jharvey/FPGA_CAM-LCD/README.md

## Phase order (do not skip)

1. Cleanup / hierarchy (done / finishing)
2. Power input redesign (3×18650)
3. Camera + display connectors/sheets
4. Mechanical outline / placement
5. BOM + JLCPCB

## When unsure

- Ask before deleting anything on `power`, `usb`, `ram`, `flash`, or `wifi`.
- Prefer “mark for deletion” + commit message over silent large deletes.
- Reference `ROADMAP.md` for locked decisions.
