jharvey/FPGA_CAM-LCD/ROADMAP.md

# Monocular FPGA Vision Device – Roadmap

**Repo**: https://github.com/jharvey/FPGA_CAM-LCD  
**Branch**: `monocular-strip`  
**Base**: ULX3S open hardware (emard)  
**Goal**: Single-board monocular with ECP5 + OV7670 + Newhaven 2.1" TFT + 3×18650 + USB charging + WiFi + SD

---

## Current status

| Phase | Description | Status |
|---|---|---|
| 0 | Architecture decisions locked | Done |
| 1 | Branch created, cleanup | Done |
| 2 | Power input redesign (3×18650 + monitoring) | **Done** – schematic frozen (CE drive later) |
| 2b | USB-C 5 V PD trigger | **Done** – CH224K 5 V-only sink on the USB-C port (schematic) |
| 2c | Single USB-C (power + SD + programming) | **Done** – ESP32-S3 native USB, USBLC6 ESD, FTDI/micro-B fallback DNP (schematic) |
| 3 | Camera + display connectors / sheets | **Done** – schematic frozen |
| – | **Schematic freeze** | **Frozen** – ERC fully classified, see `doc/constraints/schematic_freeze.md` |
| 3b | IMU (6-axis) | **Done** – ICM-42688-P on I²C to FPGA (schematic) |
| 3c | RC servo headers | **Done (DNP)** – 6× 1x3 headers on `servo` sheet; SERVO_V source open |
| 4 | PCB mechanical outline (monocular form) | **In progress** – placement complete; routing step 1 done (rules, planes, fan-out, decoupling – 4.11); next: high-speed nets |
| 5 | BOM / JLCPCB / first prototype | Pending |

---

## Decisions (locked)

- Full single PCB (not shield)
- Keep ECP5-85F, SDRAM, flash, WiFi, SD card
- **One USB-C port** for power/charging, SD card (USB MSC) and programming; the ESP32-S3 (native USB) is the USB device and the ECP5 programmer (Phase 2c). FTDI / micro-B kept only as DNP fallback
- Remove GPDI, large GPIO headers, audio
- 3 independent 18650 cells with ideal-diode OR-ing (LM66100), hot-swap capable
- Cell interface: PCB-mounted Keystone-style contacts per cell – positive button **MY-18650-04-J (LCSC C19184125)**, negative spring **MY-18650-05-J (LCSC C19184124)** (MYOUNG); replaces the JST-PH placeholders
- Per-cell reverse-polarity protection (AO3401A) + TP4056 chargers
- **8-channel ADC**: AD7689 (16-bit, SPI) replaced ADS1115; absolute 2.5 V reference so measurements are non-ratiometric
- ADC channels used for: per-cell voltages, NTC / temperature, +V / VSYS rail sense, and spare channels
- ADC VDD from a small always-on 3.3 V LDO (XC6206 → VADC) fed from VSYS; ADC VIO from +3V3 (matches ESP32 SPI levels)
- ST pins of all LM66100s tied to GND through 0 Ω links (removable later)
- VSYS = OR of (VBAT_OR + USB 5 V)
- Soft-shutdown path (Q2 / SHUT) retained
- Individual cell enable/control (CE pins) planned so the most-depleted cell can be consumed first (firmware-driven, later)
- Bulk capacitance after ideal-diode OR-ing for contact bounce / vibration
- Optional later boost stage to recover the bottom ~5–15 % capacity once cells fall below ~3.5 V
- Camera: OV7670 parallel + SCCB
- Display: NHD-2.1-480480AF-ASXP (40-pin FFC, RGB + SPI)
- Case: 3D-printed first → metal later

### Power / charging evolution
- **Near-term (done, Phase 2b)**: USB-C PD sink / trigger **WCH CH224K (LCSC C970725)** fixed to request **5 V only** on a new USB-C charge port. Keeps existing TP4056 linear chargers.
- **Longer-term**: Evaluate higher-voltage / higher-wattage PD path (9–20 V) together with switching chargers or a multi-cell charger IC for significantly higher total charge power.

### Sensors
- IMU added now (Phase 3b): TDK InvenSense **ICM-42688-P**, LCSC **C1850418** (JLCPCB extended part), I²C to the FPGA. See Phase 3b.

---

## Phase details

### Phase 1 – Branch & cleanup (NOW)
- [x] Create `monocular-strip` branch
- [x] Update `.gitignore`
- [x] Delete unused sheets: gpdi, gpio, analog, serdes (optionally blinkey)
- [x] Remove corresponding hierarchical blocks from root sheet
- [x] Commit: "strip unused ULX3S sheets for monocular"

### Phase 2 – Power input redesign
- [x] Replace single-cell input with 3×18650 paths
- [x] Per-cell: AO3401A reverse protection, TP4056 charger, LM66100 ideal diode
- [x] Cell connection changed from JST-PH (J8/J9/J10, **removed**) to PCB spring/button contacts, one pair per cell:
  | Cell | Positive button → `CELLn_RAW` (AO3401A drain) | Negative spring → GND |
  |---|---|---|
  | 1 | BT11 MY-18650-04-J (LCSC **C19184125**) | BT12 MY-18650-05-J (LCSC **C19184124**) |
  | 2 | BT21 MY-18650-04-J (C19184125) | BT22 MY-18650-05-J (C19184124) |
  | 3 | BT31 MY-18650-04-J (C19184125) | BT32 MY-18650-05-J (C19184124) |

  AO3401A / TP4056 / LM66100 path unchanged. Note on the power sheet: the contacts are for a plastic battery bay that provides mechanical retention and cell-length tolerance.
  - [ ] Phase 4: create/import footprints for BT11–BT32 (LCSC lists them as "SMT" in the title but "TH" in the attributes – confirm from the datasheet / EasyEDA model) and define the bay geometry (contact spacing for 65 mm cells + spring travel).
- [x] VBAT_OR + USB → VSYS via additional LM66100s
- [x] ~~ADS1115 (0x48) on WIFI_GPIO21/22~~ – superseded by AD7689 (below)
- [x] Always-on 3.3 V LDO from VSYS for the ADC (U20 XC6206 → VADC)
- [x] ST pins of all five LM66100s linked to GND via 0 Ω (R46, R47, R48, R51, R55)
- [x] TLV62569 inputs and wake circuit moved to VSYS
- [x] LCD backlight boost input renamed to VSYS
- [x] **Replace ADS1115 with 8-channel ADC** – U21 AD7689BCPZ, SPI to ESP32: SDO=WIFI_GPIO19, DIN=WIFI_GPIO21, SCK=WIFI_GPIO22, CNV=WIFI_GPIO26 (renumbered for the ESP32-S3 in Phase 2c: SDO=WIFI_GPIO6, DIN=WIFI_GPIO21, SCK=WIFI_GPIO8, CNV=WIFI_GPIO9; moved again in 4.23: SDO=WIFI_GPIO36, DIN=WIFI_GPIO48, SCK=WIFI_GPIO35, CNV=WIFI_GPIO47)
  - IN0–IN2: VBAT1–3 via 47 k / 56 k dividers (4.2 V → 2.28 V), 100 nF filter caps
  - IN3: TEMP_BAT, 10 k pull-up (R43) + 10 k NTC (TH1)
  - IN4: REF3025 (U17) output – absolute-reference cross-check
  - IN5: VSYS_SENSE via 100 k / 68 k (5.25 V → 2.13 V)
  - IN6, IN7 spare and COM tied to GND via 0 Ω (R57, R58, R59) – lift to use
- [x] Add resistor divider for +V / VSYS rail sensing into the new ADC (R44/R45 → IN5)
- [x] Absolute reference / non-ratiometric: AD7689 internal 2.5 V reference (REF + 10 µF C68, REFIN + 100 nF C70). Firmware must set CFG.REF = internal 2.5 V.
- [x] **ADC reference loading** – chose option (a): NTC pull-up R43 now fed from REF3025 OUT (`VREF_SENSE`) instead of the AD7689 REF pin. The conversion reference (`VREF_2V5`, internal 2.5 V + C68) carries no DC load; cell / VSYS readings stay absolute (non-ratiometric). NTC: compute the divider ratio as IN3 / IN4 – both channels see the same REF3025 voltage, so the NTC result cancels both reference tolerances. No firmware config change (AD7689 stays in internal-reference mode). Option (b) rejected: it needs a config change, makes REF3025 drive the REF pin's switched load, and gives up the ADC's lower-drift internal reference.
- [x] Bulk capacitance: VBAT_OR = C58 10 µF + **C73 100 µF 1210 (CL32A107MPVNNNE, LCSC C23742)**; VSYS = 3× 22 µF (C1/C5/C9) + C63 10 µF. Revisit at layout (X5R DC-bias derating).
- [x] **LM66100 ~CE break-out** – U12/U14/U18 ~CE now on local nets `BAT1_CE` / `BAT2_CE` / `BAT3_CE`, tied to `VBAT_OR` through 0 Ω links R71 / R72 / R73 (0603, C21189, fitted). Behaviour unchanged (plain ideal-diode OR); the 0 Ω pads are the rework point for later control.
  - Control constraint (LM66100 datasheet): the device turns OFF when ~CE > VIN + 80 mV and ON when ~CE < VIN − 250 mV (~CE max 5.5 V). Forcing a cell off therefore needs ~CE driven above that cell's voltage (up to ~4.3 V), so a 3.3 V ESP32/FPGA GPIO needs a level shifter (e.g. small PFET or open-drain + pull-up to a rail above the highest cell). Forcing ON (pulling ~CE low) can back-feed the other cells, so avoid it.
  - [ ] Later: pick GPIO source (ESP32 / FPGA / I²C expander) and the level-shift circuit, together with firmware cell prioritisation.
- [ ] Expose TP4056 CE / ~CHRG status (currently CE tied to +5 V, ~CHRG drives LEDs only)
- [x] Schematic clean-up: 4 dangling wire stubs fixed (PWREN ×3, VBAT1)
- [x] Final KiCad ERC run – done in the schematic-freeze pass (`doc/constraints/schematic_freeze.md`): 179 items, all classified acceptable or deferred to layout. Orphan `ADC_*` labels on `ram` kept (harmless, unconnected FPGA pins). The unused ADS1115 cache entry drops on the next save in KiCad.
- [ ] ~~Add USB-C PD sink/trigger chip~~ → moved to **Phase 2b** (below)
- [ ] (Optional later) Boost stage to extract remaining capacity below ~3.5 V

### Phase 2b – USB-C 5 V PD trigger
- [x] New sheet `usbc_pd.kicad_sch`. The board had no USB-C connector (US1 FTDI and US2 OTG are micro-B), so a **dedicated power-only USB-C charge port** was added; both micro-B data ports are unchanged.
  | Ref | Part | LCSC | Role |
  |---|---|---|---|
  | U23 | **WCH CH224K** (ESSOP-10) | **C970725** | USB PD sink controller, 5 V only |
  | J17 | GCT USB4125-GF-A, USB-C 6P power-only | C3151650 (JLC extended) | charge port, footprint `USB_C_Receptacle_GCT_USB4125-xx-x_6P_TopMnt_Horizontal` |
  | D55 | SS34 Schottky 3 A / 40 V (SMA) | C8678 | VBUS_C → `+5V` OR-ing, parallel to D8/D9 |
  | R84 | 1 k 0603 | C21190 | VBUS_C → CH224K VDD (shunt regulator) |
  | C79 | 1 µF 0603 | C15849 | CH224K VDD decoupling |
  | R85 | 10 k 0402 | C25744 | CH224K VBUS sense |
  | C80 | 10 µF 0805 | C15850 | VBUS_C bulk |
- [x] **5 V only:** CH224K level mode – **CFG1 (pin 9) tied directly to VDD** (= request 5 V), CFG2/CFG3 to GND. No CFG1 resistor: a resistor or open CFG1 would select 9/12/15/20 V. Marked on the sheet.
- [x] PD-only mode (datasheet §5.5): DP shorted to DM on the CH224K, not wired to the connector. CC1/CC2 go straight to the CH224K (Rd is internal – the external 5.1 k in the WCH reference is only for the CH221K). PG unused. `#FLG03` marks PD_VDD as a supply for ERC.
- [x] TP4056 path unchanged: `VBUS_C` only joins `+5V` through D55, like the existing micro-B inputs.
- [ ] Phase 4: J17 at the case edge; keep the VBUS_C → D55 → +5V path wide enough for 3 A. (J17 became the USB 2.0 data + power port in Phase 2c; the micro-B paths D8/D9 are DNP.)

### Phase 2c – Single USB-C: power + SD card + programming
**Decision:** replace the classic ESP32-WROOM-32 (no native USB) with an **ESP32-S3-WROOM-1-N8R2** and make it the only USB device on the one USB-C port. Rejected: USB hub + FT231X + separate USB card-reader IC (more parts, and the SD card would need a bus switch between the reader, ESP32 and FPGA).

| Ref | Part | LCSC | Role |
|---|---|---|---|
| U9 | **ESP32-S3-WROOM-1-N8R2** (8 MB flash, 2 MB quad PSRAM) | **C2913204** | USB device (CDC + MSC), WiFi/BLE, SD host, ECP5 JTAG programmer |
| J17 | **HCTL HC-TYPE-C-16P-01A** (USB 2.0 USB-C) | **C2894897** | single port: VBUS/CC (power) + D+/D− (data); replaces the 6P power-only connector |
| U24 | **USBLC6-2SC6** | **C7519** | ESD on D+/D−/VBUS |
| U23 | CH224K (unchanged) | C970725 | 5 V-only PD sink on CC1/CC2 |
| B3 / B4 | PTS645 tact switch | C285463 | BOOT (GPIO0) / RESET (EN) for USB download-mode recovery |
| C81 | 1 µF 0603 | C15849 | EN RC delay required by ESP32-S3 |
| R86 | 10 k 0402 | C25744 | SD card-detect pull-up |
| SD1 | Molex 104031-0811 microSD (existing socket) | C585350 | card-detect pin 10 now wired (`SD_CD`) |

- **USB data path:** J17 D+/D− (A6/B6, A7/B7 joined) → U24 → `USB_DP`/`USB_DN` → ESP32-S3 GPIO20/19. **CC1/CC2 stay on the CH224K**, which runs in PD-only mode (its DP/DM shorted together, not connected to the bus), so PD and USB data coexist. VBUS still feeds `+5V` only through D55, so the TP4056 chargers are unchanged; no higher-voltage path.
- **Programming the ESP32-S3:** built-in USB-Serial-JTAG (CDC console + flashing, no DTR/RTS). If application firmware switches the PHY to TinyUSB (CDC + MSC), recover with **BOOT (B3) + RESET (B4)** → ROM download mode.
- **SD card ownership: ESP32-S3** (SDMMC 4-bit, same GPIO numbers as before: CLK 14, CMD 15, D0 2, D1 4, D2 12, D3 13; card detect `SD_CD` on GPIO10, low = card present). Exposed to the PC as **USB Mass Storage** by the S3 firmware. The FPGA bank-6 SD pins (and N5 for `SD_CD`) remain connected: the FPGA bitstream must keep them Hi-Z while the S3 owns the card.
- **Programming the ECP5 over the same USB-C:** the ESP32-S3 drives the existing JTAG nets (current pins, see 4.41: `JTAG_TCK` GPIO18, `JTAG_TDO` GPIO8, `JTAG_TMS` GPIO9, `JTAG_TDI` GPIO10) to load SRAM or program the config flash through the FPGA (esp32ecp5 / openFPGALoader-style bit-bang, triggered over USB CDC or WiFi). No second USB interface.
- **ESP32-S3 GPIO map:** EN = `WIFIEN`; GPIO0 `WIFI_GPIO0` (BOOT, R56 pull-up, FPGA F1); UART0 TXD/RXD to the FPGA (`WIFI_TXD`/`WIFI_RXD`); ADC SPI SDO 6 / DIN 21 / SCK 8 / CNV 9; FPGA links GPIO1 (E9), GPIO40 (N3), GPIO41 (E6). Nets renamed to the S3 GPIO numbers: `WIFI_GPIO19→6`, `22→8`, `26→9`, `25→1`, `27→40`, `35→41`. Strapping pins 3/45/46 and GPIO35–37 left unconnected. *(Superseded by the 4.23 remap; current table in `fpga/ESP32_PINS.md`.)*
- **Side benefit:** the ESP32 no longer shares the display SPI pins (`GN12/GP12/GN13/GP13`), so that Phase 3 limitation is gone.
- **Fallback (DNP):** FT231X bridge U6 with micro-B US1 (the old USB-serial + JTAG path), FPGA-USB micro-B US2 and their parts (D8, D9, R9, R40, R49, R50, R52, R53, R54, R63, R64, D20, D21, D23–D26), and the 2×3 JTAG header **J4**. Populating U6 + US1 restores the original ULX3S programming path (the ESP32-S3 must then release the JTAG lines).
- [ ] Limitations / to do: no VBUS-detect GPIO on the S3 (self-powered device; add one if strict USB compliance is needed); S3 USB is full-speed (12 Mbit/s), so MSC throughput is roughly 1 MB/s; firmware work: TinyUSB CDC + MSC composite, SDMMC, JTAG bit-bang for the ECP5. Phase 4: J17 + B3/B4 reachable from the case, S3 antenna at a board edge.
- Full higher-voltage / higher-wattage PD charging (9–20 V + switching or multi-cell charger) remains a **Later** item.

### Phase 3 – Camera & Display
- [x] Add OV7670 connector / sheet
- [x] Add 40-pin FFC for Newhaven TFT
- [x] Map pins (reuse known mappings from existing projects)
- [x] Split former `LCD-Camera` sheet into dedicated `camera` and `display` sheets (residual renamed `fpga-io`)
- [x] Constraints note for later FPGA work → `doc/constraints/camera_display_pinmap.md` (ball / bank table for J7 + J1, all LVCMOS33)
- [x] J7 pinout checked against NHD datasheet (RGB666 + SPI, IM[2:0]=001); local VDD decoupling C74/C75 added
- [x] Backlight boost U8 (AP3032) on VSYS, 100 mA set by R19 2R0, CTRL pulled down (R18)
- [x] OV7670 J1 pinout checked (standard 18-pin module); SCCB pull-ups present
- [x] VCCIO for display banks 0/7 fixed at 3.3 V (RV2 DNP, RV3 fitted); legacy header J2 DNP

- [x] **CAM_PCLK on a clock pin** – swapped `GP16`/`GP17` on the `camera` sheet: CAM_PCLK now on L16 (GR_PCLK3_0), CAM_PWDN (with R17) on N16
- [x] **J6 legacy 2×20 header** – DNP (kept in schematic/layout like J2; keep/drop decided at layout). D51/D52 5 V links to the header are DNP as well.
- [x] **J5 VCCIO jumper (power sheet)** – DNP; VCCIO for banks 0/7 is hard-set to 3.3 V by RV3

- [x] **User I/O for the monocular** – 2 buttons + 2 status LEDs on `fpga-io` (besides power button B0):
  B1/B2 PTS645 (C285463) active-low on `BTN1n` (E8) / `BTN2n` (D8), 10 k pull-ups R67/R68;
  D53/D54 0603 red (C2286) active-high on `LED0` (B2) / `LED1` (C2) via 1 k R69/R70.
  Orphan ULX3S labels removed (`SW3/4`, `LED2..7`, 12× `AUDIO_*`); those U1 pins plus D9 now carry no-connect flags.
- [x] **ERC clean-up (+5V)** – D51/D52 DNP (follow J6); `#FLG02` PWR_FLAG added on `+5V` at U16 VIN (power sheet), since +5V is only fed through the D8/D9 diodes from USB VBUS. `fpga-io` now shows only the intentional `CAM_XCLK` alias warnings.

**Carried into Phase 4**
- [ ] B0/B1/B2 footprint `Button_Switch_SMD:SW_SPST_PTS645` no longer exists in the KiCad 10 library (now e.g. `SW_SPST_PTS645Sx43SMTR92`) – pick the variant matching LCSC C285463 (and the case: top vs side-actuated) during placement.
- [ ] LED colour / brightness: D53/D54 reuse the red charge-LED part; 1 k at 3.3 V ≈ 1–1.5 mA (kept dim, the LEDs sit near the eyepiece). Revisit with the case design.

**Verify (no schematic change expected)**
- [ ] U8 uses the `AP3019AKTR` symbol with value AP3032KTR-G1 – confirm identical SOT-23-6 pinout; confirm L4 4.7 µH against the AP3032 datasheet recommendation.
- [ ] J7 footprint is Hirose FH12-40S-0.5SH; NHD recommends Molex 54104 (datasheet lists both -4031 and -4096). Pick contact side (top/bottom) once the FPC fold direction is fixed in Phase 4.
- [ ] LCD VDD = +3V3 is at the panel's 3.3 V maximum (typ 3.0 V) – accepted, note only.
- [x] ~~ESP32 IO32/IO33 share LCD_SCK/LCD_DC~~ – resolved in Phase 2c (ESP32-S3 no longer connected to the display SPI lines).

**Sheet map (camera / display area)**

| Sheet file | Contents | Connects via |
|---|---|---|
| `display.kicad_sch` | J7 NHD-2.1-480480AF-ASXP 40-pin FFC, C74/C75 VDD decoupling, backlight boost U8 AP3032 (L4, D1, C37, C38, R18, R19) from VSYS | Global `GN0..13`/`GP0..13` (RGB, sync, SPI, reset), `GP13` (BL PWM), `+3V3`, `VSYS`, `GND` |
| `camera.kicad_sch` | J1 OV7670 2×9 header, SCCB pull-ups R7/R14, R15 XCLK series, R16/R17, C18/C36 decoupling | Global `GN14..17,21..24`/`GP14..17,21..24` (XCLK via `GN16`, net named `CAM_XCLK`), `+3V3`, `GND` |
| `fpga-io.kicad_sch` | U1 ECP5 bank units (BANK0/7 and BANK1 I/O), user I/O (B1/B2 buttons, D53/D54 LEDs), legacy ULX3S headers J2 and J6 and their D51/D52 5 V links (all DNP) | Global labels to the sheets above |

Local labels (`LCD_*`, `CAM_*`) are descriptive aliases on each sheet; the `GN*`/`GP*` global labels carry the connections.

### Phase 3b – IMU (moved from stretch goals)
- [x] Part: TDK InvenSense **ICM-42688-P** (6-axis gyro + accel, LGA-14 2.5×3 mm), LCSC **C1850418**, JLCPCB assembly: extended part (stock to re-check at order time)
- [x] New sheet `imu.kicad_sch` (U22); symbol in project library `symbols/fcl_local.kicad_sym` (KiCad 10 has none); footprint `Package_LGA:LGA-14_3x2.5mm_P0.5mm_LayoutBorder3x4y` (pad pattern matches DS-000347 pin-out)
- [x] Power: VDD + VDDIO from +3V3; decoupling per datasheet Table 10 – C76 100 nF (C1525) + C77 2.2 µF (C87995) on VDD, C78 10 nF (C15195) on VDDIO
- [x] Interface: **I²C, dedicated bus to the FPGA** (separate from the RTC bus, so it can run at up to 1 MHz), AP_CS = VDDIO selects I²C, address **0x68** (AP_AD0 = GND), 4.7 k pull-ups R76/R77 (C25900)
  | Net | IMU pin | FPGA ball | Bank |
  |---|---|---|---|
  | `IMU_SCL` | 13 AP_SCL | E7 (PT9A) | 0 |
  | `IMU_SDA` | 14 AP_SDA | D7 (PT9B) | 0 |
  | `IMU_INT1` | 4 INT1 | C1 (PL38A) | 7 |
  | `IMU_INT2` | 9 INT2/FSYNC/CLKIN | D1 (PL38B) | 7 |
  (FPGA pins reuse balls freed in Phase 3. INT2 pin can instead be used as FSYNC, e.g. camera frame sync from the FPGA; the ESP32 can reach the IMU through the FPGA.)
- [ ] Phase 4: place U22 rigidly near the board's centre of mass, away from the boost inductor / switching regulators; record its axis orientation relative to the camera optical axis.

### Phase 3d – Magnetometer / compass (2026-11-12)
- [x] Part: ST **LIS2MDL** (3-axis, ±50 gauss, LGA-12 2×2 mm, 1.71–3.6 V). LCSC **C919695**, JLCPCB extended part; stock looked thin, so re-check at order time. KiCad library symbol `Sensor_Magnetic:LIS2MDL` and footprint `Package_LGA:LGA-12_2x2mm_P0.5mm`. U25 on `imu.kicad_sch`.
- [x] Bus: shares the IMU I²C (`IMU_SCL`/`IMU_SDA`, pull-ups R76/R77). Address **0x1E**, which does not clash with the IMU at 0x68. CS (pin 3) tied to +3V3 selects I²C.
- [x] `MAG_DRDY` (pin 7 INT/DRDY) goes to FPGA ball **L17** (PR50B), the free ball beside IMU_SDA (K17) on the same bank. It can be remapped when routing.
- [x] Per datasheet DS12144 §5: **C86 220 nF** (C326805) low-ESR right at pins 5/6, which carry high current pulses. **C87 100 nF** (C1525) + **C88 10 µF** (C15850, ceramic instead of the datasheet's aluminium) at pin 9 Vdd. **C89 100 nF** at pin 10 Vdd_IO. NC pins 2/11/12 are left open (datasheet: internally not connected).
- [x] PCB: footprints added and linked to the schematic, nets set, solder-mask margin 0 like U22. First placement is the nearest free F.Cu spot to U22, about (16.4, 5.0), next to the power-button parts. Not routed.
- [ ] Placement: keep away from L1–L3/L4, charger/power-path and servo current paths and from the 18650 cans as far as the board allows. Nothing high-current under it.
- [ ] Firmware: hard/soft-iron calibration in the finished case (the steel cells are a large fixed distortion). Take headings while the servos and charger are quiet, or compensate. Record the U25 axes relative to U22 and the camera axis.

### Phase 3e – Barometer, distance, microphone, speaker, test points (2026-11-12)
New sheet `peripherals.kicad_sch` (page 13). On the PCB, all parts are parked as grouped rows just left of the board's top-left corner (BARO, TOF, MIC, AMP, TP), ready for hand placement. Not routed.
- [x] **Barometer U26 ST LPS22DF** (HLGA-10 2×2 mm, LCSC C3253714). On the IMU I²C bus, SA0 to GND → address **0x5C** (clear of IMU 0x68, compass 0x1E). CS to +3V3 (I²C mode). INT goes to `BARO_INT` on FPGA **M17**. C90/C91 100 nF at Vdd/Vdd_IO. PCB clearance local 0.12 mm (corner pads 0.133 mm apart).
- [x] **Time-of-flight distance U27 ST VL53L1X** (LCSC **C190004**, 4 m range). IMU I²C at default **0x29**. `TOF_XSHUT` from FPGA **N16** (10k pull-up R88 keeps it on), `TOF_INT` (GPIO1) to FPGA **N17**, 10k pull-up R89. C92 100 nF + C93 4.7 µF. Needs a clear window/cover glass in the case over the sensor.
- [x] **Microphone MK1 TDK ICS-43434** (I²S MEMS, LCSC C5656610). L/R to GND (left slot). SCK/WS/SD on `I2S_BCLK`/`I2S_WS`/`I2S_MIC`, which go to ESP32 GPIO35/36/38. C94 100 nF. Bottom-port part: needs a hole through the board under its port, plus a case opening.
- [x] **Speaker amp U28 Maxim MAX98357A** (I²S class D 3.2 W, LCSC C910544), powered from **VSYS** with C95 100 nF + C96 10 µF. Shares BCLK/WS with the mic; DIN on `I2S_SPK` (GPIO37). SD_MODE on `AMP_SD` (GPIO47) with R87 100k to GND, so it stays off until the ESP32 drives the pin high. GAIN_SLOT open = 9 dB. Speaker on **J8** JST-SH 2-pin (C160388). Keep OUTP/OUTN short and wide, away from the mic and analogue parts.
- [x] **Test points TP1–TP13** (1 mm pads, not in BOM): GND×2, +3V3, +1V1, +2V5, VSYS, +5V, IMU_SCL, IMU_SDA, FPDI_SCL, FPDI_SDA, WIFI_TXD, WIFI_RXD.
- [ ] Place and route all of the above; drill the mic port hole; check the I²C bus load (4 devices + pull-ups R76/R77).
- [ ] .lpf/firmware: add M17/N16/N17 (and L17) to the FPGA constraints when used; ESP32 I2S driver on 35/36/37/38, AMP_SD on 47.

### Phase 3c – RC servo headers (DNP for first prototype)
- [x] New sheet `servo.kicad_sch`: 6× 1x3 2.54 mm headers **J_SRV1–J_SRV6** (`PinHeader_1x03_P2.54mm_Vertical`), **all DNP**
- [x] Pinout (standard RC servo): **1 = Signal** (1–2 ms pulse), **2 = +V (`SERVO_V`)**, **3 = GND**
- [x] Signals from FPGA bank 6 (3.3 V, not used by camera/display) through 1 k series resistors R78–R83 (0603, C21190, **DNP with the headers** – protects the FPGA pin if a servo lead is miswired):
  | Header | Net | FPGA ball |
  |---|---|---|
  | J_SRV1 | `SRV_PWM1` | P1 |
  | J_SRV2 | `SRV_PWM2` | P2 |
  | J_SRV3 | `SRV_PWM3` | P3 |
  | J_SRV4 | `SRV_PWM4` | P4 |
  | J_SRV5 | `SRV_PWM5` | N2 |
  | J_SRV6 | `SRV_PWM6` | J4 |
  (these balls previously carried the orphan ULX3S `OLED_*` labels, now repurposed)
- [ ] **Open decision – SERVO_V source.** `SERVO_V` currently only joins the six header pin 2s. Options: jumper / 0 Ω link to VSYS (simple, but servo stall current – often > 1 A each – then loads the cells and the LM66100 path), or a dedicated 5–6 V regulator. Decide before the servo headers are populated; size copper and connector for the chosen current.
- [ ] Phase 4: keep footprint space for J_SRV1–6 + R78–R83 near a board edge (they are DNP but on the PCB); header LCSC part still to pick.

### Phase 4 – Mechanical & PCB

#### 4.1 Locked mechanical decisions (2026-11-07)
Reference renders: `Pic_LCD_ISO.png` (eye side) and `Pic_Cam_ISO.png` (scene side).
**Coordinates:** front view = looking at the scene/camera side; origin = top-left board corner, +X right, +Y down, mm.
**Front = PCB top layer (F)**, faces the scene. **Back = bottom layer (B)**, faces the eye.

**1. Optical axis – LOCKED: perpendicular to the PCB** (option (a)).
- Front (F): OV7670 module mounted **flat, parallel to the board**, lens forward, plugged into J1 (vertical 2×9 socket; module header pins point into the board).
- Back (B): 3×18650 battery bay; the round TFT sits on top of the bay facing the eye.
- The axis passes through the **board centre (42.5, 37.5)**: camera lens centre and TFT active-area centre are **coaxial** (target ±0.5 mm), so no software parallax offset is needed.

**2. Outline – LOCKED: 85.0 × 75.0 mm**, rectangle with R3 corners, 1.6 mm, **4 layers** (ULX3S-derived stack-up and BGA 0.8 mm rules).
- M3 holes H1 (4, 4), H3 (4, 71), H4 (81, 71). **H2 (81, 4) removed from the rev-A board** (*Exclude from board*): that corner is inside the ESP32-S3 antenna keep-out, which forbids any footprint; the case supports the corner with a ledge, which also keeps a metal screw away from the antenna. The cells are held by the bay, not the PCB, so 3 screws are enough.
- **Fresh PCB:** the ULX3S placement/routing in `FCL.kicad_pcb` is not reused (different outline, most parts gone).

| Fit check | Needed | Available |
|---|---|---|
| Cell + contacts along X | 18650 65.0 mm (protected cells up to ~69.5) + spring ~5 + button ~1.5 → bay ≈ 72–76 mm | 85 mm (≈ 5 mm margin each side) |
| 3 cells stacked along Y | 3 × 18.6 + 2 × 1.9 gap = 59.6 mm (row pitch **20.5**, refined in 4.4) | 75 mm (≈ 7.7 mm strip top and bottom) |
| Depth (front → back) | lens ≈ 25 (socket 8.5 + module 1.6 + lens ~15) + PCB 1.6 + bay standoff 1.5 + cell 18.6 + TFT ~3 | ≈ 50 mm + case walls |

**3. Component positions – LOCKED (zones; exact XY during placement)**

| Item | Side | Position (front view) | Notes |
|---|---|---|---|
| OV7670 module + J1 | F | lens on the axis (42.5, 37.5); keep-out ≈ 35 × 35 mm centred on it, ≈ 25 mm tall | J1 position = axis minus the module's lens-to-header offset (measure the module). Parts ≤ 6 mm tall may sit under the module. |
| Round TFT | on the bay (B side) | active-area centre on the axis | outline + FPC exit/length from the NHD drawing (datasheet p.3) – still to measure |
| Display FFC J7 | B | bottom edge, centred (x ≈ 42.5, y ≈ 70–73) | FPC leaves the display bottom and folds down past the bottom cell; the fold fixes the FFC contact side. If the FPC is too short: J7 moves to the F bottom edge with the FPC wrapping the board edge. Backlight boost (U8, L4, D1, C38, R19) next to J7. |
| 18650 cells 1/2/3 | B | rows y = **17.0 / 37.5 / 58.0** (pitch 20.5, symmetric about the axis), axes along X | cell 1 top, cell 3 bottom |
| − springs BT12 / BT22 / BT32 | B | left end, x ≈ 6 | common GND – wide GND pour |
| + buttons BT11 / BT21 / BT31 | B | right end, x ≈ 79 | each → `CELLn_RAW` → Q3/Q4/Q5 on F directly behind |
| Power input stage (Q3–Q5, U11/U13/U15 TP4056, LM66100 U12/U14/U16/U18/U19, sense dividers, ADC U21, REF U17) | F | right strip, x ≈ 62–85 | short cell paths; TP4056 heat kept away from the IMU and camera |
| NTC TH1 | B | (36, 37.5) under the middle cell's bottom line | thermal pad to cell 2 (4.4) |
| FPGA U1 + SDRAM U2 + flash U10 + TLV62569 regulators | F | left strip, U1 centre (17, 28) rotated 90° CW, SDRAM below U1 | rotation puts banks 2/3 (SDRAM + camera) at the bottom and bank 1/0 toward the centre; x ≥ 8 keeps the BGA clear of the spring-contact tabs that come through the board at x ≈ 5.5 |
| **IMU U22** | F | **on the optical axis, under the camera module (≈ 42.5, 37.5)** | board centre = most rigid point; away from TP4056/boost heat; record its axes relative to the camera |
| ESP32-S3 U9 | F | top-right, antenna at the top edge (y < 7) | antenna keep-out on all layers; no cell behind it (cells start at y ≈ 8.7); case needs an RF window |

**4. Edge-accessible parts – LOCKED**

| Edge | Parts |
|---|---|
| Bottom | J17 USB-C (F, x ≈ 62, mouth flush with the edge), SD1 microSD (F, x ≈ 25, Molex 104031 card slot ≈ 1 mm inside the edge, card protrudes ≈ 3 mm), J7 FFC (B, centre, cable entry from the edge), servo headers J_SRV1–6 (F, bottom-right block ≈ 16 × 8 mm, DNP but footprints kept – next to the power stage for future `SERVO_V`) |
| Top | B0 power, B1 / B2 user buttons, D53 / D54 status LEDs (F, top-left to centre); ESP32-S3 antenna (top-right) |
| Internal (no edge needed) | B3 BOOT / B4 RESET (near U9, may sit behind case pin-holes), J3 WIFI_OFF, BAT1 CR1225 (F) |
| Not on the rev-A PCB | J2, J6 legacy 2×20 headers (DNP, ≈ 51 mm long – do not fit) → set *Exclude from board*. DNP fallbacks U6/US1/US2/J4: keep footprints only if space remains after placement. |

#### 4.2 First board outline + mechanical placement (done 2026-11-07, not routed)
`FCL.kicad_pcb` was rebuilt from scratch (ULX3S placement/routing, tracks, zones and nets removed; 4-layer stack-up and design rules kept). Board origin = page (100, 100) = top-left corner; drill/grid origin set there. Coordinates below are board mm, front (top) view.

| Ref | Side | Position | Notes |
|---|---|---|---|
| Outline | – | 85.0 × 75.0, R3 corners | Edge.Cuts |
| H1 / H3 / H4 | – | (4, 4) / (4, 71) / (81, 71) | M3 ISO14580 pad; H2 excluded (antenna corner) |
| U22 IMU | F | (42.5, 37.5) – on the optical axis | under the camera module |
| J1 camera socket | F | pad centroid (42.5, 52.5), 2×9 along X | 15 mm lens-to-header offset is provisional – measure the OV7670 module |
| U1 ECP5 | F | (17, 28), rot −90 | courtyard x 7.9–26.1 |
| U9 ESP32-S3 | F | (68, 12.75), antenna at the top edge | library keep-out zone kept (no copper/footprints x 44–92, y < 6) |
| J7 display FFC | B | (42.5, 69.1), opening toward the bottom edge | |
| J17 USB-C | F | (62, 70.7) | |
| SD1 microSD | F | (25, 68.3), rot 180 | new footprint `fcl_local:microSD_Molex_104031-0811_FCL` |
| B0 / B1 / B2 | F | (14, 5.5) / (25, 5.5) / (36, 5.5) | top edge |
| J4 JTAG (DNP fallback) | F | (49, 12) | below the antenna band |
| TH1 NTC | B | (36, 37.5) | under cell 2 (moved in 4.4) |
| BT12 / BT22 / BT32 (− springs) | B | x 5.5, y 17 / 37.5 / 58 | spring tips reach x ≈ 18 (≈ 5.8 mm compression with a 65 mm cell) |
| BT11 / BT21 / BT31 (+ buttons) | B | x 79.5, y 17 / 37.5 / 58 | foot-to-foot 74 mm |

Reference drawings: optical-axis crosshair (Dwgs.User), OV7670 35 × 35 keep-out (F.Fab), three 65 × 18.6 cell outlines and a nominal Ø53.3 TFT circle (B.Fab).

Footprint work done for this step:
- 18650 contacts: real EasyEDA footprints + STEP models for **MY-18650-04-J (C19184125)** and **MY-18650-05-J (C19184124)** in `footprints/fcl_local.pretty` / `fcl_local.3dshapes` – both are **through-hole** (slotted tab + two SMD anchor pads).
- microSD: `fcl_local:microSD_Molex_104031-0811_FCL` (KiCad's Molex 104031-0811 pattern, pad 9 renamed GS4, shield tabs GM1–GM4 to match the SD1 symbol). The old dual SCHD3A0100/104031 footprint put extra pads past the card opening. Symbol pins 11, 12 (NC) and GS1–GS3 (extra GND) have no pads – *Update PCB* lists them as warnings.
- All 14 footprint-link issues fixed (PTS645 → `SW_SPST_PTS645Sx43SMTR92`, `MountingHole:` library, 2.54 mm sockets, RV2/RV3 pad name); J2/J6 and H2 set *Exclude from board*.

DRC after placement (mechanical categories): no courtyard overlaps, no keep-out violations, no edge-clearance violations. Remaining items are for the routing phase: pad-to-pad clearance / solder-mask bridges inside the fine-pitch U22 (0.5 mm LGA) and J17 (USB-C) with the inherited 0.2 mm clearance rule, J17 pad-to-peg hole clearance (footprint-inherent), and silkscreen cosmetics.

#### 4.4 Battery bay, NTC, IMU and mechanical-stress constraints (2026-11-07)
**Cell contacts (confirmed):**
- Three identical pairs, **all cells the same way round**: − springs (MY-18650-05-J) at the left end x 5.5, + buttons (MY-18650-04-J) at the right end x 79.5; both stand on the back (B) and face the cell (checked in the 3D render). Reverse insertion is protected electrically by the AO3401A FETs; the bay should still carry "+ →" moulded marks.
- Row pitch widened 19.5 → **20.5 mm** (rows 17 / 37.5 / 58): 1.9 mm gap between cans leaves room for 1.6 mm printed ribs.
- Length: contact bases 74.0 mm apart; spring tip x ≈ 18.0, button face x ≈ 77.2 → 59.2 mm free gap. A 65.0 mm cell compresses the spring ≈ 5.8 mm of ≈ 12.4 mm free length. **Usable cell length ≈ 65.0–67.5 mm** (flat or button-top, unprotected). **Protected 69–70 mm cells do not fit.** Dimensions are from the EasyEDA footprints – confirm spring free/solid length on the MY-18650-05-J drawing.

**Battery bay (case part) – reserved on the PCB back as rule areas (no B-side footprints; tracks allowed):**

| Rule area | Region (x, y) | Purpose |
|---|---|---|
| `BAY_END_WALL_L` | 0.3–3.3, 8–67 | wall behind the springs takes the spring load |
| `BAY_END_WALL_R` | 82.3–84.7, 8–67 | wall behind the buttons |
| `BAY_RIB_1` / `BAY_RIB_2` | 19–76, y 27.25 ± 0.9 / 47.75 ± 0.9 | 1.6 mm ribs between cells rest on the PCB (also stiffen the board centre) |
| `CASE_BOSS_TR` | 78.5–84.7, 3.5–9 | case boss / ledge replacing the removed H2 at the antenna corner |

- Cradle height: cells sit **2.5 mm above the PCB** → B-side parts under the cells ≤ **1.5 mm** tall (0402–0805 passives, SOT-23 OK; no inductors / electrolytics / tall connectors under the bay).
- The bay's bottom side-wall must **bridge x ≈ 28–57** (no contact with the PCB) where J7 and the TFT FPC pass; J7 sits ≈ 7 mm below the bottom cell's edge.
- Notes for the bay are on Dwgs.User beside the board outline; bay outline and rib lines on B.Fab.

**NTC (TH1):** *(superseded by 4.8 – three NTCs beside the − springs)* moved to (36, 37.5) on B, under the bottom line of the middle cell (cell 2 – the warmest, surrounded by the other two). Thermal coupling through a **2 mm compressible silicone thermal pad** (≈ 3 W/m·K, ≈ 5 × 5 mm) between TH1 and the can; nothing else in a 6 × 6 mm area around it. One NTC = bay temperature only, not per-cell.

**IMU (U22) – confirmed at (42.5, 37.5):**
- On the optical axis at the board centre: not at an edge, between the three screws and directly over the cell-2 cradle and both ribs, so the stiffest region once the bay is fitted.
- Distances as placed: FPGA courtyard ≈ 14.6 mm, ESP32-S3 module ≈ 15 mm (antenna ≈ 30 mm), USB-C / charge input ≈ 27 mm, display boost (U8/L4, next to J7) ≈ 30 mm.
- **Quiet radius 15 mm (F.Fab circle):** no switchers (TLV62569 + L1–L3, AP3032 + L4, TP4056s) or VSYS/charging high-current paths inside it; no vias/traces under the LGA; solid GND plane beneath; C76–C78 right at the part. The camera module sits ≈ 8.5 mm above it on J1 – fine for an IMU, but keep its mass secured (below).

**Vibration / mechanical-stress concerns (to design out in the case and placement):**
1. **Spring load:** 6 contacts at ≈ 5.8 mm compression push the board ends outward (order of 3–6 N each). The contact plates must bear on the bay end walls (`BAY_END_WALL_*`); the slotted THT tabs and SMD anchors must not carry the spring force.
2. **Top-right corner (no H2):** the top-row button contact BT11 loads a corner without a screw → the case boss/ledge `CASE_BOSS_TR` is mandatory.
3. **Camera module ≈ 25 mm tall on a friction-fit 2×9 socket:** a lever arm under vibration (socket fretting, intermittent pixels). Fix the module with its two M2 holes on standoffs (reserve them once the module is measured) or a case clamp.
4. **BGA (U1) next to the left-end springs:** board flex at the left edge stresses the BGA balls. U1 keeps ≥ 2.4 mm from the contact tabs; the left bay wall must be stiff and flush.
5. **USB-C J17:** plug insertion/levering at the bottom edge – THT shell legs help; the case should surround the receptacle so the case, not the PCB, takes side loads.
6. **TFT:** held by the bay/case, never by its FPC; FPC strain relief and minimum bend radius at the board edge; J7 latch closed.
7. **Heavy parts** (inductors, C73 100 µF 1210, J4 if fitted) not at the unsupported top-right corner or mid-span away from ribs.
8. **Hot-swap door:** opening/closing must not load the PCB; door hinge and latch on the case.
9. Firmware: run the IMU with a suitable low-pass / ODR so residual board resonance (plate modes between supports) is filtered.

#### 4.5 Netlist import + rough functional placement (2026-11-07, not routed)
- *Update PCB from Schematic* done in KiCad (after renumbering duplicate `#PWR01–04` on the camera sheet). All 21 pre-placed parts kept their positions.
- **Excluded from the rev-A board** (*Exclude from board*, DNP or obsolete; no room on 85 × 75): FT231X fallback U6 + micro-B US1/US2 and their parts (D8, D9, D20, D21, D23–D26, R9, R40, R49, R50, R52–R54, R63, R64); D51/D52 (5 V links for the already-excluded J6); J5 (obsolete VCCIO jumper); J3 WIFI_OFF header (its pins would enter the battery bay; B4 RESET and the FPGA's `WIFI_EN` cover it). **J4 stays as the JTAG fallback.**
- **RP1–RP3** (NC solder jumpers on the 1V1/2V5/3V3 rails, cut to measure current) now use `fcl_local:R_0805_Jumper_NC_NetTie` – the same copper-bridge jumper with pads 1–2 declared as a **net tie**, so DRC accepts the intentional short.
- 246 footprints, all inside the outline. Rough placement by functional group into the 4.1 zones (front unless noted):

| Group | Where |
|---|---|
| Flash U10, 25 MHz Y1, AE1, flash/config resistors | top-left above U1 |
| Regulators U3–U5, L1–L3, their caps and feedback | top-centre between U1 and J4 (outside the IMU quiet radius); feedback parts partly on B |
| SDRAM U2 | below U1 (15, 50); decoupling on B under U2 |
| FPGA decoupling, RV2/RV3 | B, under/next to U1 |
| RTC U7 + Y2, power-button / wake logic, D11 | around the IMU under the camera module (low-noise logic only) |
| CR1225 holder BAT1 | bottom-centre (43.5, 67.6) |
| IMU C76–C78, R76/R77 | ring around U22 |
| Camera R7, R14–R17, C18, C36 | just below J1 |
| Chargers U11/U13/U15, LM66100 U12/U14/U18/U19, Q3–Q5, sense dividers, C73, charge LEDs | right strip x ≈ 58–78 |
| ADC U21, REF U17, LDO U20 and passives | B, right end under cell 1 (all ≤ 1.5 mm) |
| USB-C group U24, R84, R85, C79, C80, U16, +5V caps | above / beside J17; CH224K U23 on B bottom strip; D55 right of J17 |
| Servo J_SRV1–6 (DNP) | 2 × 3 block x ≈ 59–77, y ≈ 48–61 (pins clear of `BAY_RIB_2` and the BT31 plate); R78–R83 on B |
| Display boost U8, L4, D1, C37, C38, R18, R19, C74, C75 | B bottom strip right of J7 (not under the cells) |
| BOOT/RESET B3/B4, button/LED/I²C pull-ups | B top strip (above the cells) |
| Status LEDs D53/D54 | F top edge next to B2 |

- Checks: no courtyard overlaps, no shorts, no keep-out / rule-area / edge violations; every back-side part under the cells is a low-profile package. DRC remaining: 199 solder-mask bridges + 13 clearance hits **all inside single fine-pitch parts** (U2, U21, J7, J17, U22, SOICs) → design-rule task; 499 unrouted connections; silkscreen overlaps (cosmetic). Schematic parity: only the 5 expected SD1 pins without pads (11, 12, GS1–GS3).
- **Placement concerns to address while refining:** the three TP4056s sit close together (up to ≈ 3 × 1.3 W at 1 A charge each) → spread them, add thermal vias/copper, or lower the charge current; FPGA decoupling should move directly under the BGA ball field once the fan-out is planned; silkscreen cleanup.

#### 4.6 Placement reset – controlled re-placement order (2026-11-07)
- The 4.5 rough placement was cleared: every footprint except the fixed/edge set below was moved **off the board** into a staging field below the outline (grouped by sheet, front side, 0°, servo headers last). Footprints keep their nets and schematic links, so nothing needs re-importing; they are brought back in a controlled order.
- **On the board (unchanged X/Y/rotation from 4.5; locked unless noted):**

| Part | Role | Note |
|---|---|---|
| SD1 | microSD at the bottom-left edge | locked, no rotation |
| J17 | USB-C at the bottom-right edge | locked, no rotation; nudged 0.15 mm up to clear the corner radius (edge clearance) |
| B0 / B1 / B2 | buttons, back top strip | **not locked** – may rotate, stay within ±0.5 mm |
| J7 | display FFC, back bottom edge | locked |
| J1 | camera header on the optical axis | locked |
| BT11–BT32 | 18650 spring/button pairs, rows 17 / 37.5 / 58 (pitch 20.5) | locked |
| H1 / H3 / H4 | M3 case screws | locked |

- Housing clearance: `CASE_BOSS_TR` trimmed to y 3.5–8.3 so BT11's top tab no longer intrudes; board outline and all bay rule areas otherwise unchanged.
- Re-placement order from here: U1 (FPGA) + U9 (ESP32-S3, antenna in the top-right keep-out) + U22 (IMU, axis) + TH1 + J4 → SDRAM / flash / clock → regulators → chargers / power path → ADC → USB-C and display support → passives/decoupling → servo headers (last).

#### 4.7 Digital core placement (2026-11-07, not routed)
- Digital section on the front, in the "near" digital zone: left strip (FPGA, SDRAM, flash, clock) plus the ESP32-S3 top-right. Analog/sensor items (IMU on the axis, ADC, chargers on the right) stay outside it; the inner GND plane is continuous under the digital block.
- Rotations and positions chosen by **ratsnest length** (MST of every signal net to the parts already on the board) with ≥ 1 mm routing channels between chips, ≥ 10 mm from the IMU spot, and clear of the BT tab slots, H1, SD1, J1 and the antenna keep-out. Comparing SDRAM *below* vs *above* the FPGA: above is ≈ 12 % shorter in total (U1 then sits nearer J1 / J7 for the camera and display buses), so the 4.1 "SDRAM below U1" note is superseded.

| Ref | Part | Position (board mm, F) | Rot | Note |
|---|---|---|---|---|
| U2 | SDRAM TSOP-54 | (17.0, 12.5) | 0° | top-left, above U1 |
| U1 | ECP5 BGA-381 | (22.0, 34.0) | 180° | box x 12.7–31.3, y 24.7–43.3; 11 mm from the IMU spot |
| U10 | config flash SOIC-8 | (29.0, 20.0) | 180° | between U2 and U1, next to the SPI-config bank |
| Y1 | 25 MHz oscillator | (25.0, 48.0) | 0° | below U1, next to the clock input |
| J4 | JTAG 2×3 (DNP fallback) | (37.0, 23.0) | 90° | between U1 and U9, outside the antenna band |
| U9 | ESP32-S3-WROOM-1 | (66.0, 12.75) | 0° | antenna flush with the top edge (moved 2 mm left of 4.2) |

- No USB bridge chip any more (FT231X excluded in 4.5; the ESP32-S3 native USB is the bridge).
- **Long nets left (straight-line MST):** SD bus SD_CLK/CMD/D0–D3/CD ≈ 73–90 mm (SD1 is fixed bottom-left, the ESP32 top-right, the FPGA taps the same bus) → route as a grouped bus down the left/centre on one inner-adjacent layer, keep the FPGA tap short or consider moving SD1 later; ESP32↔FPGA UART/SPI/GPIO (`WIFI_*`) ≈ 30–59 mm and JTAG ≈ 31–35 mm (low speed, OK); camera/display `GPn/GNn` ≈ 27–41 mm; SDRAM data ≈ 25–33 mm (length-match the SDRAM group during routing); BTN1n/BTN2n ≈ 41 mm to the top buttons (slow).
- DRC: no courtyard, keep-out, edge or short violations; parity unchanged (5 SD1 pins).

#### 4.8 Analog + power-management placement (2026-11-07, not routed)
- Far side = **right half (front) + back**, opposite the digital strip (U1/U2/U10/Y1 left, U9 top-right). Every part placed by minimum ratsnest to the already-placed pins, with: switchers, inductors and TP4056s ≥ 15 mm from the IMU spot; back-side parts under the cells ≤ 1.5 mm (0402–0805, SOT-23/363, TSOT, LFCSP, 1008 / SWPA3015 inductors); nothing on the bay ribs / end walls / boss; through-pad parts (TP4056 EP vias, BT tabs, H3/H4) treated as obstacles on both sides.

| Block | Side | Where (board mm) | Parts |
|---|---|---|---|
| Reverse FETs | B | next to each + button, x 75.5, y 15.5 / 36 / 56.5 | Q3/Q4/Q5 + C40/C42/C46 |
| Chargers | F | right strip below the ESP32, ≥ 3 mm apart for heat: U11 (64, 33.5), U13 (72.5, 37.5), U15 (73, 47) | + PROG R20/R22/R41, LEDs D2–D4 + R21/R23/R42, input caps C39/C41/C43 |
| Ideal diodes / power path | F | U12 (69, 28.5), U14 (74.5, 31.5), U18 (75, 52), U16 (70.5, 55.5), U19 (73.5, 55.5), C73 (67.5, 40) | + ST 0R links, CE links R71–R73, VSYS caps |
| USB-C input | F / B | U24 ESD (74.5, 64.5) F and D55 (67, 59.5) F next to J17; CH224K U23 (73.5, 70.5) B under J17 | + C79, C80, R84, R85 |
| Regulators | B | under cell 1, one column each: U3 (50.5, 13), U4 (56, 13), U5 (66, 10.5) with L1–L3 | + input/output caps, feedback RA/RB/Cff, RP1–RP3 net-tie jumpers |
| ADC + reference | B | under cell 3: U21 (61, 52), REF U17 (66.5, 52.5), LDO U20 (67, 56.5) – ≥ 6 mm from the J1 camera pins | + VADC/VREF decoupling, cell/VSYS dividers R24–R26, R36, R37, R39, R44, R45 + filter caps, NTC pull-ups R43/R60/R61 + C62/C82/C83 |
| Backlight boost | B (+F) | right of J7: U8 (53.9, 63.3), L4 (58.2, 63.2), D1 (57.7, 70.8) in the gap J7–H4; C38 (1206, 1.6 mm) on F directly above | + R18, R19, C37, C74, C75 |
| IMU | F | U22 on the optical axis (42.5, 37.5), rot 0 (X/Y = board X/Y) | C76–C78, R76, R77 ring |
| Power-on / wake / shutdown logic | F | bottom band below J1, x 38–61 | Q1, Q2, D10–D17, D27, R1–R8, R10, R13, R66, C13, C14, C60, D11, D12 |

**Battery NTCs (TH1–TH3, one per cell, read by U21 via `TEMP_BAT_CELL1–3`)** *(moved to the cell centres in 4.10)*: on the back at x 10, y 23.4 / 43.9 / 64.4 – directly beside each − spring (MY-18650-05-J; its courtyard covers x 3.8–18 so nothing can sit under the coil), 6.5 mm below its own cell axis. The NTC's second pin is GND, the same copper as the spring tab: pour GND from the spring tab to the NTC pad (short and wide) so the cell's − cap heats the NTC through the spring and tab. All three sit left of the U1 ball field (x < 12.7) so FPGA heat does not bias them; TH1 is under the SDRAM edge (low power). This replaces the 4.4 single-NTC thermal-pad spot at (36, 37.5).

- **Still staged off-board:** FPGA/SDRAM decoupling and rail caps (C16, C17, C19, C20, C25–C35, C47–C53, RV2, RV3 – go on B under U1/U2 with the BGA fan-out), RTC group (U7, Y2, C54–C57, R65, BAT1), flash/config, camera, ESP32 support (B3, B4 …), LEDs D53/D54, AE1, servo J_SRV1–6 + R78–R83 (last).
- DRC: no courtyard, keep-out, edge, short or inter-part clearance violations; remaining items are inside fine-pitch footprints + silkscreen. Parity unchanged (5 SD1 pins).

#### 4.9 Decoupling + local bulk caps (2026-11-07, not routed)
- Every cap placed against the power pin it serves (search over both sides and 4 rotations, cost = cap power pad to the nearest *unserved* pin of that net + 0.3 × GND pad to the IC's nearest GND pin, so caps spread over a BGA's supply balls). No IC or locked part moved.
- **U1 ECP5:** all caps on the back inside the ball field – +1V1 C27, C28 (+ C17 2.2 µF), +2V5 C29, C30 (+ C19), VCCIO `2V5_3V3` C26, C48, C49, C53 (+ C47), +3V3 C25, C31, C32, C50, C51 (+ C20); RV2/RV3 (VCCIO select) beside them. Small caps 0–2 mm from their ball, bulk ≤ 6 mm. `BAY_RIB_1` crosses under U1 (y 26.4–28.2) and stays empty.
- **U2 SDRAM:** C33 on B, C34/C35/C16 on F in the 3 mm strip between U2 and the BT12 tab, C52 on F right of U2 (the BT12 spring courtyard and B0 block most of the back under U2).
- **New in the schematic:** **C84** 100 nF 0402 (C1525) for the config flash U10 (`flash` sheet) and **C85** 100 nF 0402 for the 25 MHz oscillator Y1 (`usb` sheet) – neither had a local cap. Both on B directly under their supply pin; footprints added to the PCB with schematic links (parity clean).
- Re-targeted from the 4.8 satellite pass to the actual pins: TP4056 input caps C39/C41/C43 (+5V, VCC pin) and BAT caps C40/C42/C46; display logic caps C74/C75 to J7's +3V3 pins; CH224K VDD cap C79.
- Others: ESP32 C21 under the module's 3V3 pin; camera C18 (F) / C36 (B) at J1's 3V3 pin; SD supply R38 + C15 at SD1.
- **Coverage (worst pin → nearest same-net cap):** U1 ≤ 6.5 mm (+2V5 corner ball), all other U1 rails ≤ 4 mm; U2 ≤ 6.5 mm; U9 0.7; U10 0 (C84); Y1 4.5 (second +3V3 pin; C85 is at the VDD pin); IMU 3.5; ADC/REF/LDO ≤ 3; regulators 2.1; boost 2.5; TP4056 VCC 0.2 (CE pin tied to +5V ~6 mm); CH224K VDD 0.03; J7 1.8; J1 2.3; SD1 2.4. LM66100 VBAT_OR outputs (U12/U14) are 10 mm from C73 – a shared OR-bus with 100 µF + 10 µF bulk, no per-device cap needed. J4 (DNP header) has none.
- DRC: no courtyard, keep-out, edge, short or inter-part clearance violations; ERC unchanged (153); parity unchanged (5 SD1 pins).

#### 4.10 Remaining parts + servo headers – all 250 footprints on the board (2026-11-07, not routed)
- **Battery NTCs moved to the middle of each cell** (supersedes 4.8): TH1 (47.6, 20.0), TH2 (47.6, 37.5), TH3 (47.6, 58.0) on B – midway between spring tip (x 18) and button (x 77.2), on the cell axis (TH1 is 3 mm off-axis: the regulator column sits on cell 1's axis). Couple each to its can with the 2 mm compressible thermal pad from 4.4 (≈ 5 × 5 mm); keep 3 mm around each NTC free of other parts. Shorter `TEMP_BAT_CELLn` runs to U21.
- **Status LEDs** D53/D54 on F at the top edge (25 / 27, 2.5) with R69/R70 – as locked in 4.1.
- **RTC:** CR1225 holder BAT1 on F top-centre (43.5, 13.2), between U10/J4 and the ESP32, outside the camera module; MCP7940 U7 (34.5, 36.5) and 32 kHz Y2 (39.7, 30.2) on F under the camera module (≤ 6 mm parts allowed there), C54–C57, R65 beside; I²C pull-ups R74/R75 at U7. ⚠ BAT1's metal holder ends ≈ 2–3 mm left of the ESP32 antenna keep-out – check RF; alternative is BAT1 on the bottom-left once the servo block is dropped.
- **Pull-ups / small parts:** flash/config R11, R12, R27–R33, D28, D29 next to U10 / under U1 (B); camera R7, R14–R17 at J1; ESP32 strapping R34, R35, C81, R56 at U9; SD_CD R86 at SD1; button pull-ups R67/R68; 433 MHz pad AE1 at U1.
- **ESP32 BOOT/RESET** B3 (16, 49) and B4 (7, 27.5) on F left side (tall 4.3 mm parts; outside the camera module; press through case pin-holes). Native USB programming does not need them.
- **Servo headers J_SRV1–6 (DNP):** one ganged 3 × 6 grid at 2.54 mm pitch on F, (20.5–33.2, 58) between Y1, SD1, J1 and H3, series resistors R78–R83 beside. This was the only spot with both sides free for through-hole pins outside the camera module. The headers' courtyards overlap by design (butted 2.54 mm bodies) → **5 expected `courtyards_overlap` DRC items**. Under cell 3 on B: if ever fitted, trim the pin tails to ≤ 1.5 mm (cells sit 2.5 mm above the PCB).
- No test points in the schematic besides AE1; mounting holes unchanged (H1, H3, H4; H2 excluded). Camera-module M2 standoffs still to reserve once the module is measured.
- DRC: no keep-out, edge, short or inter-part clearance violations; courtyard overlaps only inside the servo gang; remaining mask/clearance items are inside fine-pitch footprints; silkscreen overlaps to clean up. Parity: only the 5 SD1 pins. ERC unchanged.

#### 4.11 Routing step 1 – JLCPCB rules, planes, fan-out, decoupling (2026-11-07)
**Fab rules (JLCPCB 4-layer, high reliability):** default track/space **0.15 / 0.15 mm**; fine-pitch exceptions in `FCL.kicad_dru` – **0.10 / 0.10 mm** inside rule area `U1_BGA` (ball field + 0.6 mm) and on the pads of the 0.5 mm-pitch parts (U2, U21, U22, U23, U24, J7, J17, LM66100s); mask expansion **0.05 mm**, minimum mask web **0.10 mm** (U22 LGA: footprint mask margin 0 – 0.15 mm pad gap); hole-to-hole **0.5 mm**, copper-to-edge 0.5 mm; vias 0.6/0.3 (default) and 0.4/0.2 (BGA / FAST); text ≥ 0.8 mm / 0.15 mm.
**Stackup JLC04161H-7628 (1.6 mm):** L1 35 µm · 7628 prepreg 0.2104 mm (εr 4.4) · L2 15.2 µm · core 1.065 mm · L3 15.2 µm · 7628 prepreg 0.2104 mm · L4 35 µm; HASL lead-free. Order with 1 oz inner copper if the price allows (planes carry the rails).

**Net classes (IPC-2152, 1 oz outer, ~10 °C rise):**

| Class | Nets | Track | Clearance | Via |
|---|---|---|---|---|
| PWR_HIGH (≈ 3 A) | `VBUS_C`, `+5V`, `VSYS`, `VBAT_OR` | 1.0 mm (or pour) | 0.2 | 0.6/0.3, ≥ 3 per layer change |
| PWR_CELL (≈ 1–1.5 A) | `CELL*_RAW`, `VBAT1–3` | 0.8 mm | 0.2 | 0.6/0.3, ≥ 2 |
| PWR_SW | `L1–L3`, `LCD_BL_SW` | 0.6 mm, short | 0.2 | – |
| USB | `USB_DP/DN`, `USB_C_DP/DN`, `USB_FPGA_D±` | 0.2 mm pair, 0.15 mm gap (≈ 90 Ω) | 0.2 | 0.6/0.3 |
| ANALOG | `*_SENSE`, `TEMP_BAT_CELL*`, `VREF_2V5`, `VADC` | 0.2 mm | 0.2 | 0.6/0.3 |
| PWR_RAIL | `+3V3`, `+1V1`, `+2V5`, `2V5_3V3`, `P1V1/P2V5/P3V3`, `SD3V3`, RTC `VBAT`, `LCD_BL_A/K`, `PD_VDD` | 0.4 mm | 0.15 | 0.6/0.3 |
| FAST | `SDRAM_*`, `SD_CLK/CMD/D0–3`, `CLK_25MHz`, `CAM_XCLK`, `GP*`, `GN*` | 0.15 mm | 0.15 | 0.4/0.2 |
| Default | everything else | 0.15 mm | 0.15 | 0.6/0.3 |

**Planes:** L2 `GND_L2` solid over the whole board (one island). L3 `3V3_L3` main plane (priority 0) + `1V1_U1_core` island over the 20 core balls (priority 2) + `VSYS_powerpath` band x 66–77.6, y 27.5–66 over the charger / power-path block (priority 1, clear of RP3's +3V3 output, the ESP32 and the ADC's +3V3 cap). **+2V5 has no island:** its four balls (F6, F15, P6, P15) are the corners of the core ring with +3V3 and VCCIO balls between them – an island would cut those off the +3V3 plane, so +2V5 (VCCAUX, low current) and VCCIO `2V5_3V3` are routed as tracks in the power pass. Antenna keep-out stays free of copper.

**U1 fan-out (dogbone, 0.4/0.2 vias, interstitial, outward quadrant first):** 90 power/GND balls with their own via, 55 more power/GND balls joined to a same-net neighbour (B-side decoupling occupies some via sites), 91 inner signal balls with vias, 43 signal balls on the two outer rings left to escape on L1, 68 NC. **Still without a via (for the routing passes):** 16 power balls – VCCIO `2V5_3V3` H6, H7, J6, F9, F10 (fed by tracks), +2V5 F6, +3V3 F11, F12, GND J2, G4, R4, B7, D4, K6, J7, K7 – and 26 inner signal balls (listed in the run log; they need a via site freed or an L1 escape).

**Decoupling / IC fan-out:** every IC power and GND pin that sits on a plane net got a via beside it (U2, U9, U10, U21, U22, regulators, chargers, LM66100s, U23, U24, Y1, J1, J7, SD1, J17), exposed pads got 2 × 2 GND via arrays (TP4056s already carry thermal vias); each cap got its own GND via and a straight / L-shaped / cross-side connection to its pin. **62 of 69 decoupling/bulk caps fully connected.** Open (power pass): C17 (+1V1 bulk), C19/C29/C30 (+2V5), C26 (VCCIO GND side), C51 (+3V3, under U1), C70 (ADC REFIN). Filter / timing caps (sense filters, crystal load caps, RC on SHUT/PWRBTn) are left for the analog pass.
- **Power stubs widened to their class** (38 tracks): VBAT1–3 0.3–0.4 → 0.6–0.8 mm, +5V / VBAT_OR / VSYS 0.3–0.4 → 0.6–1.0 mm, VBUS_C → 0.54 mm (pad-limited), +3V3 / SD3V3 → 0.4 mm; capped at the landing pad's width, stepped down only where clearance required. Stubs inside `U1_BGA` stay 0.2 mm. New tracks drawn in KiCad pick up the class width automatically (router: *Use net class values*).
- ⚠ **Edit the rules with KiCad closed:** the open project overwrote `FCL.kicad_pro` once (net classes, patterns, pre-defined sizes lost) and was restored from git. Net classes appear in *Board Setup → Net Classes*, the pattern table in *Netclass Assignments*, and the 0.1–1.5 mm track / 0.4–0.8 mm via presets in *Pre-defined Sizes*.
- Result: 351 vias (223 × 0.4/0.2, 128 × 0.6/0.3), 448 short tracks, all in group `FANOUT_5_1`. DRC: **no clearance, mask-bridge, short, hole or edge violations**; 91 `via_dangling` = U1 signal fan-out vias awaiting routes; silkscreen + 5 servo-gang courtyard items as before. Parity: 5 SD1 pins. ERC unchanged (153).

#### 4.12 Routing step 2 – high-speed nets (partial, 2026-11-08)
- Routed with a scripted grid maze router (A*, 0.1 mm grid, net-class widths/clearances, BGA 0.1 mm escape, rip-up and re-route) – no autorouter. Copper in group `ROUTE_2_HIGHSPEED`; DRC-pruned (no clearance / hole / short violations).
- **Fixes made on the way:** `FCL.kicad_dru` was silently ignored by KiCad 10 (rule values need explicit `mm` units) – rewritten, the BGA and fine-pitch exceptions now apply in DRC; ESP32 RESET **B4 moved to (7, 44.5)** to open the corridor left of U1; SDRAM decoupling **C34, C35, C16 moved to the back under U2** (they walled in U2's left pin row) and reconnected.
- The inner layer In2 (+3V3 plane) is used for some bus segments where F/B ran out; the +3V3 plane is still one island.
- **Routed:** USB (J17 → U24 → ESP32), 25 MHz clock, part of the SDRAM bus, part of the camera/LCD `GPn/GNn` bus.
- **Still open (59 nets):** most of the SDRAM bus (A0–A3, A6, A10, A11, BA0/1, CKE, nCS/nRAS/nCAS/nWE, DQM0/1, D1, D3–D6, D9–D11, D13, D15), the SD bus (SD_CLK/CMD/D0–D2) and ~28 camera/LCD `GPn/GNn` nets.
- **Root cause:** placement. With U1 at 180° all 39 SDRAM balls face **left** (toward the board edge and the spring tabs), while U2 sits above U1 – the bus has to squeeze through a ~3.5 mm corridor (≈ 11 tracks per layer). The original 4.1 plan (U1 rotated so the SDRAM bank faces down, U2 below U1) avoids this. Recommended before finishing these buses: either restore that orientation (and redo the U1 fan-out), or finish the buses with KiCad's interactive push-and-shove router.

#### 4.13 Routing step 3 – power paths (2026-11-08)
- Groups `ROUTE_3_POWER` / `ROUTE_3_POWER_B`. Power nets routed at their class width (PWR_HIGH 1.0, PWR_CELL 0.8, PWR_SW 0.6, PWR_RAIL 0.4 mm), necking only where a pad forces it, 0.6/0.3 vias; every pad on a plane net (GND, +3V3, +1V1 island, VSYS band) that was not yet on its plane got a short stub + via. Planes still one island each. DRC clean (no clearance / short / hole items).
- Unconnected items 447 → 282.
- **Still open (36):** +2V5 ×5 and VCCIO `2V5_3V3` ×5 (BGA balls F6/F15/P6/P15, H6/H7/J6/F9/F10 with no via site – need the fan-out reworked under U1), GND ×9 / +3V3 ×8 / +1V1 ×1 (mostly balls and caps under U1 with no free via site), `VBUS_C` ×4 and +5V ×2 (J17 / D55 / U16 area), VBAT_OR ×1, P1V1 ×1.

#### 4.14 Routing step 4 – analog and sensing (2026-11-08)
- Group `ROUTE_4_ANALOG`: RTC crystal (OSCI/OSCO), regulator feedback, ADC reference / supply, part of the cell / VSYS sense dividers and NTC lines, IMU + RTC I²C where space allowed. ANALOG class 0.2 mm / 0.2 mm clearance. DRC clean, planes one island each. Unconnected 282 → ~270.
- **Still open:** long cross-board runs – `TEMP_BAT_CELL1–3` (NTCs at x 47.6 to U21 on the right), `VBAT1–3_SENSE`, `VSYS_SENSE`, `VREF_SENSE`, `VADC` ×3, `FB1/FB2`, U21 REFIN, IMU I²C / INT and RTC I²C (`FPDI_*`) to U1. These cross the camera/IMU zone and the congested left half; they need the high-speed buses settled first.

#### 4.15 Routing step 5 – low-speed nets, test vias (2026-11-08)
- Group `ROUTE_5_LOWSPEED`: second pass over every remaining net (buttons, LEDs, flash/config, JTAG, ESP32 strapping, power-on logic, servo PWM, CC lines, plus retries of earlier failures) with rip-up. DRC clean (no clearance / short / hole violations), planes one island each.
- **Unconnected items: 492 (before routing) → 197.** 134 nets still have at least one open connection: most of the SDRAM bus, the SD bus, ~26 camera/LCD `GPn/GNn`, ESP32↔FPGA (`WIFI_*`, JTAG), flash/config straps, the long NTC / sense lines to U21, IMU / RTC I²C, servo PWM, and the +2V5 / VCCIO / some GND and +3V3 balls under U1.
- **Test vias on unused FPGA balls:** only 4 fit (group `TESTVIAS_UNUSED_FPGA_IO`, 0.4/0.2, untented). The other 54 NC balls have no free via site – the BGA area is full.
- **Assessment:** the board does not close with this placement on 4 layers. The decisive problem is U1's orientation (SDRAM bank facing the board edge, U2 above) plus the camera/LCD bus leaving the bottom-left; together they saturate the left half. Recommended next step: restore the 4.1 placement intent (U1 rotated so SDRAM faces down, U2 below U1, camera bank toward J1), redo the U1 fan-out, then re-run steps 2–5 – or finish interactively in KiCad (push-and-shove) starting from this state.

#### 4.16 Step 6 – silkscreen (2026-11-08)
- Reference designators 0.8 mm (1.0 mm on large parts), 0.15 mm stroke, centred, on the part's own side (mirrored on B), placed at the nearest spot that clears pads, exposed vias, other refdes and the board edge; values hidden.
- **207 refdes on silkscreen** (95 front, 112 back). **45 kept on the Fab layer only** (no free silk area – mostly 0402/0603 caps under U1 and in the dense power block): C8, C10, C11, C25–C29, C31, C32, C37, C47–C53, C59, C61, C66, C68, C70, C72, C82–C84, D3, D11, D12, D53, R1, R43, R45, R51, R55, R60, R66, R67, R71, R83, RA1, RA2, RV3, U14 – use the assembly drawing (Fab) for those.
- Silk DRC: silk_overlap 199 → 81 (footprint outlines touching neighbours), silk_over_copper 143 → 12, silk_edge 7 → 2.

#### 4.17 ULX3S FPGA/SDRAM core staged off-board (2026-11-08)
- The ULX3S reference layout (board before Phase 4, commit `7a6d82ec`) has the same U1/U2 parts and an **identical SDRAM pin-to-net mapping (78/78)**. Its core is copied **above-left of the outline** (U1 at page (30, 22)), in the **original orientation**: U1 0°, U2 90°, 26.6 mm to the right of U1.
- **Moved to the staging area** (same refdes and nets as the reference, so no renames were needed): U1, U2, C16, C17, C19, C20, C25–C34, D28, D29, R31–R33.
- **Copied (group `ULX3S_CORE_COPY`):** all SDRAM routing, the BGA fan-out / escapes and decoupling connections, the +1V1, +2V5 and 2V5_3V3 islands. Copper only copied where the net exists in our design and lands on a pad of the same net; copper on nets we no longer use (FTDI, ULX3S buttons, unused GP/GN, FPGA USB) dropped.
- **Stackup now matches the reference:** In1 = +3V3 plane + VSYS / +1V1 / +2V5 / 2V5_3V3 islands, In2 = GND (all inner tracks and zones swapped). Zones unfilled.
- Our old U1/U2 dogbones, decoupling stubs and the old `1V1_U1_core` island removed. `U1_BGA` rule area moved with U1; new rule area `ULX3S_CORE` + custom rule (clearance 0.127 mm, hole-to-hole 0.3 mm, hole clearance 0.15 mm) for the reference geometry.
- **Regulator blocks staged too:** 1V1 (U3, L1, C2–C5, C22, RA1, RB1, RP1) and 3V3 (U5, L3, C6–C9, C24, RA3, RB3, RP3) at their reference positions beside the core; reference copper copied with `+5V` → `VSYS` (the only net difference). RP1/RP3 keep our net-tie footprint (3 solder-mask-bridge items where the reference tracks enter it differently). `ULX3S_CORE` rule area extended over them.
- DRC: one 0.125 mm hit (C27 GND pad vs a +3V3 via), 8 courtyard overlaps between the reference's tightly packed caps under the BGA, 147 dangling escape stubs (the ULX3S escapes continue outside the copied window). Next: decide where the core goes on the board and integrate.

#### 4.18 Step 1 – ULX3S core placed on the board (2026-11-08)
- Staged core rotated **90° clockwise** as one unit (parts, copied copper, islands, rule areas): **U1 at board (28, 11.2), U2 below at (28, 37.8)** – SDRAM bank faces down to U2, camera/LCD bank faces right (J1 / IMU), ESP32/SD banks face up.
- Regulator blocks placed separately on B by search (clear of ribs/springs, switchers ≥ 15 mm from the IMU, near the core): **1V1 block (U3) at (41, 15)**, **3V3 block (U5) at (45, 61)**, each with its copied copper.
- B0/B1/B2 stay put: the three core parts that would have hit them (R32, R33, C30) and the three on the bay ribs (C16, D28, D29) were parked instead, their copied stubs dropped.
- **Parked off-board (right of the outline) for step 2:** AE1, BAT1, C1, C14, C16, C30, C48, C51, C52, C54, C84, D12, D14, D15, D28, D29, D53, D54, R7, R11–R13, R18, R27–R29, R32, R33, R66–R70, R75, R80, U7, U8, U10, Y1.
- Our copper inside the new areas removed; conflicting copied escape stubs removed (policy: ours yields to copied SDRAM/core copper, copied stubs yield to our parts). DRC: no clearance / short / hole / edge / keep-out items; remaining courtyard overlaps are the reference's tight cap packing + the servo gang; dangling items are escape stubs and plane vias (zones unfilled).

#### 4.19 Step 1 redone – core rotated 180° from the reference, per the owner's mock-up (2026-11-08)
- Supersedes the 4.18 placement. Block = reference geometry turned 180°: **U1 at board (45.5, 17) rot 180°, U2 at (18.9, 17) rot −90° (horizontal), 26.6 mm left of U1** – the copied SDRAM routing stays valid.
- Signal flow: SDRAM → left into U2; camera/LCD bank → down to J1 (directly below) and J7; ESP32 / SD banks → right, ESP32 alongside. Of 80 FPGA signals with on-board targets only 23 need to route backwards (was 37), 3214 mm straight-line total (was 3552).
- Raised from the mock-up's y 28.8 to **y 17** so the BGA (ball field y ≈ 8.5–25.5) clears bay rib 1 (y 26.4–28.2) and the IMU stays on the optical axis ~12 mm below U1. U2's left end clears the cell-1 spring tab; B0–B2 untouched.
- U1 overlaps the ESP32 footprint's courtyard only (the library courtyard includes the RF clearance band to x = 42; module body starts at x = 56.6, antenna keep-out y < 6.6 is respected).
- Regulator blocks re-placed on B: **1V1 (U3) at (59, 43)** between the bay ribs, **3V3 (U5) at (45, 61)**; switchers ≥ 15 mm from the IMU. The +1V1 feed to the core island now needs a ~30 mm path (step 2).
- `ULX3S_CORE` rule area split into three tight areas (core, 1V1 block, 3V3 block) so the 0.127 mm reference rule does not override the fine-pitch exception on nearby parts.
- Parked off-board for step 2: AE1, BAT1, C1, C14, C16, C30, C45, C48, C51, C52, C54, C81, C84, D12, D14, D15, D28, D29, D53, D54, J4, R7, R11–R13, R18, R24, R25, R27–R30, R32, R33, R35, R66–R70, R75, R80, TH1, U4, U7, U8, U10, Y1.
- DRC: no clearance / short / hole / edge / keep-out items; courtyard overlaps are the reference's tight cap packing + servo gang; dangling items are escape stubs and plane vias. Zones unfilled.

#### 4.20 Step 1, final – core lowered between the bay ribs (2026-11-08)
- Supersedes 4.19. Same orientation, moved down ~one FPGA width: **U1 at (45.5, 37.5) rot 180°, U2 at (18.9, 37.5) rot −90°**. Frees the ESP32's left pin column and the top of the board; the BGA ball field (y ≈ 29–46) sits between bay ribs 1 and 2, no back-side core parts on a rib; the camera bank is ~4 mm above J1.
- **IMU moved off the optical axis** (owner OK; pins can be swapped later): U22 + C76–C78, R74, R76, R77 parked, to be placed above U1 near (45, 18) in step 2. Regulator search used that spot for the 15 mm switcher quiet zone.
- Regulators on B: **1V1 block (U3) at (26, 20)** next to the core, **3V3 block (U5) at (45, 61)**.
- **SDRAM routing re-copied in full from the reference** with the exact 180° transform (U2 position check 0.000 mm): 334 tracks + 24 vias, **all SDRAM nets connected**. (A first attempt lost SDRAM pieces to a bad copper classification; redone from a3929f60.)
- Orphaned copied copper (pieces touching no pad after the moves) removed. `ULX3S_CORE` rule areas re-split (core / 1V1 / 3V3).
- Parked off-board for step 2 (adds to 4.19): B3, B4, C55–C57, R15, R65, RV3, TH2, Y2 and the IMU group.
- DRC: no clearance / short / hole / edge / keep-out items; courtyard overlaps = reference cap packing + servo gang; dangling = escape stubs and plane vias. Zones unfilled.

#### 4.21 Camera / LCD I/O remap for clean routing (2026-11-08)
- The J1 (camera) and J7 (LCD) pin-to-ball assignment came from a hand-wired proto board and crossed over itself (J7 is on B, so its pin order was mirrored against the balls). Remapped so each bus leaves U1 in connector pin order:
  - **LCD (27 signals):** outer three rows of U1's bottom-right corner (A/B/C, x 45–53), in J7 pin order – one via each to B, then a parallel ribbon to J7.
  - **Camera (16 signals):** U1's bottom-left outer rows (x 38–45) in J1 column order – straight fan-down on F; camera PCLK on the dedicated clock input **PCLKT1_0 (B12)** (short B-layer hop).
- Same 3.3 V banks (0 / 1 / 7); only pin locations change. Servo PWM balls left as they are – servos are placed last.
- Schematic: global labels moved on the U1 pins (fpga-io + ram sheets); netlist checked (all 43 nets on their intended balls), ERC unchanged (153). PCB: U1 pad nets updated directly (61 pads), stale stubs/vias on remapped balls removed; schematic parity clean (only the 5 known SD1 pins) – **no re-import needed**.
- FPGA side: `fpga/CameraToTFTSobel_FCL.ice`, `fpga/main_FCL.lpf`, table in `fpga/IO_REMAP.md`. Add clock constraints (e.g. `FREQUENCY PORT "cmos_pclk" 24 MHZ;`) and check nextpnr timing after rebuilding.

#### 4.22 J1 stays through-hole; camera on the outer ball rows (2026-11-08)
- **J1 kept through-hole** (decided): the OV7670 is a tall socketed module that gets unplugged during development; a plated barrel through all layers is much stronger than SMT pads, even with anchoring vias, and no standoff holes are needed (the 3D-printed case supports the module). The LCD ribbon still passes J1 on B: 0.84 mm between J1 pads fits two 0.15 mm traces per gap (16 through the pin field), the rest around J1's right end.
- **Camera remapped onto U1's outer two ball rows (A/B) only**, in J1 column order, so all camera traces route on F without vias: SIOC B20, SIOD B19, VSYNC A19, HREF B18, XCLK A18, D7…D0 A17, B17, B16, A16, B15, A15, A14, A13, RESET B13, PWDN A12; **PCLK stays on PCLKT1_0 (B12)** with one via. FPDI_SDA (RTC I²C) moved B19 → C15 to free an outer ball.
- Schematic (fpga-io), PCB pad nets and `fpga/` files updated; netlist verified, ERC 153, parity clean.
- Owner placement in progress (commit d9ead1f6): SD1 + C15 + R86 at the top near the ESP32, servos in a row at the bottom-left, J4 at (49, 24), H3 and B2 moved. Open DRC items from that WIP: SD1 inside a rule area / overlapping the ESP32 courtyard, B2 overlapping BT12 / C35, two hole-to-hole items.

#### 4.23 ESP32 ↔ FPGA ↔ SD remap; step 1 redone for the owner's placement (2026-11-08)
- **ESP32-S3 pads re-assigned to face their partners:**
  - Left column, facing SD1/J4: SD_D2, D3, CMD, CLK, D0, D1, CD on pads 4–10 (GPIO4–7, 15–17), and JTAG TCK/TDO on pads 11/12 (GPIO18/8; swapped in 4.41, was TMS/TDO).
  - Bottom row, facing U1: JTAG TMS/TDI on pads 17/18 (GPIO9/10; TMS was TCK before 4.41), the FPGA UART TXD/RXD on pads 19/20 (GPIO11/12), and the spare links on pads 21–23 (GPIO13/14/21).
  - ADC SPI: CNV/DIN on pads 24/25 (GPIO47/48), SCK/SDO on pads 28/29 (GPIO35/36).
  - Unchanged: GPIO0 on pad 27 and USB on pads 13/14.
  - Strapping pins 3/45/46, GPIO37–42 and UART0 are left unconnected.
- **Nets renamed to the new GPIO numbers:** `WIFI_GPIO40→13`, `41→14`, `1→21`, `9→47`, `21→48`, `8→35`, `6→36`.
- **FPGA balls in matching order on U1's right edge:**
  - Front-layer links on the outer balls L1, L2, K1, K2, J1, plus F1 for GPIO0.
  - SD (back layer, dogbones) on N4, N3, K4, K3, J3, H3, G3.
  - ADC SPI on F4, F3, E4, E3.
  - JTAG stays on its dedicated balls.
  - The FPGA design uses none of these balls, so `main_FCL.lpf` is unchanged.
  - Full table and routing intent in `fpga/ESP32_PINS.md`.
- **Step-1 clean-up of the owner's placement:**
  - SD1 moved 4 mm left to (35.0, 9.6). Its courtyard now ends at x 42, clear of the ESP32 antenna keep-out, and the card still enters from the top edge.
  - R86 moved with it.
  - C15 moved to the back under the SD1 body, out from under the card overhang.
  - B2 moved right to (23.2, 11.0), off the cell-1 spring.
  - C35 moved below B2.
  - Removed a stale SERVO_V via under J_SRV3 pin 2.
- **J4 (JTAG fallback, DNP) is now a Tag-Connect TC2030 pad footprint** (`Connector:Tag-Connect_TC2030-IDC-FP_2x03_P1.27mm_Vertical`, the legged self-retaining version) on F, centred at (50.5, 21.5). No part to fit. The ESP32-S3 is the normal JTAG programmer; J4 is only a backup. Pin numbers are unchanged (1 GND, 2 3V3, 3 TDI, 4 TCK, 5 TMS, 6 TDO). A TC2030-IDC cable brings them out 1:1 to a 2×3 2.54 mm IDC plug, so wire the probe (FT232H or Pico debugprobe with openFPGALoader) to that plug. Keep the back side clear of tall parts at the three leg holes.
- **Checks:**
  - Netlist verified.
  - ERC 153 (unchanged).
  - Parity: only the 5 known SD1 pins.
  - DRC has no clearance, keep-out or hole errors. The remaining courtyard overlaps are the copied ULX3S decoupling (as on the reference) and the butted servo headers.

#### 4.24 Highway routing before step 2: USB, camera, SD (2026-11-08)
- **USB D+/D− (USB_DP/USB_DN):** a side-by-side pair on F.Cu with **no vias**, 0.2 mm tracks with a 0.2 mm gap, about 51 mm long. The path runs from ESP32 pads 13/14 down beside U1's right edge at x ≈ 57.7, around the charger cluster at x ≈ 63.8–65.5, then along y ≈ 63.4 into U24 pins 6/4. The GND via of C58 moved to (76.75, 60.45) to clear the approach, and the U24 VBUS pin still has room for its via between the two lines. A 4 mm strip right of U1 (x 53–57.6, y 27.5–47) is left free for the 25 MHz oscillator and config flash.
- **Camera (J1):** 14 signals fan out on F.Cu in J1 column order with no crossings. Each line drops from its ball, takes its own horizontal level (pitch 0.35 mm, outermost line on top) and drops into J1. Row-2 pins are reached through the gaps between row-1 pads. PCLK (B12) uses one dogbone via and runs on B.Cu straight to J1.7. XCLK (A18) has a stub and via ready for R15. Pull-ups R14/R16/R17 are connected; R7 and R15 are still parked.
- **SD1 → ESP32:** a via above each SD1 pad, B.Cu under the connector, a via column at x ≈ 41.5, then a front-layer ribbon into ESP32 pads 4–9. Card detect runs on F past R86 to pad 10. To make the ribbon order work:
  - The ESP32 SD pads were re-ordered: pads 4–10 = D1, D0, CLK, CMD, D3, D2, CD.
  - The FPGA balls were re-ordered to match.
  - JTAG TDO/TMS swapped to pads 11/12.
  - C15 (SD 3V3 bulk) moved to B under SD1 at (35.19, 6.5).
  - R86 moved to F at (29.26, 17.6).
- **J4 (Tag-Connect)** moved left to (44.5, 21.5), out of the U9↔U1 corridor.
- **Constraints found, not routed yet:**
  - **The USB pair splits the U9↔U1 corridor.** Everything from the ESP32 bottom row to U1 (FPGA links, ADC SPI, GPIO0, JTAG TCK/TDI) must cross it on B.Cu.
  - **The SD branch to U1 has no clean lane.** 7 nets need the same B corridor, which also holds U1's top-right config-flash escape and the future flash chip. Options: route it through that corridor after the flash is placed, or drop the FPGA↔SD connection. The FPGA design does not use it, and the ESP32 owns the card.
  - **JTAG at J4:** the TC2030's middle pads (TCK/TDI) exit only between the leg holes, and TCK/TDI must cross USB to reach ESP32 pads 17/18.
- **Checks:** DRC has no clearance or short errors, ERC 153, parity only the 5 known SD1 pins. USB, camera and SD1→ESP32 connectivity verified net by net.

#### 4.25 J1 slid left, U5 block parked, camera ribbon redone (2026-11-08)
- **Kept from the owner's edits:** B0, B1, B2 and H1 moves. Open DRC item: B0 pad 1 is within 0.5 mm of the board-edge arc.
- **J1 slid 5.08 mm left** (two pin pitches). Pads now run from x 27.26 to 47.58, which frees a back-layer lane right of J1 (x ≈ 49.5–54) for the LCD ribbon to J7. Not rotated: J1 carries the flat camera module, so rotating it would rotate the image. **The lens moves 5.08 mm left of the optical axis** until the camera mount is reconciled (lens-to-header offset still to be measured).
- **U5 3V3 regulator block parked off-board, to come back:**
  - Parts: U5, L3, C6–C9, C24, RA3, RB3, RP3.
  - Its copied copper (48 items) and its ULX3S_CORE clearance rule area moved with it.
  - It was moved by exactly **+120 mm in x**, so moving it back is a −120 mm shift. Re-place it after the camera/LCD routing.
- **Parked for step 2:**
  - Servo series resistors R78–R83 (servos go last).
  - J1 decoupling C18/C36 and camera pull-ups R14/R17. Their nets are open until placed; R7 was already parked.
  - Stale dangling vias around the old J1 spot were removed.
- **Camera ribbon regenerated for the new J1 position:**
  - All lines are on F.Cu in J1 column order with no crossings, using the same level scheme as 4.24.
  - **XCLK** now has its own F lane, then a via above J1.7, then B.Cu through the J1.5/J1.7 gap. **R15 is on B just below J1** at (34.25, 55.6), joined to J1.8 on B.
  - **PCLK** (B12) uses one dogbone via, then B.Cu, entering J1.7 from the upper right through the J1.7/J1.9 gap.
- **Also parked (owner):** R19 (LCD backlight resistor, was B (50.2, 64.2)) and TH3 (cell-3 NTC, was B (47.6, 58.0)). Re-place both after LCD routing; TH3 goes back near the cell-3 centre.
- **Still not routed:** the SD branch to U1 and JTAG (see 4.24); owner decision pending on keeping the FPGA↔SD connection.
- **Checks:** DRC has no clearance, short or keep-out errors (only the B0 edge item). ERC 153, parity only the 5 known SD1 pins. Camera, USB and SD1→ESP32 connectivity verified.

#### 4.26 J1 to −7.62 mm, SD1 bus re-routed without vias (2026-11-08)
- **J1** moved a further 2.54 mm left (7.62 mm in total from 4.24; pads x 24.72–45.04). That puts J1's right edge at x ≈ 45.9, leaving a ≈ 8 mm B.Cu lane (x 46–54) for the LCD ribbon. C85 was parked: J1's pins now cover its old spot. The lens is 7.62 mm left of the optical axis.
- **Camera ribbon** rebuilt by a level planner (`camplan`). At this J1 position it needs 11 levels at 0.3 mm pitch, which fit between U1 and J1. Same rules as before: F.Cu, J1 column order, no crossings; XCLK has its own lane plus R15 on B below J1; PCLK takes one via.
- **SD1 → ESP32 re-routed on F.Cu with no signal vias:**
  - The lines leave the top of SD1 at 0.35 mm pitch, with card detect as the outermost line over the top.
  - They turn down tight against SD1's right edge, about 1.5 mm into the antenna band, then fan straight into ESP32 pads 4–10.
  - The ESP32 SD pads were re-ordered to suit: 4–10 = CD, D2, D3, CMD, CLK, D0, D1.
  - Only the SD 3V3 and GND pins use vias: 3V3 goes on B to C15, GND to the plane.
  - **This board's copy of the U9 antenna keep-out now starts at x 43.6 instead of 42** (owner OK). DRC reports one `lib_footprint_mismatch` warning on U9 for this.

#### 4.27 J4 / JTAG hand-routed (2026-11-08)
- **Hand-planned, no autorouting.** The TC2030 pads only escape through the gaps between its leg holes: right gap 2 lines (TDO, TMS), top 1 (TCK), bottom 1 (TDI), and the two left gaps (+3V3, GND to vias).
- **TDO / TMS:** F.Cu straight into ESP32 pads 11/12, plus one via each down to B lanes x 51.1 / 50.3 into U1. TDO gets a new dogbone via at (51.1, 31.1) on its existing V4 stub; TMS uses its existing dogbone.
- **TCK:** via above J4 to B. It branches down lane x 49.9 into its U1 dogbone, and runs along B under the USB pair to a via at ESP32 pad 17.
- **TDI:** F.Cu below J4 with a via into U1 (lane x 49.1), then a via to B under the USB pair to ESP32 pad 18.
- **Cleanup:** removed a leftover JTAG_TMS stub on In2 (the GND plane layer) from an earlier pass.
- **Checks:** all four JTAG nets connected (J4, U1, U9); DRC adds nothing new.

#### 4.28 LCD prep: parts parked, floating segments removed (2026-11-08, in progress)
- **Parked for step 2** (front-layer parts between J1 and J7, in the LCD ribbon's path): D16, D17, D27, Q2, R3, R5, R6, R8, C38, C60, D11. This is the soft-power / LED circuit; re-place it after the LCD ribbon.
- **Removed floating track segments around J1/J7** left by earlier parking (GND, VSYS, LCD_BL_A and SERVO_V stubs). One of them was the dangling GND stub of C19, which has no GND via yet.
- **Planned next** (owner approved):
  - Camera RESET/PWDN move to balls A12/B13 (swapped) with one via each, then B.Cu into J1.17/J1.18.
  - Park C19 (2V5 decap under U1's bottom-right corner).
  - Hand-route the LCD ribbon: rows A/B on F, shifted right past J1, fanned above J7 with staggered vias; row C dogbones to B, straight to J7 (`lcdgen.py`).
- **Questions noted:**
  - The FPGA SD balls could move to U1's top-right outer balls (servo PWM today; the servos are now bottom-left).
  - J4 can switch to the TC2030-NL footprint (three small holes, no leg holes) if space gets tight.

#### 4.29 LCD ribbon to J7 hand-routed (2026-11-08)
- **Camera RESET/PWDN swapped balls** (FPGA remap): RESET `cmos_rst_n` (GN17, J1.17) is now on A12 and PWDN `cmos_pwdn` (GP16, J1.18) on B13. Each takes one via beside U1's corner, then B.Cu into J1, PWDN through the J1.15/J1.17 gap. The `.ice`, `.lpf` and `IO_REMAP.md` are updated.
- **C19 (2V5 decap) parked for step 2**, together with its dangling GND stub and +2V5 feed. It needs a new spot with a proper GND via.
- **LCD, rows A and B (18 lines):**
  - F.Cu, in J7 order, shifted 1.05 mm right with staggered jogs to clear J1.
  - Run down the lane right of J1 (x 46.2–53.4).
  - Fan left above J7 on 18 staircase levels (y 55.5–61.5), then drop through vias in two staggered rows at J7's 0.5 mm pitch, with short B stubs into the FPC pads.
- **LCD, row C (9 lines):** one dogbone via each under U1, a B.Cu fan into a lane right of J1 (x 46.25–49.45), then staircase levels (y 55.8–58.6) and straight down between the F vias into J7.
- **Stale leftovers removed:** VSYS / LCD_BL_A vias and stubs from parts parked earlier.
- **Checks:**
  - All 27 LCD lines and RESET/PWDN are connected; DRC adds nothing new. ERC 153; parity shows only the 5 known SD1 pins.
  - Still open by design: the camera pull-ups R7/R14/R16/R17 (parked), SD → U1, and J7's power and backlight pins (step 3).

#### 4.30 Step 2 – parked parts placed (2026-11-08)
- **Floating track segments** removed board-wide (129), with re-verification of every routed bus.
- **Placer:** a placement script (`placer.py`) placed every parked part near what it connects to. It checks courtyards on the part's own side, footprint keep-outs, pads against all existing copper (0.2 mm), through-hole pads inside courtyards, and reserved corridors: SD→U1 / ESP32→U1 between U9 and U1, plus the B strip under U1's right edge for the SD dogbones.
- **Batch 1:**
  - Config flash U10 and the 25 MHz oscillator Y1 on B under the USB pair, beside their escape vias.
  - Flash and DONE/INITN pull-ups; U1 decoupling (C19 back, C30, C48, C51, C52, RV3).
  - Camera pull-ups and J1 decoupling.
  - ESP32 EN RC (R35/C81) under U9.
- **Batch 2:**
  - U4 beside L2; U8 backlight boost with R18/R19/C38 near L4/D1.
  - **U5 3V3 buck re-placed part by part on B below J1** (old copied copper dropped, to be re-routed in step 3).
  - IMU U22 and the RTC U7 + 32 kHz crystal top-left on F.
  - CR1225 holder BAT1 left of J1.
  - NTCs TH1–TH3 roughly under the cell centres; ADC dividers near U21.
- **Batch 3:** soft-power / wake circuit near the power button, user LEDs, button pull-ups, bulk caps, 433 MHz pad AE1, and servo resistors by the servo headers.
- **Open:**
  - **B3 / B4** (ESP32 BOOT/RESET, 6×6 mm tact switches) have no room on F near the ESP32, and on B they would sit under the cells. Options: smaller SMD switches (e.g. 3×4 mm), or drop them in favour of USB/serial recovery.
  - **J7 fan-out with a 45° band** needs J7 about 4 mm right (mechanical decision, TFT FPC).

#### 4.31 Smaller ESP32 buttons, J7 moved toward J1, LCD re-routed (2026-11-08)
- **B3 / B4** (ESP32 BOOT / RESET) changed to C&K KMR2 SMD tact switches (`Button_Switch_SMD:SW_Push_1P1T_NO_CK_KMR2`, MPN KMR221GLFS) in the schematic and on the board. **LCSC number left blank — pick one before ordering.** B3 sits on F at the right edge beside the ESP32; B4 on F between SD1 and J4.
- **Moves:**
  - **J7 moved 5.0 mm left**, so its centre is now 2.7 mm from J1's (was 7.6 mm). A full 7.62 mm shift would land on the servo headers, and H3 limits how far those can go.
  - **Servo headers J_SRV1–6** moved 2.05 mm left.
  - **Reference drawings:** the TFT outline + label moved with J7; the camera keep-out drawings moved with J1 (−7.62 mm).
- **LCD ribbon regenerated for the new J7.** The B-layer levels were lowered to y 56.35–59.15 to clear R15. All 27 lines and RESET/PWDN are connected; no new DRC items.
- **U5 3V3 buck group and TH3 re-placed** clear of the new ribbon: U5 group on B left of the ribbon below J1, TH3 on B at (51.5, 60.5).
- **All parts now on the board.** ERC 153, parity only the 5 known SD1 pins.
- **Next (step 3, routing):** remap groups so each faces its partner (e.g. the ADC SPI toward U21), then route the short local groups first (ADC SPI, flash, oscillator, regulators) before the long buses.

#### 4.32 Step 3 started – ADC SPI, FPGA side (2026-11-08)
- **FPGA remap:**
  - ADC SPI moved to U1's outer right-edge balls facing U21: E1 = SDO, D1 = SCK, C1 = DIN, B1 = CNV (order chosen for a crossing-free run).
  - IMU_INT1/2 moved to F3/E3 (IMU is top-left).
- **Hand-routed:** dogbone via per ball, then B.Cu lanes beside Y1, a level run under Y1, and straight down into U21's SPI pins. R8 is parked: it sat in the lane and has to be re-placed.
- **VSYS link moved to In1** (power layer before GND, per owner): the B.Cu VSYS jumper between vias (54.5, 51.6) and (62.6, 48.4) now runs on In1. The via moved 1.1 mm off U21's SDO column.
- **Open:**
  - ESP32 side of the SPI (pads 24/25/28/29), planned together with the ESP32 → FPGA links.
  - IMU interrupts.
  - R8 placement.
- **BAT1 kept at −35°** (owner decision, for easier cell access). Known DRC item: BAT1's courtyard overlaps J1's courtyard (outline only, no copper). Only 0° fits without it since J1 moved left.

#### 4.33 ADC and SD card wired to the FPGA only (owner decision, 2026-11-08)
- **Architecture:** the FPGA is the main controller; the ESP32 does monitoring and USB and gets SD/ADC data from the FPGA over the serial link (no low-latency need on the ESP32 side). The SD card and the ADC therefore connect to the FPGA only.
- **ADC done:**
  - ESP32 SPI pins (pads 24/25/28/29) disconnected.
  - Nets renamed `WIFI_GPIO47/48/35/36` → `ADC_CNV/ADC_DIN/ADC_SCK/ADC_SDO`; the redundant local ADC_* labels on the power sheet removed.
  - The FPGA-side route (4.32) is unchanged and connected.
  - ERC 152: −4 multiple_net_names, +3 pin_not_driven on U1 B1/C1/D1, the usual input-typed FPGA pin artefact.
- **SD:** moving from the ESP32 to the FPGA (next).

#### 4.34 GND lattice under U1 removed (owner request, 2026-11-08)
- **Removed:** 337 GND track segments on F/B under U1 (the copied ULX3S lattice joining dogbones to each other). Each GND ball and each decap GND pad now has one short stub to its own via, and the vias reach the In2 GND plane. This frees the diamonds and gaps between balls for signal escapes.
- **Vias:** 18 new GND vias added where a pad had none nearby; G10→G9 and P14→N14 linked ball-to-ball.
- **Still need a GND via:** U1 G11, P11, P12, P13 and C19 pad 2. Every diamond around them is taken by power vias, so they need a hand-placed via or a ball-to-ball link (to fix with the power hookup).
- **Owner rework (committed with 4.35):** the GND balls in U1's top-left corner were rejoined by the owner with short top-layer runs to GND vias at y 29.3 (x 40.3–42.7), opening lanes between the balls.

#### 4.35 SD shared with the FPGA – routed (2026-11-08)
- **What:** six SD lines now reach U1 as well as the ESP32 (SD1 → ESP32 route unchanged). The FPGA branch leaves U1's top-left corner, runs north up the cleared back-layer corridor (x 38–40), passes north of TH1 and joins the top-layer SD fan at x 50.0–52.5 through one via per line.
- **FPGA balls (remapped so the lanes never cross):** D2 U17, D3 U18, CMD R17, CLK T16, D0 U16, D1 R16.
- **Card detect:** ESP32 only. M17 is now a no-connect; the FPGA can get card-present from the ESP32 over the serial link.
- **Escape:** 0.1 mm tracks inside the BGA (DRU `BGA_U1_fanout`, opt 0.1). U17 and U16 escape on the top layer at x 40.7 / 41.5 between the GND balls. U18, R17, T16 and R16 drop through diamond vias and run on the back layer. All six pass the GND-via row at y 29.3, then widen to 0.15 mm.
- **Small moves:** TH1 (NTC, B) moved 0.6 mm down to (44, 8.6) so the six lanes fit between it and the ESP32 antenna keep-out. H3 did not need to move.
- **Check:** DRC adds no new errors or clearance problems; all SD nets are fully connected; schematic parity count unchanged.

#### 4.36 Plane stitching (step 3, 2026-11-08)
- **What:** every surface-mount pad on GND, +3V3, +1V1, +2V5 and VSYS that had no path to its plane got a short stub and a 0.4/0.2 via (GND to In2; the rest to their In1 plane or island). Twelve U1 centre balls with no free diamond are linked to a neighbouring same-net ball that has a via (U1 G10, G11, K10–K12 and W16 now done).
- **Method:** a script places each via at the nearest legal spot (no via-in-pad, net-class clearances, hole-to-hole, keep-outs, inside the right plane island), then DRC is run and any via it flags is moved and retried until nothing new is reported.
- **Result:** no new DRC errors (one copper-sliver warning, F.Cu, to review).
- **Still to track by hand (outside their plane island):** VSYS pads away from the power-path island, 2V5_3V3 / +2V5 pads around the regulators, R17 / C16 / C47 GND, U1 P9 / P10 (+3V3) and RP1.2 (+1V1).

#### 4.37 Clean-up before hand routing (step 3, 2026-11-08)
- **Dead copper removed:** every track end and via KiCad DRC flags as dangling (58 at the start, repeated until none), plus dead-end stubs DRC misses because their segments overlap (e.g. the +2V5 stub under U1 at N16). Each stub removal was checked with KiCad's connectivity count, so no real connection was lost. Unconnected items went from 152 to 141 (dead islands no longer count) and DRC reports no new violations.
- **Groups removed:** all 27 router/generator groups are gone, so items select one by one for manual editing.
- **3D models:** paths fixed for U7, U10 (SOIC-8 208 mil), U11 / U13 / U15, U21 and J17. J17 uses the GCT USB4105 model, whose footprint has the same pad and hole layout as the HCTL HC-TYPE-C-16P-01A, which has no stock KiCad model. Still without a model: SD1 (Molex 104031-0811, no stock model). Pads-only parts with no model on purpose: J4, H1/H3/H4, AE1, RP1–RP3 (copper jumpers).

#### 4.38 FPGA balls moved closer to their targets (step 3, 2026-11-08)
- Nine open nets moved to the nearest free ball with a free via spot, in schematic and PCB together (see `fpga/IO_REMAP.md`): IMU_SCL/SDA/INT1 to the left edge (P16, K17, K16), SRV_PWM2–6 to the bottom-left corner (D13–D17), WIFI_EN to N3.
- Checks: all 379 U1 pins match the schematic netlist; ERC unchanged; DRC shows no new violations.

#### 4.39 Low-priority FPGA legs unrouted (step 3, 2026-11-10)
- Removed the copper between U1 and its partner chip on 20 low-priority nets, so they can be rerouted one chip at a time with free choice of FPGA ball: ADC_CNV/DIN/SCK/SDO, IMU_SDA, BTN_PWRn, LED1, SRV_PWM1, WIFI_GPIO0/21/13/14, WIFI_RXD/TXD, WIFI_EN, SHUTDOWN, USER_PROGRAMN, FPDI_SCL/SDA (BTN2n had no FPGA leg). 369 tracks and vias removed, plus 5 dead stubs left on WIFI_GPIO0 and FPDI_SDA.
- Kept as is: SDRAM, LCD, camera, clock, flash/config, JTAG, power. The SD-card legs were also kept: a maze-router reroute did worse than the existing hand route (2 of 6 nets, 44 vias).
- DRC: no new violations; unconnected 140 → 163 (one or more per unrouted net).

#### 4.40 SD card rerouted (step 3, 2026-11-11)
- All SD copper torn up and re-laid. SD1 → ESP32 (U9 pads 4–10) is unchanged in plan: F.Cu only, no vias, nested lanes over the top of SD1. The ESP32 pin order already matches SD1's pad order, so no ESP32 pins were changed.
- The FPGA leg now joins the bus at the card instead of at the ESP32 fan-out: a via on each SD1 signal pad's stub drops to B.Cu, and a hand-planned 6-line bus runs straight south (corridor x 38.1–39.85) to the existing BGA escapes. FPGA legs went from about 40 mm to 27–35 mm, the B.Cu run east under TH1 is gone, and each net still has 2 vias.
- Net totals: 65–76 mm (SD_CD 56 mm, ESP32 side only). DRC: no SD violations; all SD nets connected; unconnected back to 163.

#### 4.41 J4 / JTAG re-laid with an ESP32 pin swap (step 3, 2026-11-11)
- **ESP32-S3 JTAG pins swapped** (schematic `wifi.kicad_sch` labels and PCB pad nets together): TCK → pad 11 (GPIO18), TDO → pad 12 (GPIO8), TMS → pad 17 (GPIO9), TDI stays on pad 18 (GPIO10). **Firmware pin map must match: TCK 18, TDO 8, TMS 9, TDI 10.**
- **Why:** TCK can only leave the TC2030 northwards, and with ESP32 pad 17 it had to loop north and back south around the TDO/TMS lines (48 mm). On pad 11 it now runs on F.Cu across the top of J4 straight into the ESP32, with one via down to U1.
- **Routes:** TCK F.Cu y 17.25 → x 49.75 → y 20.19 into pad 11, tee via down B lane x 49.75. TDO F.Cu y 21.35 into pad 12, tee via down B x 51.1. TMS F.Cu y 21.65, via at x 50.3 down to U1, via at x 52.0 to B under the USB pair to pad 17. TDI unchanged in plan. BGA dogbones kept.
- **Lengths:** TCK 48 → 35 mm (3 → 2 vias), TDO 23 mm, TMS 23 → 32 mm (2 → 4 vias), TDI 34 mm. DRC: no JTAG violations; all four nets connected (J4, U1, U9); schematic and PCB agree on U9/J4.

#### 4.42 Circuits parked off-board for re-placement (step 3, 2026-11-11)
To clear the board for a placement rethink, these groups were moved off the outline with their copper. Each group moved by one fixed offset, so its local routing stays intact. Copper that ran to unmoved parts (U1 balls, BT holders, ESP32) moved too, and those connections now show as ratsnest.
- **Power traces up 100 mm** (traces and vias only; parts and In1 planes stay): +3V3, +5V, VSYS, VBAT_OR, SD3V3, P1V1, P2V5, VBUS_C, PD_VDD. GND stays. The FPGA BGA power fanout inside the U1 courtyard and short (≤ 2 mm) pad stubs on U2/U9 stay.
- **Servo, left 100 and down 100 mm:** J_SRV1–6 and R78–R83. They had no copper; it was torn up earlier.
- **Battery charge / power path, right 100 mm:** U11–U16, U18, U19, Q3–Q5, C39–C43, C46, C58, C73, D2–D4, R20–R23, R41, R42, R46–R48, R51, R55 and R71–R73. The BT11–BT32 holders stay, along with their holder-to-holder links.
- **ADC, down 100 mm:** U21, U17 (REF3025), U20 (VADC LDO), the ADC caps, TH1–TH3, R43/R60/R61, the VSYS divider R44/R45 and the battery-sense dividers R24–R26, R36, R37, R39 with C44, C45 and C59.
- **Flash, left 100 mm:** U10, C84, R11, R12 and R27–R30. The FPGA config pull-ups R31–R33 stay.
- **Cleanup:** after the move I removed one +3V3 stub at U2, one +3V3 via in U1 and a floating GND stub and via at the old U17 spot. The JTAG_TDI tee via at (49.1, 26.8) was already dangling before the move; it is left for review. The In1 `VSYS_powerpath` zone is now isolated because its parts moved.
- **Second batch (same day):**
  - **Bucks U3/U4/U5, right 100 mm:** each moved with its inductor, feedback divider, caps (input caps C5/C9 included) and RP1–RP3, plus their local copper. The P1V1/P2V5 traces parked up earlier came back down onto the bucks, so they are connected again.
  - **RTC U7, left 100 mm:** moved with Y2, C54–C57 and R65. The WAKEUPn traces moved with it, out to D16/D27/R6. BAT1 stays.
#### 4.3 Phase 4 checklist
- [x] Optical axis, outline, zone placement and edge assignment locked (4.1)
- [x] Footprint-link issues fixed; BT11–BT32 footprints added; J2/J6/H2 excluded from board
- [x] 85 × 75 outline, holes, axis marker, camera / cell / TFT reference outlines; antenna keep-out from the ESP32-S3 footprint
- [x] Major mechanical items placed (4.2)
- [x] Update PCB from Schematic (4.5); fallback/obsolete parts excluded from board; RP1–RP3 as net-tie jumpers
- [x] Rough functional placement of all parts into the 4.1 zones (4.5)
- [ ] Measure: NHD TFT outline / FPC (datasheet p.3), OV7670 lens-to-header offset → adjust J1 / J7
- [x] Battery bay geometry on the PCB: contact pitch 20.5 mm, cell-length window, bay rule areas, NTC thermal pad, IMU quiet zone, stress list (4.4)
- [ ] Confirm spring free/solid length and contact plate dimensions on the MY-18650-04/05-J drawings; bay CAD (ribs, end walls, J7 bridge, boss)
- [x] Fine-pitch design rules, net classes, JLC stackup, planes, BGA fan-out, decoupling (4.11)
- [ ] Placement refinement: TP4056 thermal spread, decoupling under the BGA, short CAM_PCLK / LCD_PCLK, silkscreen
- [ ] 3D-print case concept

### Phase 5 – Prototype
- [ ] BOM with LCSC / JLCPCB numbers
- [ ] Gerbers + CPL
- [ ] First order

### Later / stretch goals
- [ ] Higher-voltage / higher-wattage USB-C PD path + switching or multi-cell charger (max charging power)
- [ ] Firmware-driven cell prioritisation (CE control) using the new 8-ch ADC data
- [ ] Optional bottom-capacity boost stage

---

## Power architecture notes (current)

- Cell negatives common (GND). Positives individual (CELLx_RAW → VBATx after reverse FET).
- VSYS powers the main regulators and the LCD boost. CR1225 VBAT is unrelated.
- 3.3 V rail needs ≥ ~3.4 V on VSYS → practical cutoff ≈ 3.5–3.6 V on the highest cell.
- AD7689 8-ch ADC on SPI (SDO/DIN/SCK/CNV = WIFI_GPIO36/48/35/47 on the ESP32-S3, also routed to FPGA pins on the usb sheet). Internal 2.5 V reference (unloaded); REF3025 measured on IN4 and also feeds the NTC pull-up R43 (NTC ratio = IN3 / IN4).
- CHGx LEDs are local only; charger enable/status not yet routed to a processor (open item).
- Ideal-diode OR-ing currently prefers the highest cell. True sequential “dead-first” requires CE control: ~CE pins are broken out via R71–R73 (0 Ω), and the level-shifted drive is still to be designed.
- CH224K (U23) requests a 5 V-only PD contract on the USB-C charge port; the existing TP4056s are unchanged.

---

## What we keep from original ULX3S

- ECP5-85F + config flash + SDRAM
- ~~USB (FTDI) programming / serial~~ → single USB-C via ESP32-S3; FTDI path kept as DNP fallback (Phase 2c)
- WiFi (ESP32) sheet
- SD card sheet
- Core power regulators (1.1 / 2.5 / 3.3 V)

## What we remove

- GPDI / digital video connector
- Large GPIO headers
- Audio jack / analog path
- Original single-cell / simple battery input (replaced by 3×18650)

---

## Notes

- Original files stay on `master`. All destructive work happens on `monocular-strip`.
- Mark checklist items complete as we finish them.
- Update this file at the end of each phase.
- Next power-related work: ADC reference-loading decision, CE pin control, KiCad ERC pass → close Phase 2. Then Phase 2b (USB-C PD 5 V trigger).
