jharvey/FPGA_CAM-LCD/Pic_Cam_ISO.png

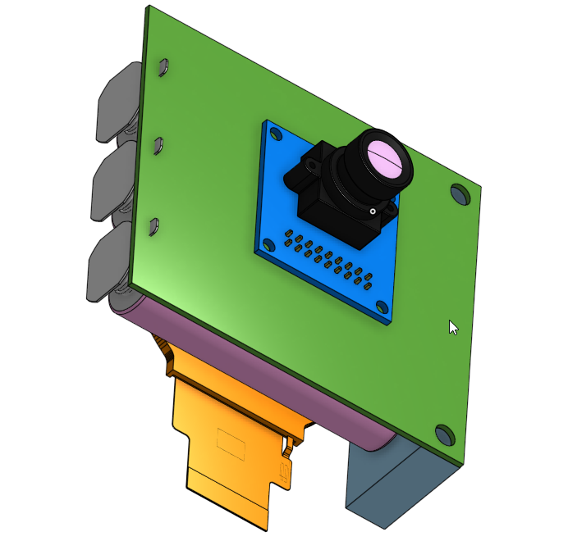
Pic_Cam_ISO.png
