jharvey/FPGA_CAM-LCD/Pic_LCD_ISO.png

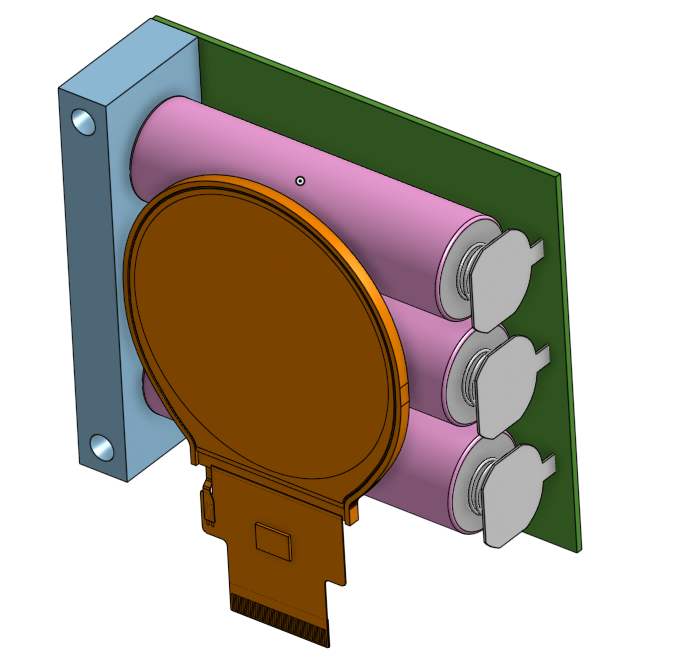
Pic_LCD_ISO.png
