jharvey/FPGA_CAM-LCD/FCL.kicad_pcb

## KiCad design FCL.kicad_pcb (2026-11-14)

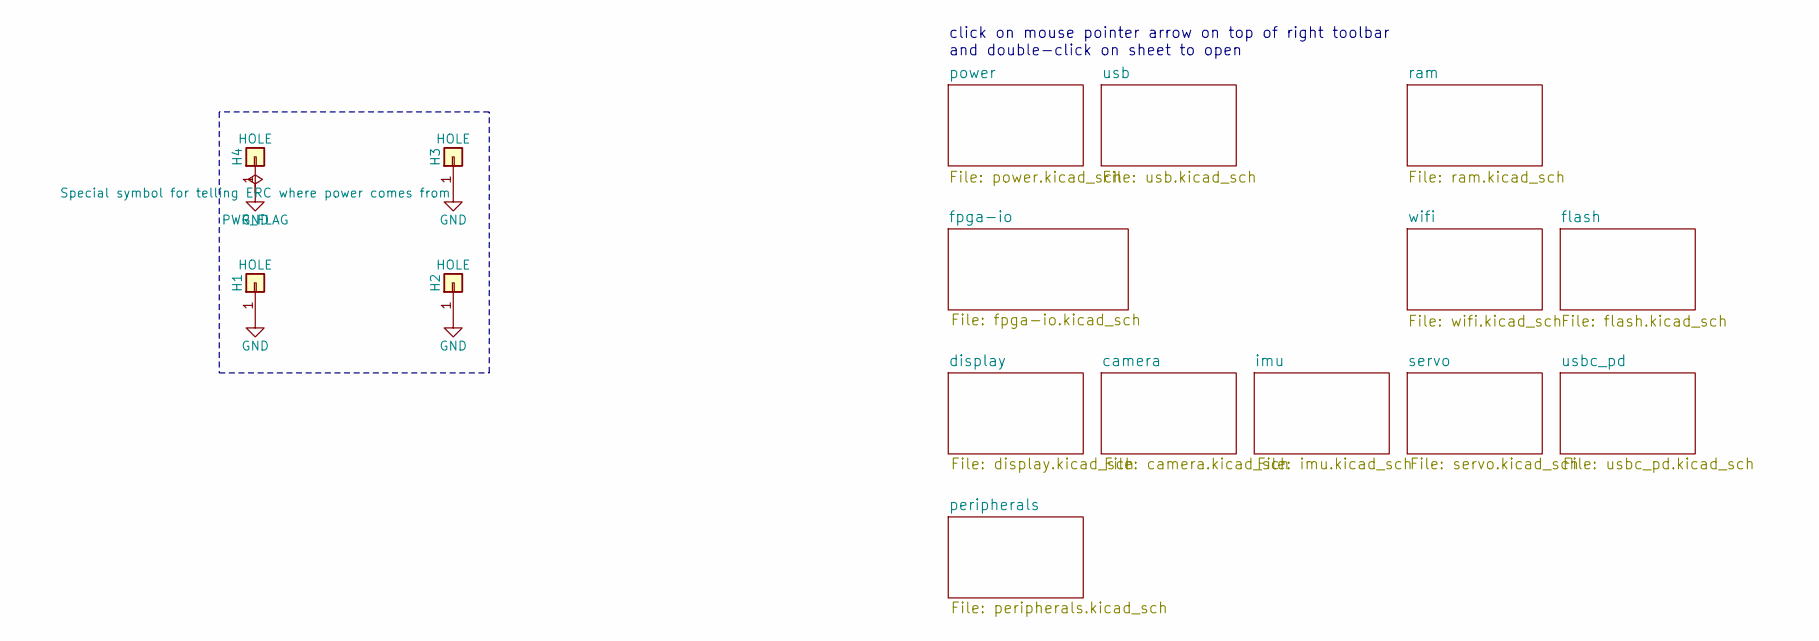
[picture p3: schematic FCL.kicad_sch, FPGA CAM LCD]

Parts:
H1, H2, H3, H4: HOLE; MountingHole_3.2mm_M3_ISO14580_Pad

Connections:
GND: H1.1 (Pin_1_1), H2.1, H3.1 (Pin_1_1), H4.1 (Pin_1_1); also elsewhere on the board

Notes on the sheet:
click on mouse pointer arrow on top of right toolbar and double-click on sheet to open

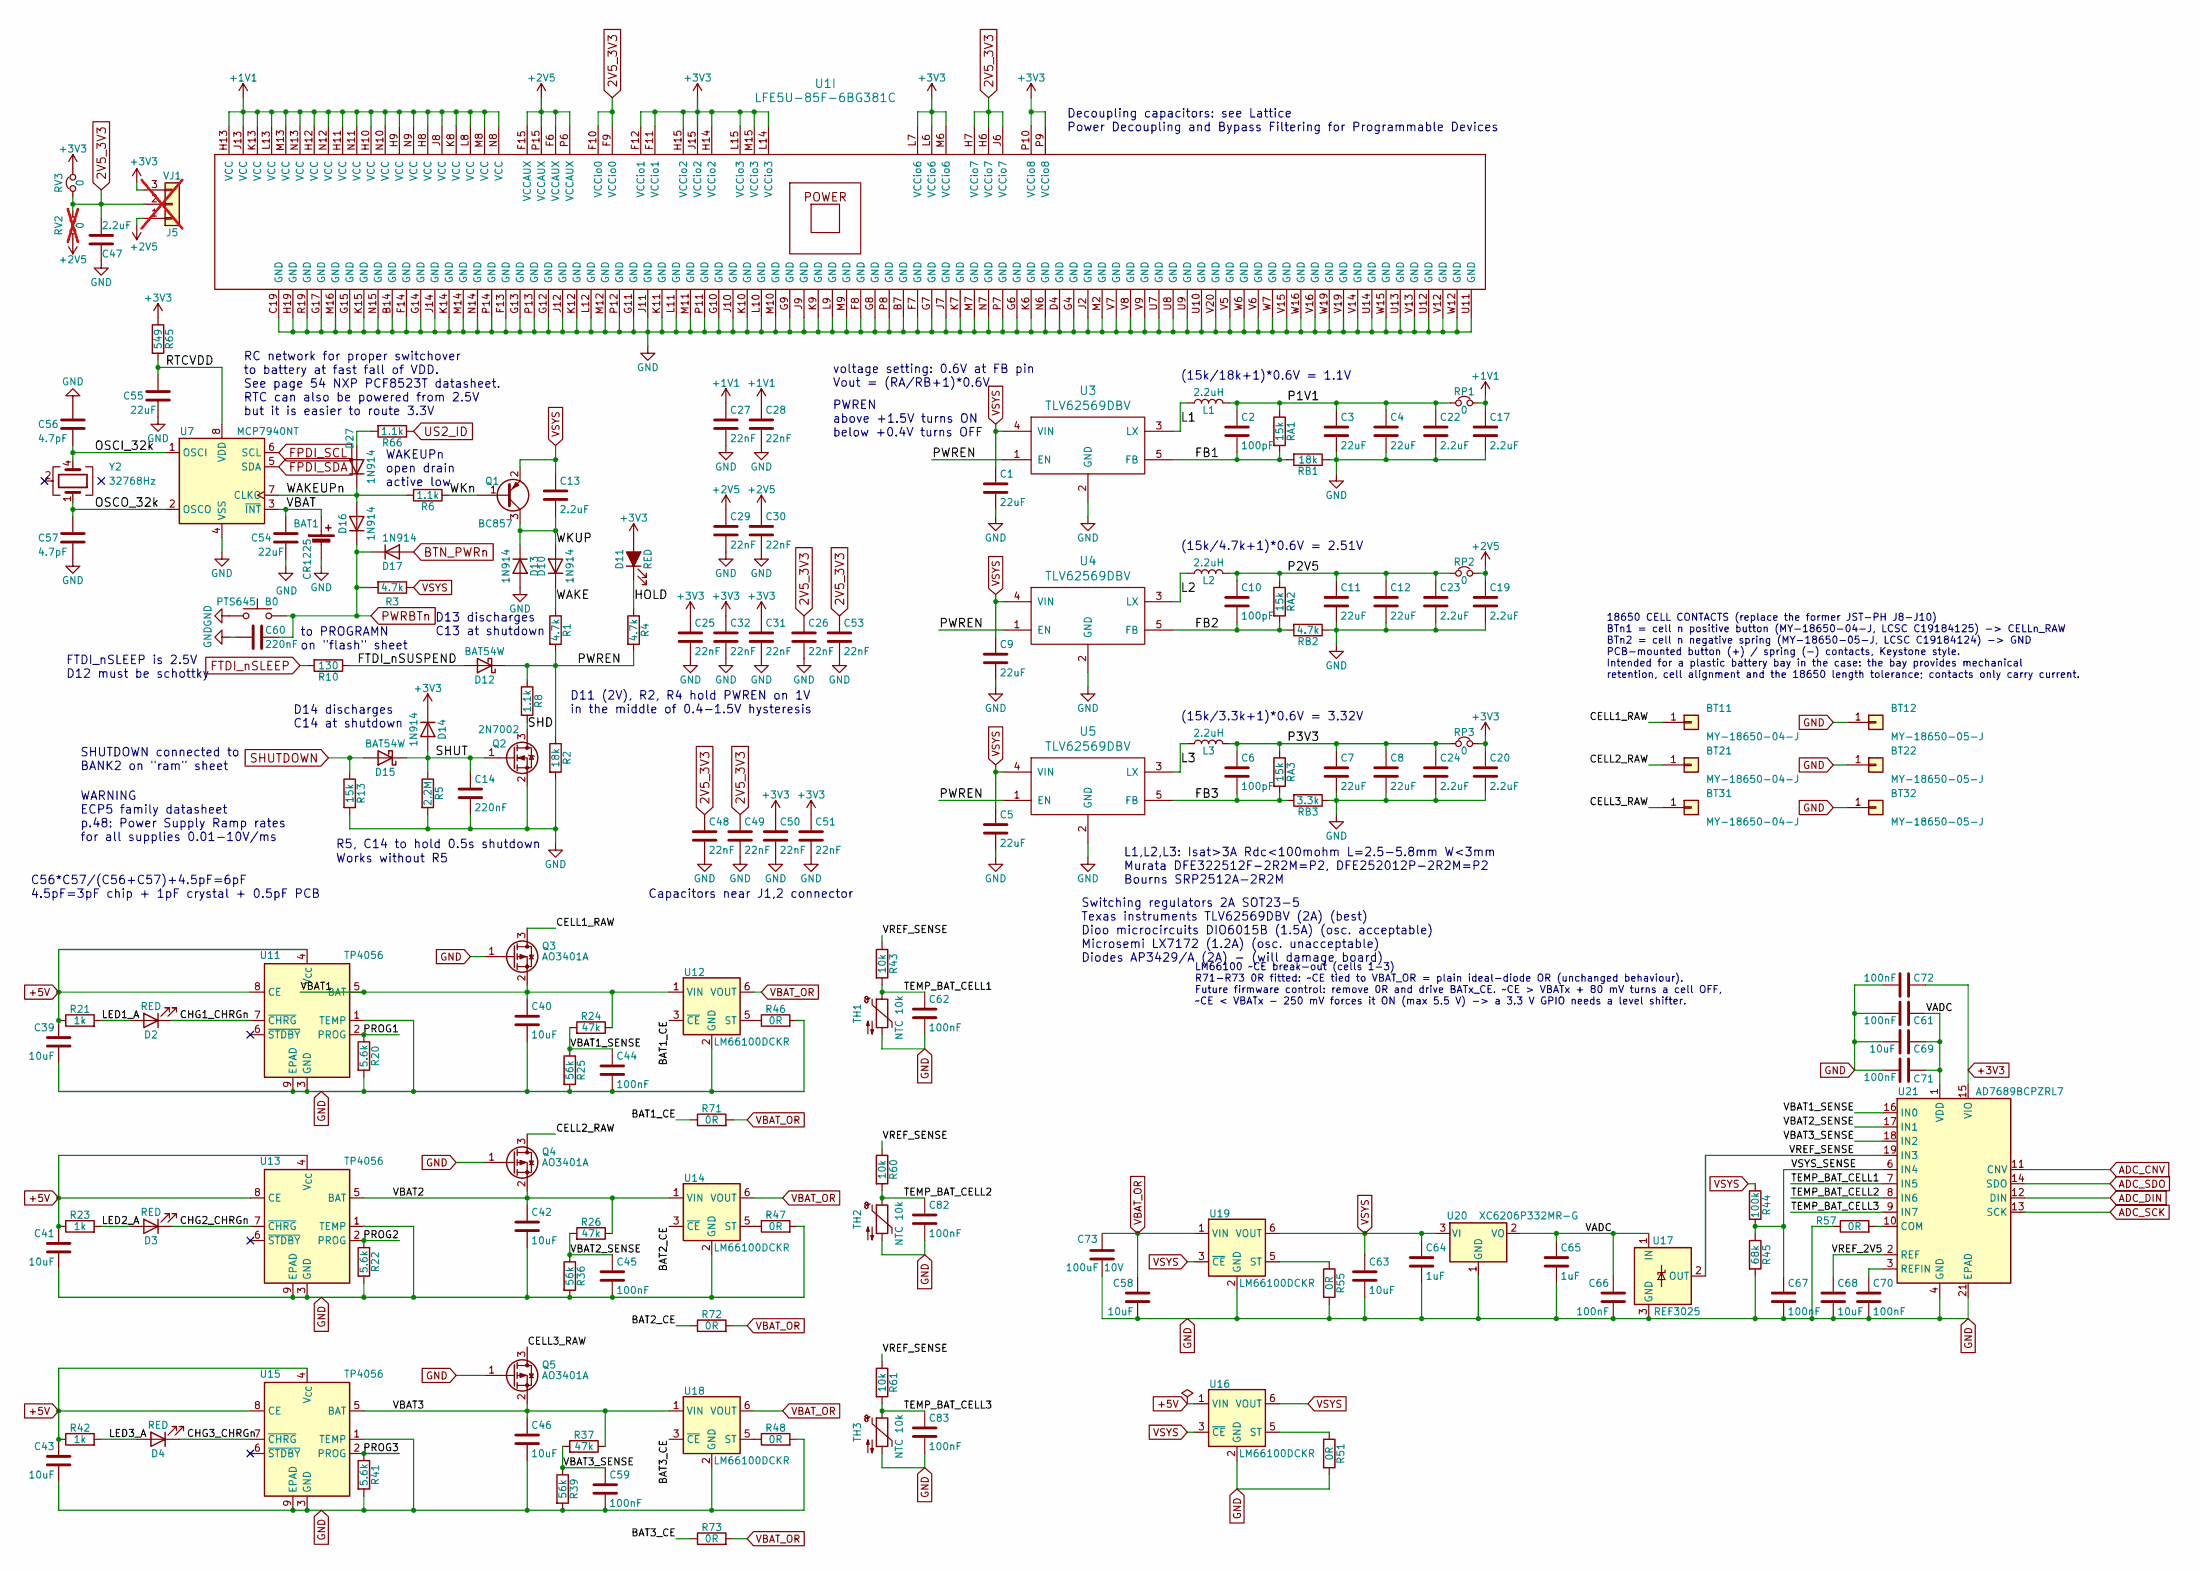
[picture p4: schematic power.kicad_sch, FPGA CAM LCD]

Parts:
B0: PTS645; SW_SPST_PTS645Sx43SMTR92; MPN PTS645SL50SMTR92 LFS; Mouser 611-PTS645SL50SMTR92
BAT1: CR1225; Keystone_3000_1x12mm-CoinCell; MPN 3000TR; Mouser 614-SMTM1225.TR
BT11, BT21, BT31: MY-18650-04-J; BAT-TH_MY-18650-04-J; MPN MY-18650-04-J; LCSC C19184125
BT12, BT22, BT32: MY-18650-05-J; BAT-TH_MY-18650-05-J; MPN MY-18650-05-J; LCSC C19184124
C1: 22uF; C_0805_2012Metric; MPN CC0805ZKY5V5BB226; Mouser 81-GRM21BR61A226ME1L
C2: 100pF; C_0603_1608Metric; MPN CS0603KRX7R9BB471; Mouser 581-06035A101JAT4A
C3, C4, C7, C8, C11, C12: 22uF; C_0805_2012Metric
C5, C9, C54, C55: 22uF; C_0805_2012Metric; MPN CC0805ZKY5V5BB226
C6, C10: 100pF; C_0603_1608Metric
C13: 2.2uF; C_0805_2012Metric; MPN CC0805MRX5R6BB225; Mouser 187-CL21B225KOFNNNG
C14: 220nF; C_0603_1608Metric; MPN CC0603KRX7R8BB224; Mouser 603-CC603KRX7R6BB224
C17, C19, C20, C22, C23, C24: 2.2uF; C_0805_2012Metric
C25: 22nF; C_0603_1608Metric; MPN CC0603JRX7R8BB223; Mouser 603-CC603KRX7R7BB223
C26, C27, C28, C29, C30, C31, C32, C48, C49, C50, C51, C53: 22nF; C_0603_1608Metric; MPN CX0603MRX7R8BB223
C39, C40, C41, C42, C43, C46, C58, C63, C68, C69: 10uF; C_0805_2012Metric; LCSC C15850
C44, C45, C59, C61, C62, C66, C67, C70, C71, C72, C82, C83: 100nF; C_0402_1005Metric; LCSC C1525
C47: 2.2uF; C_0805_2012Metric; MPN CC0805MRX5R6BB225
C56: 4.7pF; C_0603_1608Metric; MPN CC0603CRNPO9BN3R3; Mouser 603-CC603CPNPO9BN4R7
C57: 4.7pF; C_0603_1608Metric
C60: 220nF; C_0603_1608Metric
C64, C65: 1uF; C_0603_1608Metric; LCSC C15849
C73: 100uF 10V; C_1210_3225Metric; MPN CL32A107MPVNNNE; LCSC C23742
D2, D3, D4: RED; LED_0603_1608Metric; LCSC C2286
D10, D13, D14, D17, D27: 1N914; D_SOD-323_HandSoldering
D11: RED; LED_0805_2012Metric
D12: BAT54W; D_SOD-323_HandSoldering
D15: BAT54W; D_SOD-323_HandSoldering; MPN NSR0530HT1G; Mouser 771-BAT54J115
D16: 1N914; D_SOD-323_HandSoldering; MPN 1N4148WS; Mouser 241-1N4148WSR100001
J5: VJ1; PinHeader_1x03_P2.54mm_Vertical; not fitted
L1: 2.2uH; L_1008_1210; MPN DFE322512F-2R2M=P2; Mouser 81-DFE322512F-2R2MP2
L2, L3: 2.2uH; L_1008_1210
Q1: BC857; SOT-23; MPN BC857; Mouser 583-BC856A-T
Q2: 2N7002; SOT-23; MPN 2N7002P,215; Mouser 512-2N7002L
Q3, Q4, Q5: AO3401A; SOT-23; LCSC C15127
R1: 4.7k; R_0603_1608Metric; MPN AC0603FR-104K7L; Mouser 755-SFR03EZPF4701
R2: 18k; R_0603_1608Metric
R3, R4: 4.7k; R_0603_1608Metric; MPN AC0603FR-104K7L
R5: 2.2M; R_0603_1608Metric; MPN RC0603FR-132M2L; Mouser 603-AC0603FR-072M2L
R6, R8, R66: 1.1k; R_0603_1608Metric
R10: 130; R_0603_1608Metric
R13: 15k; R_0603_1608Metric
R20, R22, R41: 5.6k; R_0603_1608Metric; LCSC C23189
R21, R23, R42: 1k; R_0603_1608Metric; LCSC C21190
R24, R26, R37: 47k; R_0603_1608Metric; LCSC C25819
R25, R36, R39: 56k; R_0603_1608Metric; LCSC C23206
R43, R60, R61: 10k; R_0402_1005Metric; LCSC C25744
R44: 100k; R_0603_1608Metric; LCSC C25803
R45: 68k; R_0603_1608Metric; LCSC C23231
R46, R47, R48, R51, R55, R57, R71, R72, R73: 0R; R_0603_1608Metric; MPN 0603WAF0000T5E; LCSC C21189
R65: 549; R_0603_1608Metric
RA1: 15k; R_0603_1608Metric; MPN RC0603FR-1015KL
RA2, RA3: 15k; R_0603_1608Metric
RB1: 18k; R_0603_1608Metric; MPN RC0603FR-1018KL; Mouser 71-CRCW060318K0FKEAC
RB2: 4.7k; R_0603_1608Metric; MPN AC0603FR-104K7L
RB3: 3.3k; R_0603_1608Metric; MPN RT0603FRE073K3L; Mouser 603-RC0603FR-073K3L
RP1: 0; R_0805_Jumper_NC_NetTie; Mouser_URL www.mouser.com
RP2, RP3: 0; R_0805_Jumper_NC_NetTie
RV2: 0; R_0805_2012Metric_Pad1.20x1.40mm_HandSolder; not fitted
RV3: 0; R_0805_2012Metric_Pad1.20x1.40mm_HandSolder; MPN RC0805JR-070RL; Mouser 71-RCG08050000Z0EA
TH1, TH2, TH3: NTC 10k; R_0603_1608Metric; LCSC C13564
U1: LFE5U-85F-6BG381C; BGA-381_pitch0.8mm_dia0.4mm; MPN LFE5U-85F-6BG381C
U3: TLV62569DBV; TSOT-25; MPN TLV62569DBVR; Mouser 453-DIO6015BCST5
U4, U5: TLV62569DBV; TSOT-25; MPN TLV62569DBVR; Mouser 595-TLV62569DBVR
U7: MCP7940NT; SOT96-1; MPN MCP7940NT-I/SN; Mouser 579-MCP7940NT-I/SN
U11, U13, U15: TP4056; SOIC-8-1EP_3.9x4.9mm_P1.27mm_EP2.41x3.3mm_ThermalVias; LCSC C16581
U12, U14, U16, U18, U19: LM66100DCKR; SOT-363_SC-70-6; LCSC C2869734
U17: REF3025; SOT-23; MPN REF3025AIDBZT; LCSC C96625
U20: XC6206P332MR-G; SOT-23; MPN XC6206P332MR-G; LCSC C5446
U21: AD7689BCPZRL7; LFCSP-20-1EP_4x4mm_P0.5mm_EP2.6x2.6mm; MPN AD7689BCPZRL7; LCSC C706705
Y2: 32768Hz; Crystal_SMD_ABS07; MPN LFXTAL016178REEL; Mouser 520-.327-6-34BT

Connections:
2V5_3V3: C26.1, C47.1, C48.1, C49.1, C53.1, J5.2, RV2.2, RV3.1, U1.F9 (VCCio0), U1.F10 (VCCio0), U1.H6 (VCCio7), U1.H7 (VCCio7), U1.J6 (VCCio7)
+1V1: C17.1, C27.1, C28.1, RP1.2, U1.H8 (VCC), U1.H9 (VCC), U1.H10 (VCC), U1.H11 (VCC), U1.H12 (VCC), U1.H13 (VCC), U1.J8 (VCC), U1.J13 (VCC), U1.K8 (VCC), U1.K13 (VCC), U1.L8 (VCC), U1.L13 (VCC), U1.M8 (VCC), U1.M13 (VCC), U1.N8 (VCC), U1.N9 (VCC), U1.N10 (VCC), U1.N11 (VCC), U1.N12 (VCC), U1.N13 (VCC); also elsewhere on the board
+2V5: C19.1, C29.1, C30.1, J5.1, RP2.2, RV2.1, U1.F6 (VCCAUX), U1.F15 (VCCAUX), U1.P6 (VCCAUX), U1.P15 (VCCAUX); also elsewhere on the board
+3V3: C20.1, C25.1, C31.1, C32.1, C50.1, C51.1, C72.1, D11.2 (A), D14.1 (K), J5.3, R65.1, RP3.2, RV3.2, U1.F11 (VCCio1), U1.F12 (VCCio1), U1.H14 (VCCio2), U1.H15 (VCCio2), U1.J15 (VCCio2), U1.L6 (VCCio6), U1.L7 (VCCio6), U1.L14 (VCCio3), U1.L15 (VCCio3), U1.M6 (VCCio6), U1.M15 (VCCio3), U1.P9 (VCCio8), U1.P10 (VCCio8), U21.15 (VIO); also elsewhere on the board
+5V: C39.1, C41.1, C43.1, R21.1, R23.1, R42.1, U11.4 (V_{CC}), U11.8 (CE), U13.4 (V_{CC}), U13.8 (CE), U15.4 (V_{CC}), U15.8 (CE), U16.1 (VIN); also elsewhere on the board
/power/BAT1_CE: R71.1, U12.3 (~CE)
/power/BAT2_CE: R72.1, U14.3 (~CE)
/power/BAT3_CE: R73.1, U18.3 (~CE)
/power/CELL1_RAW: BT11.1 (Pin_1_1), Q3.3 (D)
/power/CELL2_RAW: BT21.1 (Pin_1_1), Q4.3 (D)
/power/CELL3_RAW: BT31.1 (Pin_1_1), Q5.3 (D)
/power/CHG1_CHRGn: D2.1 (K), U11.7 (~CHRG)
/power/CHG2_CHRGn: D3.1 (K), U13.7 (~CHRG)
/power/CHG3_CHRGn: D4.1 (K), U15.7 (~CHRG)
/power/FB1: C2.2, RA1.2, RB1.2, U3.5 (FB)
/power/FB2: C10.2, RA2.2, RB2.2, U4.5 (FB)
/power/FB3: C6.2, RA3.2, RB3.2, U5.5 (FB)
/power/FTDI_nSUSPEND: D12.2 (A), R10.1
/power/HOLD: D11.1 (K), R4.1
/power/L1: L1.1, U3.3 (LX)
/power/L2: L2.1, U4.3 (LX)
/power/L3: L3.1, U5.3 (LX)
/power/LED1_A: D2.2 (A), R21.2
/power/LED2_A: D3.2 (A), R23.2
/power/LED3_A: D4.2 (A), R42.2
/power/OSCI_32k: C56.2, U7.1 (OSCI), Y2.4
/power/OSCO_32k: C57.2, U7.2 (OSCO), Y2.1
/power/P1V1: C2.1, C3.1, C4.1, C22.1, L1.2, RA1.1, RP1.1
/power/P2V5: C10.1, C11.1, C12.1, C23.1, L2.2, RA2.1, RP2.1
/power/P3V3: C6.1, C7.1, C8.1, C24.1, L3.2, RA3.1, RP3.1
/power/PROG1: R20.1, U11.2 (PROG)
/power/PROG2: R22.1, U13.2 (PROG)
/power/PROG3: R41.1, U15.2 (PROG)
/power/PWREN: D12.1 (K), R1.2, R2.1, R4.2, R8.1, U3.1 (EN), U4.1 (EN), U5.1 (EN)
/power/RTCVDD: C55.1, R65.2, U7.8 (VDD)
/power/SHD: Q2.3 (D), R8.2
/power/SHUT: C14.1, D14.2 (A), D15.1 (K), Q2.1 (G), R5.1
/power/TEMP_BAT_CELL1: C62.1, R43.2, TH1.1, U21.7 (IN5)
/power/TEMP_BAT_CELL2: C82.1, R60.2, TH2.1, U21.8 (IN6)
/power/TEMP_BAT_CELL3: C83.1, R61.2, TH3.1, U21.9 (IN7)
/power/VADC: C61.1, C65.1, C66.1, C69.1, C71.1, U17.1 (IN), U20.2 (VO), U21.1 (VDD), U21.20 (VDD)
/power/VBAT: BAT1.1 (+), C54.1, U7.3 (~INT)
/power/VBAT1: C40.1, Q3.2 (S), R24.1, U11.5 (BAT), U12.1 (VIN)
/power/VBAT1_SENSE: C44.1, R24.2, R25.1, U21.16 (IN0)
/power/VBAT2: C42.1, Q4.2 (S), R26.1, U13.5 (BAT), U14.1 (VIN)
/power/VBAT2_SENSE: C45.1, R26.2, R36.1, U21.17 (IN1)
/power/VBAT3: C46.1, Q5.2 (S), R37.1, U15.5 (BAT), U18.1 (VIN)
/power/VBAT3_SENSE: C59.1, R37.2, R39.1, U21.18 (IN2)
/power/VREF_2V5: C68.1, U21.2 (REF)
/power/VREF_SENSE: R43.1, R60.1, R61.1, U17.2 (OUT), U21.19 (IN3)
/power/VSYS_SENSE: C67.1, R44.2, R45.1, U21.6 (IN4)
/power/WAKE: D10.1 (K), R1.1
/power/WAKEUPn: D16.2 (A), D27.1 (K), R6.2, U7.7 (CLKO)
/power/WKUP: C13.2, D10.2 (A), D13.1 (K), Q1.3 (C)
/power/WKn: Q1.1 (B), R6.1
ADC_CNV: U21.11 (CNV); also elsewhere on the board
ADC_DIN: U21.12 (DIN); also elsewhere on the board
ADC_SCK: U21.13 (SCK); also elsewhere on the board
ADC_SDO: U21.14 (SDO); also elsewhere on the board
BTN_PWRn: D17.2 (A); also elsewhere on the board
FPDI_SCL: U7.6 (SCL); also elsewhere on the board
FPDI_SDA: U7.5 (SDA); also elsewhere on the board
FTDI_nSLEEP: R10.2
GND: B0.2, BAT1.2 (-), BT12.1 (Pin_1_1), BT22.1 (Pin_1_1), BT32.1 (Pin_1_1), C1.2, C3.2, C4.2, C5.2, C7.2, C8.2, C9.2, C11.2, C12.2, C14.2, C17.2, C19.2, C20.2, C22.2, C23.2, C24.2, C25.2, C26.2, C27.2, C28.2, C29.2, C30.2, C31.2, C32.2, C39.2, C40.2, C41.2, C42.2, C43.2, C44.2, C45.2, C46.2, C47.2, C48.2, C49.2, C50.2, C51.2, C53.2, C54.2, C55.2, C56.1, C57.1, C58.2, C59.2, C60.2, C61.2, C62.2, C63.2, C64.2, C65.2, C66.2, C67.2, C68.2, C69.2, C70.2, C71.2, C72.2, C73.2, C82.2, C83.2, D13.2 (A), Q2.2 (S), Q3.1 (G), Q4.1 (G), Q5.1 (G), R2.2, R5.2, R13.2, R20.2, R22.2, R25.2, R36.2, R39.2, R41.2, R45.2, R46.2, R47.2, R48.2, R51.2, R55.2, R57.1, RB1.1, RB2.1, RB3.1, TH1.2, TH2.2, TH3.2, U1.B7 (GND), U1.B14 (GND), U1.C19 (GND), U1.D4 (GND), U1.F7 (GND), U1.F8 (GND), U1.F13 (GND), U1.F14 (GND), U1.G4 (GND), U1.G6 (GND), U1.G7 (GND), U1.G8 (GND), U1.G9 (GND), U1.G10 (GND), U1.G11 (GND), U1.G12 (GND), U1.G13 (GND), U1.G14 (GND), U1.G15 (GND), U1.G17 (GND), U1.H19 (GND), U1.J2 (GND), U1.J7 (GND), U1.J9 (GND), U1.J10 (GND), U1.J11 (GND), U1.J12 (GND), U1.J14 (GND), U1.K6 (GND), U1.K7 (GND), U1.K9 (GND), U1.K10 (GND), U1.K11 (GND), U1.K12 (GND), U1.K14 (GND), U1.K15 (GND), U1.L9 (GND), U1.L10 (GND), U1.L11 (GND), U1.L12 (GND), U1.M2 (GND), U1.M7 (GND), U1.M9 (GND), U1.M10 (GND), U1.M11 (GND), U1.M12 (GND), U1.M14 (GND), U1.M16 (GND), U1.N6 (GND), U1.N7 (GND), U1.N14 (GND), U1.N15 (GND), U1.P7 (GND), U1.P8 (GND), U1.P11 (GND), U1.P12 (GND), U1.P13 (GND), U1.P14 (GND), U1.R19 (GND), U1.U7 (GND), U1.U8 (GND), U1.U9 (GND), U1.U10 (GND), U1.U11 (GND), U1.U12 (GND), U1.U13 (GND), U1.U14 (GND), U1.V5 (GND), U1.V6 (GND), U1.V7 (GND), U1.V8 (GND), U1.V9 (GND), U1.V12 (GND), U1.V13 (GND), U1.V14 (GND), U1.V15 (GND), U1.V16 (GND), U1.V19 (GND), U1.V20 (GND), U1.W6 (GND), U1.W7 (GND), U1.W12 (GND), U1.W15 (GND), U1.W16 (GND), U1.W19 (GND), U3.2 (GND), U4.2 (GND), U5.2 (GND), U7.4 (VSS), U11.1 (TEMP), U11.3 (GND), U11.9 (EPAD), U12.2 (GND), U13.1 (TEMP), U13.3 (GND), U13.9 (EPAD), U14.2 (GND), U15.1 (TEMP), U15.3 (GND), U15.9 (EPAD), U16.2 (GND), U17.3 (GND), U18.2 (GND), U19.2 (GND), U20.1 (GND), U21.4 (GND), U21.5 (GND), U21.21 (EPAD); also elsewhere on the board
unnamed: D27.2 (A), R66.2
unnamed: R46.1, U12.5 (ST)
unnamed: R47.1, U14.5 (ST)
unnamed: R51.1, U16.5 (ST)
unnamed: R48.1, U18.5 (ST)
unnamed: R55.1, U19.5 (ST)
unnamed: R57.2, U21.10 (COM)
unnamed: C70.1, U21.3 (REFIN)
PWRBTn: B0.1, C60.1, D16.1 (K), D17.1 (K), R3.2; also elsewhere on the board
SHUTDOWN: D15.2 (A), R13.1; also elsewhere on the board
US2_ID: R66.1
VBAT_OR: C58.1, C73.1, R71.2, R72.2, R73.2, U12.6 (VOUT), U14.6 (VOUT), U18.6 (VOUT), U19.1 (VIN)
VSYS: C1.1, C5.1, C9.1, C13.1, C63.1, C64.1, Q1.2 (E), R3.1, R44.1, U3.4 (VIN), U4.4 (VIN), U5.4 (VIN), U16.3 (~CE), U16.6 (VOUT), U19.3 (~CE), U19.6 (VOUT), U20.3 (VI); also elsewhere on the board

Notes on the sheet:
FTDI_nSLEEP is 2.5V D12 must be schottky
voltage setting: 0.6V at FB pin Vout = (RA/RB+1)*0.6V
Switching regulators 2A SOT23-5 Texas instruments TLV62569DBV (2A) (best) Dioo microcircuits DIO6015B (1.5A) (osc. acceptable) Microsemi LX7172 (1.2A) (osc. unacceptable) Diodes AP3429/A (2A) - (will damage board)
18650 CELL CONTACTS (replace the former JST-PH J8-J10) BTn1 = cell n positive button (MY-18650-04-J, LCSC C19184125) -> CELLn_RAW BTn2 = cell n negative spring (MY-18650-05-J, LCSC C19184124) -> GND PCB-mounted button (+) / spring (-) contacts, Keystone style. Intended for a plastic battery bay in 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
Works without R5
L1,L2,L3: Isat>3A Rdc<100mohm L=2.5-5.8mm W<3mm Murata DFE322512F-2R2M=P2, DFE252012P-2R2M=P2 Bourns SRP2512A-2R2M
Decoupling capacitors: see Lattice Power Decoupling and Bypass Filtering for Programmable Devices
LM66100 ~CE break-out (cells 1-3) R71-R73 0R fitted: ~CE tied to VBAT_OR = plain ideal-diode OR (unchanged behaviour). Future firmware control: remove 0R and drive BATx_CE. ~CE > VBATx + 80 mV turns a cell OFF, ~CE < VBATx - 250 mV forces it ON (max 5.5 V) -> a 3.3 V GPIO needs a level shifter.
R5, C14 to hold 0.5s shutdown
WARNING ECP5 family datasheet p.48: Power Supply Ramp rates for all supplies 0.01-10V/ms
to PROGRAMN on "flash" sheet
SHUTDOWN connected to BANK2 on "ram" sheet
(15k/3.3k+1)*0.6V = 3.32V
(15k/4.7k+1)*0.6V = 2.51V
RC network for proper switchover to battery at fast fall of VDD. See page 54 NXP PCF8523T datasheet. RTC can also be powered from 2.5V but it is easier to route 3.3V
D14 discharges C14 at shutdown
(15k/18k+1)*0.6V = 1.1V
D11 (2V), R2, R4 hold PWREN on 1V in the middle of 0.4-1.5V hysteresis
Capacitors near J1,2 connector
PWREN above +1.5V turns ON below +0.4V turns OFF
C56*C57/(C56+C57)+4.5pF=6pF 4.5pF=3pF chip + 1pF crystal + 0.5pF PCB
WAKEUPn open drain active low
D13 discharges C13 at shutdown

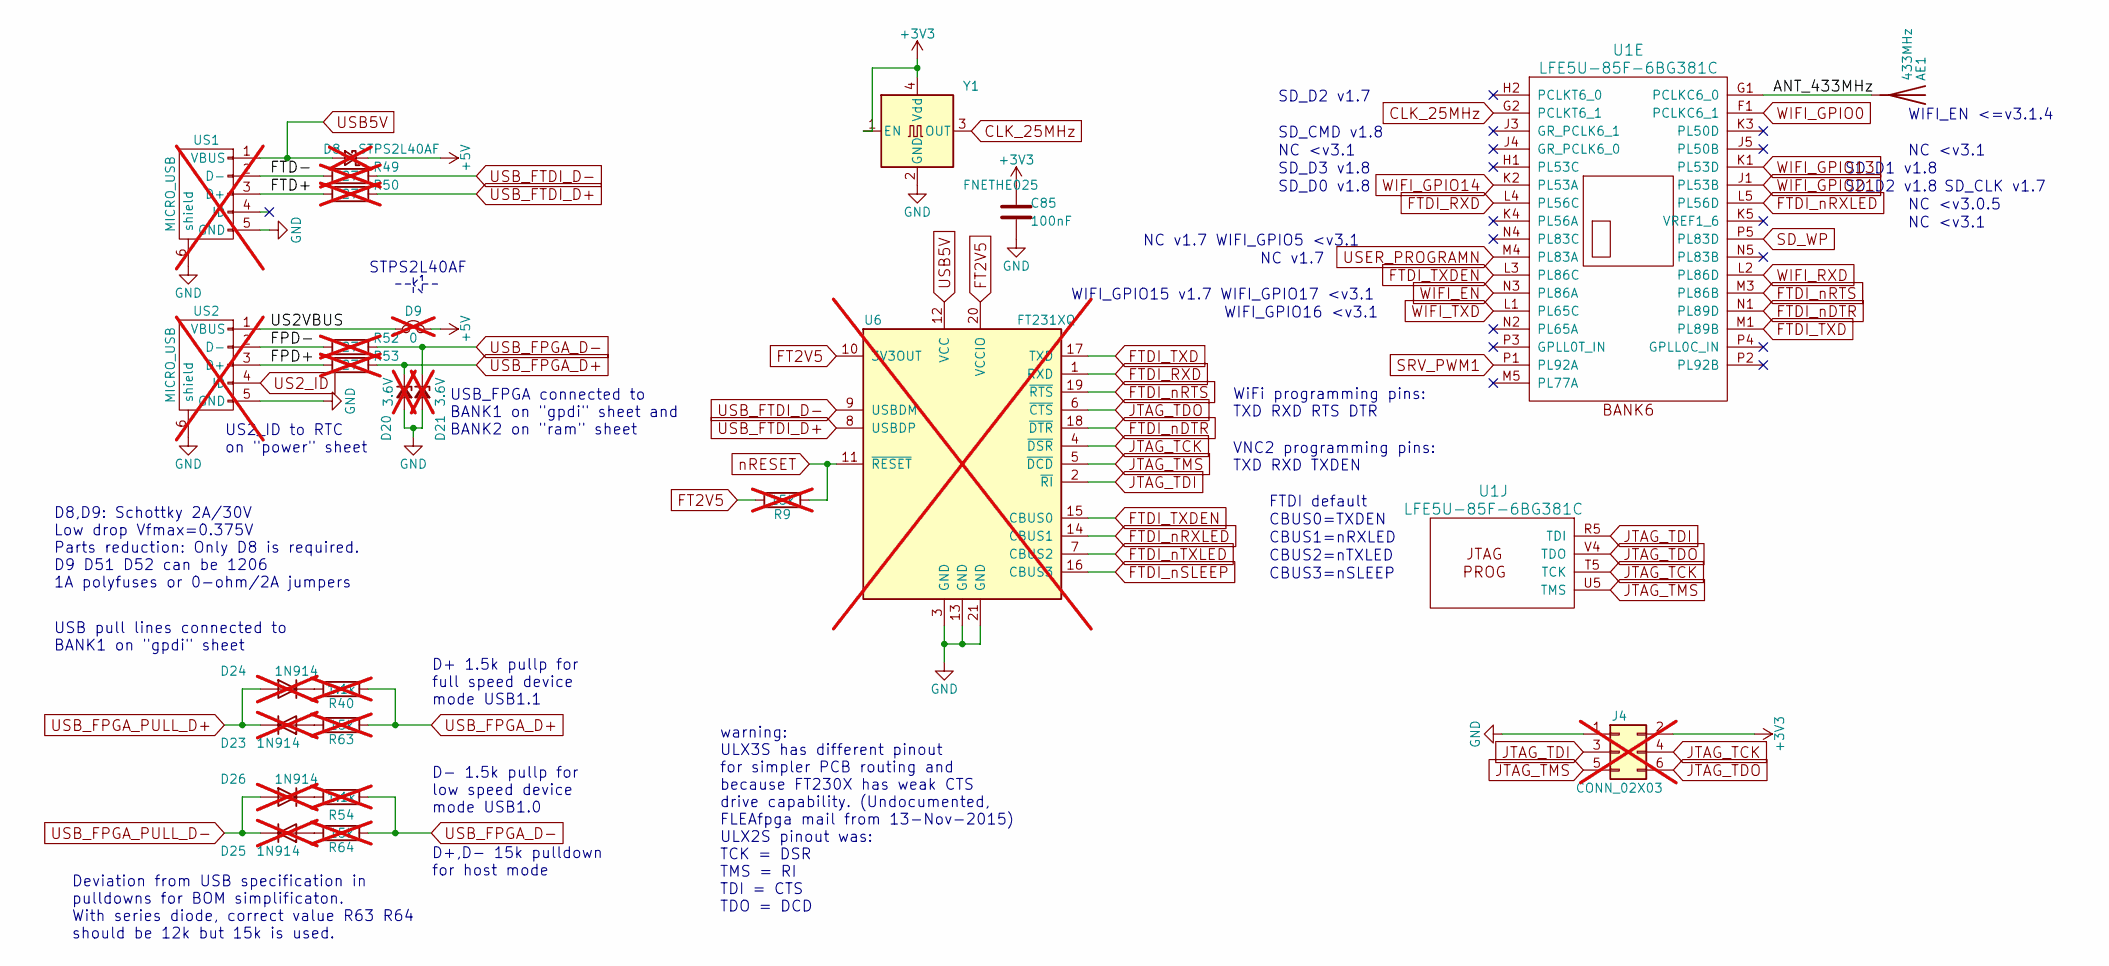
[picture p5: schematic usb.kicad_sch, FPGA CAM LCD]

Parts:
AE1: 433MHz; TestPoint_Pad_D1.0mm
C85: 100nF; C_0402_1005Metric; LCSC C1525
D8: STPS2L40AF; D_SMA; MPN STPS2L30AF; Mouser 511-STPS2L40AF; not fitted
D9: 0; D_SMA_Jumper_NC; MPN2 STPS2L30AF; not fitted
D20, D21: 3.6V; D_SOD-323_HandSoldering; MPN BZT52C3V6S; Mouser 833-BZT52C3V6S-TP; not fitted
D23, D24, D25: 1N914; D_SOD-323_HandSoldering; not fitted
D26: 1N914; D_SOD-323_HandSoldering; MPN 1N4148WS; not fitted
J4: CONN_02X03; Tag-Connect_TC2030-IDC-FP_2x03_P1.27mm_Vertical; not fitted
R9: 15k; R_0603_1608Metric; MPN RC0603FR-0715KL; Mouser 603-AC0603FR-1015KL; not fitted
R40, R54: 1.1k; R_0603_1608Metric; not fitted
R49: 27; R_0603_1608Metric; MPN AC0603JR-0727RL; Mouser 603-AC0603JR-0727RL; not fitted
R50, R52, R53: 27; R_0603_1608Metric; MPN AC0603JR-0727RL; not fitted
R63, R64: 15k; R_0603_1608Metric; not fitted
U1: LFE5U-85F-6BG381C; BGA-381_pitch0.8mm_dia0.4mm; MPN LFE5U-85F-6BG381C
U6: FT231XQ; FT231X-QFN-20-1EP_4x4mm_P0.5mm_EP2x2mm; MPN FT231XQ; Mouser 895-FT231XQ-R; not fitted
US1: MICRO_USB; USB-MICRO-B-FCI-10118192-0001LF; MPN 10118192-0001LF; Mouser 649-10118192-0001LF; not fitted
US2: MICRO_USB; USB-MICRO-B-FCI-10118192-0001LF; not fitted
Y1: FNETHE025; Crystal_SMD_7050_4Pads; MPN FNETHE025; Mouser 729-FNETHE025

Connections:
+3V3: C85.1, J4.2, Y1.1 (EN), Y1.4 (Vdd); also elsewhere on the board
/usb/ANT_433MHz: AE1.1 (A_1), U1.G1 (PCLKC6_0)
CLK_25MHz: U1.G2 (PCLKT6_1), Y1.3 (OUT)
FTDI_RXD: U1.L4 (PL56C), U6.1 (RXD)
FTDI_TXD: U1.M1 (PL89B), U6.17 (TXD)
FTDI_TXDEN: U1.L3 (PL86C), U6.15 (CBUS0)
FTDI_nDTR: U1.N1 (PL89D), U6.18 (~DTR)
FTDI_nRTS: U1.M3 (PL86B), U6.19 (~RTS)
FTDI_nRXLED: U1.L5 (PL56D), U6.14 (CBUS1)
GND: C85.2, D20.2 (A), D21.2 (A), J4.1, U6.3 (GND), U6.13 (GND), U6.21 (GND), US1.5 (GND), US1.6 (shield), US2.5 (GND), US2.6 (shield), Y1.2 (GND); also elsewhere on the board
JTAG_TCK: J4.4, U1.T5 (TCK), U6.4 (~DSR); also elsewhere on the board
JTAG_TDI: J4.3, U1.R5 (TDI), U6.2 (~RI); also elsewhere on the board
JTAG_TDO: J4.6, U1.V4 (TDO), U6.6 (~CTS); also elsewhere on the board
JTAG_TMS: J4.5, U1.U5 (TMS), U6.5 (~DCD); also elsewhere on the board
unnamed: D8.1 (K), D9.2
unnamed: D8.2 (A), U6.12 (VCC), US1.1 (VBUS)
unnamed: D9.1, US2.1 (VBUS)
unnamed: D20.1 (K), R40.2, R53.1, R63.2
unnamed: D21.1 (K), R52.1, R54.1, R64.2
unnamed: D23.1 (K), D24.2 (A)
unnamed: D23.2 (A), R63.1
unnamed: D24.1 (K), R40.1
unnamed: D25.1 (K), D26.2 (A)
unnamed: D25.2 (A), R64.1
unnamed: D26.1 (K), R54.2
unnamed: R9.1, U6.11 (~RESET)
unnamed: R9.2, U6.10 (3V3OUT), U6.20 (VCCIO)
unnamed: R49.1, U6.9 (USBDM)
unnamed: R49.2, US1.2 (D-)
unnamed: R50.1, U6.8 (USBDP)
unnamed: R50.2, US1.3 (D+)
unnamed: R52.2, US2.2 (D-)
unnamed: R53.2, US2.3 (D+)
SD_WP: U1.P5 (PL83D)
SRV_PWM1: U1.P1 (PL92A); also elsewhere on the board
USER_PROGRAMN: U1.M4 (PL83A); also elsewhere on the board
WIFI_EN: U1.N3 (PL86A); also elsewhere on the board
WIFI_GPIO0: U1.F1 (PCLKC6_1); also elsewhere on the board
WIFI_GPIO13: U1.K1 (PL53D); also elsewhere on the board
WIFI_GPIO14: U1.K2 (PL53A); also elsewhere on the board
WIFI_GPIO21: U1.J1 (PL53B); also elsewhere on the board
WIFI_RXD: U1.L2 (PL86D); also elsewhere on the board
WIFI_TXD: U1.L1 (PL65C); also elsewhere on the board

Notes on the sheet:
WIFI_EN <=v3.1.4
USB pull lines connected to BANK1 on "gpdi" sheet
NC <v3.0.5
D+ 1.5k pullp for full speed device mode USB1.1
D8,D9: Schottky 2A/30V Low drop Vfmax=0.375V Parts reduction: Only D8 is required. D9 D51 D52 can be 1206 1A polyfuses or 0-ohm/2A jumpers
SD_D3 v1.8
NC v1.7
NC <v3.1
SD_D0 v1.8
CBUS0=TXDEN
WIFI_GPIO16 <v3.1
SD_CLK v1.7
VNC2 programming pins: TXD RXD TXDEN
SD_D2 v1.8
CBUS1=nRXLED
FTDI default
USB_FPGA connected to BANK1 on "gpdi" sheet and BANK2 on "ram" sheet
WiFi programming pins: TXD RXD RTS DTR
D- 1.5k pullp for low speed device mode USB1.0
SD_D1 v1.8
warning: ULX3S has different pinout for simpler PCB routing and because FT230X has weak CTS drive capability. (Undocumented, FLEAfpga mail from 13-Nov-2015) ULX2S pinout was: TCK = DSR TMS = RI TDI = CTS TDO = DCD
WIFI_GPIO15 v1.7 WIFI_GPIO17 <v3.1
SD_CMD v1.8
CBUS2=nTXLED
Deviation from USB specification in pulldowns for BOM simplificaton. With series diode, correct value R63 R64 should be 12k but 15k is used.
STPS2L40AF
NC v1.7 WIFI_GPIO5 <v3.1
CBUS3=nSLEEP
SD_D2 v1.7
US2_ID to RTC on "power" sheet
D+,D- 15k pulldown for host mode

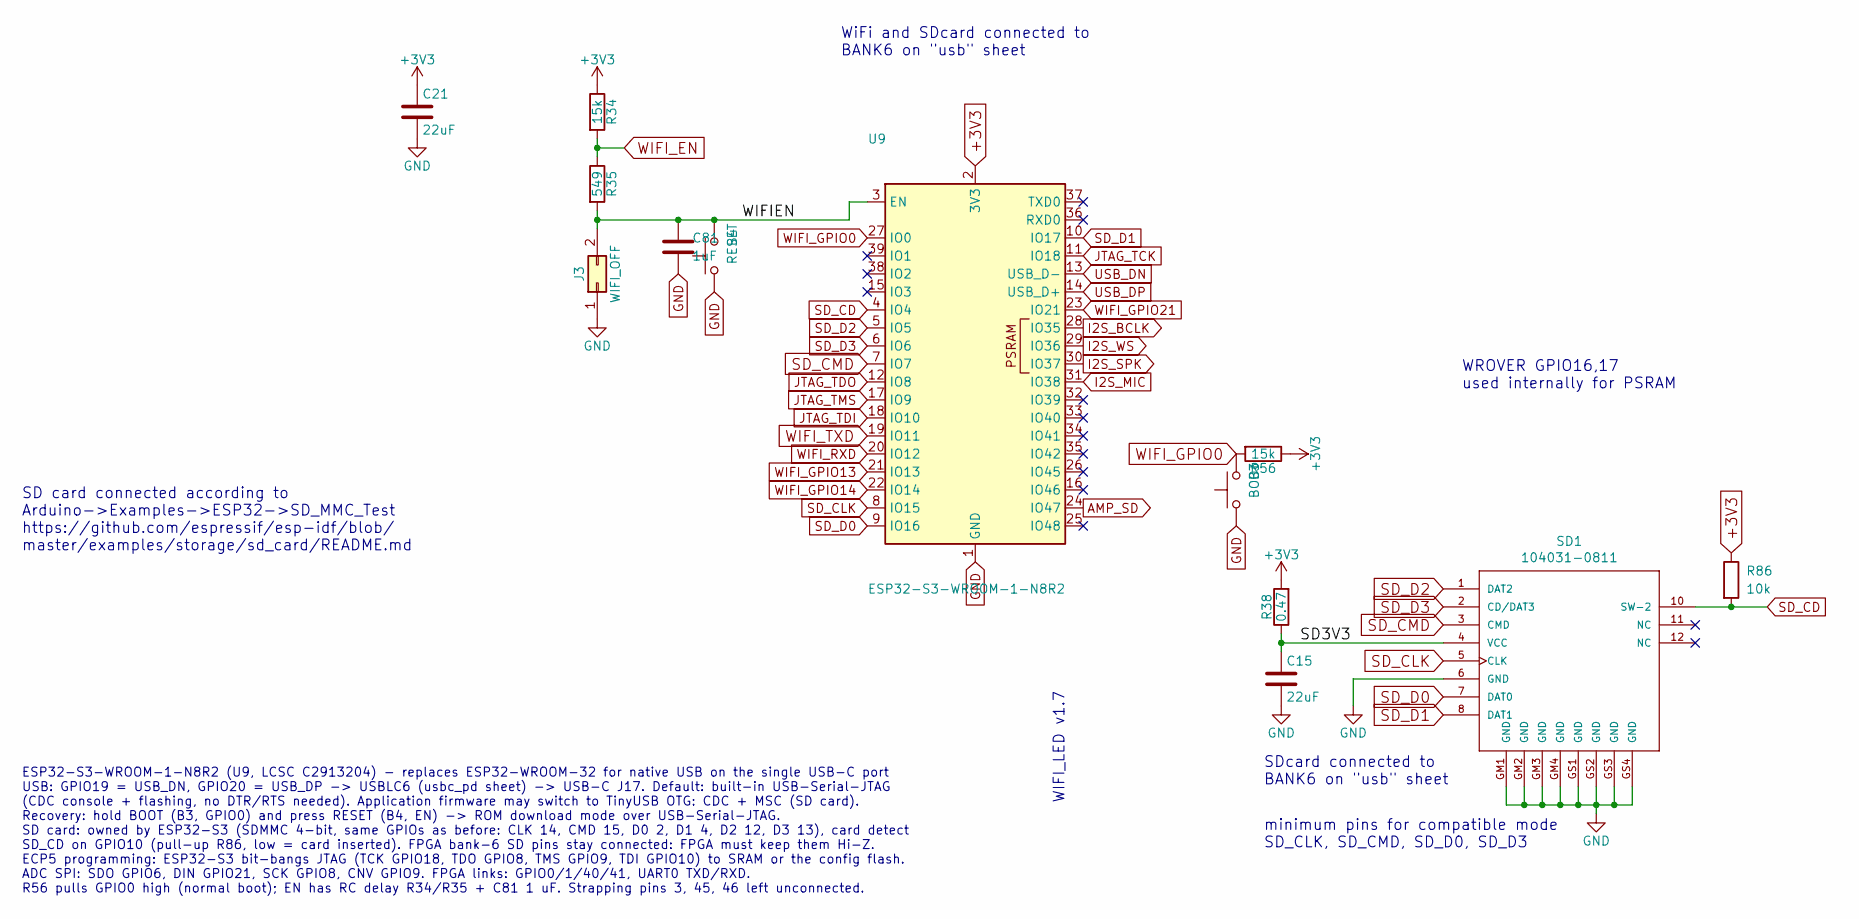
[picture p6: schematic wifi.kicad_sch, FPGA CAM LCD]

Parts:
B3: BOOT; SW_Push_1P1T_NO_CK_KMR2
B4: RESET; SW_Push_1P1T_NO_CK_KMR2
C15, C21: 22uF; C_0805_2012Metric; MPN CC0805ZKY5V5BB226
C81: 1uF; C_0603_1608Metric; LCSC C15849
J3: WIFI_OFF; PinHeader_1x02_P2.54mm_Vertical
R34, R56: 15k; R_0603_1608Metric
R35: 549; R_0603_1608Metric
R38: 0.47; R_0603_1608Metric; MPN 73L2R47J; Mouser 774-73L2R47J
R86: 10k; R_0402_1005Metric; LCSC C25744
SD1: 104031-0811; microSD_Molex_104031-0811_FCL; MPN 104031-0811; Mouser 538-104031-0811
U9: ESP32-S3-WROOM-1-N8R2; ESP32-S3-WROOM-1; MPN ESP32-S3-WROOM-1-N8R2; LCSC C2913204

Connections:
+3V3: C21.1, R34.1, R38.2, R56.1, R86.1, U9.2 (3V3); also elsewhere on the board
/wifi/SD3V3: C15.1, R38.1, SD1.4 (VCC)
/wifi/WIFIEN: B4.2, C81.1, J3.2, R35.2, U9.3 (EN)
AMP_SD: U9.24 (IO47); also elsewhere on the board
GND: B3.1, B4.1, C15.2, C21.2, C81.2, J3.1, SD1.6 (GND), SD1.GM1 (GND), SD1.GM2 (GND), SD1.GM3 (GND), SD1.GM4 (GND), SD1.GS1 (GND), SD1.GS2 (GND), SD1.GS3 (GND), SD1.GS4 (GND), U9.1 (GND), U9.40 (GND), U9.41 (GND); also elsewhere on the board
I2S_BCLK: U9.28 (IO35); also elsewhere on the board
I2S_MIC: U9.31 (IO38); also elsewhere on the board
I2S_SPK: U9.30 (IO37); also elsewhere on the board
I2S_WS: U9.29 (IO36); also elsewhere on the board
JTAG_TCK: U9.11 (IO18); also elsewhere on the board
JTAG_TDI: U9.18 (IO10); also elsewhere on the board
JTAG_TDO: U9.12 (IO8); also elsewhere on the board
JTAG_TMS: U9.17 (IO9); also elsewhere on the board
SD_CD: R86.2, SD1.10 (SW-2), U9.4 (IO4)
SD_CLK: SD1.5 (CLK), U9.8 (IO15); also elsewhere on the board
SD_CMD: SD1.3 (CMD), U9.7 (IO7); also elsewhere on the board
SD_D0: SD1.7 (DAT0), U9.9 (IO16); also elsewhere on the board
SD_D1: SD1.8 (DAT1), U9.10 (IO17); also elsewhere on the board
SD_D2: SD1.1 (DAT2), U9.5 (IO5); also elsewhere on the board
SD_D3: SD1.2 (CD/DAT3), U9.6 (IO6); also elsewhere on the board
USB_DN: U9.13 (USB_D-); also elsewhere on the board
USB_DP: U9.14 (USB_D+); also elsewhere on the board
WIFI_EN: R34.2, R35.1; also elsewhere on the board
WIFI_GPIO0: B3.2, R56.2, U9.27 (IO0); also elsewhere on the board
WIFI_GPIO13: U9.21 (IO13); also elsewhere on the board
WIFI_GPIO14: U9.22 (IO14); also elsewhere on the board
WIFI_GPIO21: U9.23 (IO21); also elsewhere on the board
WIFI_RXD: U9.20 (IO12); also elsewhere on the board
WIFI_TXD: U9.19 (IO11); also elsewhere on the board

Notes on the sheet:
SDcard connected to BANK6 on "usb" sheet
minimum pins for compatible mode SD_CLK, SD_CMD, SD_D0, SD_D3
WIFI_LED v1.7
SD card connected according to Arduino->Examples->ESP32->SD_MMC_Test https://github.com/espressif/esp-idf/blob/ master/examples/storage/sd_card/README.md
WROVER GPIO16,17 used internally for PSRAM
ESP32-S3-WROOM-1-N8R2 (U9, LCSC C2913204) - replaces ESP32-WROOM-32 for native USB on the single USB-C port USB: GPIO19 = USB_DN, GPIO20 = USB_DP -> USBLC6 (usbc_pd sheet) -> USB-C J17. Default: built-in USB-Serial-JTAG (CDC console + flashing, no DTR/RTS needed). Application firmware may switch to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
WiFi and SDcard connected to BANK6 on "usb" sheet

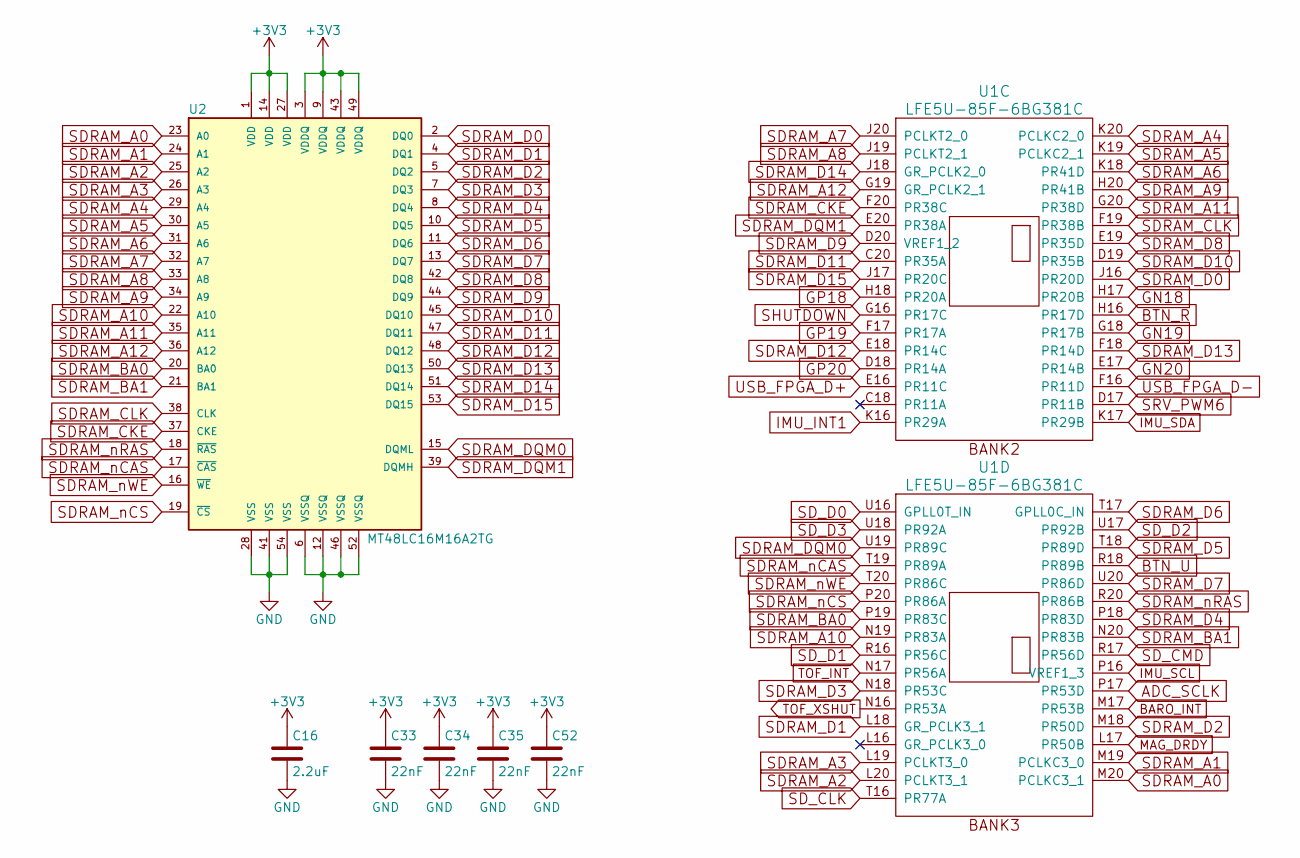
[picture p7: schematic ram.kicad_sch, FPGA CAM LCD]

Parts:
C16: 2.2uF; C_0805_2012Metric
C33, C34, C35, C52: 22nF; C_0603_1608Metric; MPN CX0603MRX7R8BB223
U1: LFE5U-85F-6BG381C; BGA-381_pitch0.8mm_dia0.4mm; MPN LFE5U-85F-6BG381C
U2: MT48LC16M16A2TG; TSOP54; MPN MT48LC16M16A2TG-6A; Mouser 870-IS42S16160G7TLTR

Connections:
+3V3: C16.1, C33.1, C34.1, C35.1, C52.1, U2.1 (VDD), U2.3 (VDDQ), U2.9 (VDDQ), U2.14 (VDD), U2.27 (VDD), U2.43 (VDDQ), U2.49 (VDDQ); also elsewhere on the board
ADC_SCLK: U1.P17 (PR53D)
BARO_INT: U1.M17 (PR53B); also elsewhere on the board
BTN_R: U1.H16 (PR17D)
BTN_U: U1.R18 (PR89B)
GN18: U1.H17 (PR20B)
GN19: U1.G18 (PR17B)
GN20: U1.E17 (PR14B)
GND: C16.2, C33.2, C34.2, C35.2, C52.2, U2.6 (VSSQ), U2.12 (VSSQ), U2.28 (VSS), U2.41 (VSS), U2.46 (VSSQ), U2.52 (VSSQ), U2.54 (VSS); also elsewhere on the board
GP18: U1.H18 (PR20A)
GP19: U1.F17 (PR17A)
GP20: U1.D18 (PR14A)
IMU_INT1: U1.K16 (PR29A); also elsewhere on the board
IMU_SCL: U1.P16 (VREF1_3); also elsewhere on the board
IMU_SDA: U1.K17 (PR29B); also elsewhere on the board
MAG_DRDY: U1.L17 (PR50B); also elsewhere on the board
SDRAM_A0: U1.M20 (PCLKC3_1), U2.23 (A0)
SDRAM_A1: U1.M19 (PCLKC3_0), U2.24 (A1)
SDRAM_A2: U1.L20 (PCLKT3_1), U2.25 (A2)
SDRAM_A3: U1.L19 (PCLKT3_0), U2.26 (A3)
SDRAM_A4: U1.K20 (PCLKC2_0), U2.29 (A4)
SDRAM_A5: U1.K19 (PCLKC2_1), U2.30 (A5)
SDRAM_A6: U1.K18 (PR41D), U2.31 (A6)
SDRAM_A7: U1.J20 (PCLKT2_0), U2.32 (A7)
SDRAM_A8: U1.J19 (PCLKT2_1), U2.33 (A8)
SDRAM_A9: U1.H20 (PR41B), U2.34 (A9)
SDRAM_A10: U1.N19 (PR83A), U2.22 (A10)
SDRAM_A11: U1.G20 (PR38D), U2.35 (A11)
SDRAM_A12: U1.G19 (GR_PCLK2_1), U2.36 (A12)
SDRAM_BA0: U1.P19 (PR83C), U2.20 (BA0)
SDRAM_BA1: U1.N20 (PR83B), U2.21 (BA1)
SDRAM_CKE: U1.F20 (PR38C), U2.37 (CKE)
SDRAM_CLK: U1.F19 (PR38B), U2.38 (CLK)
SDRAM_D0: U1.J16 (PR20D), U2.2 (DQ0)
SDRAM_D1: U1.L18 (GR_PCLK3_1), U2.4 (DQ1)
SDRAM_D2: U1.M18 (PR50D), U2.5 (DQ2)
SDRAM_D3: U1.N18 (PR53C), U2.7 (DQ3)
SDRAM_D4: U1.P18 (PR83D), U2.8 (DQ4)
SDRAM_D5: U1.T18 (PR89D), U2.10 (DQ5)
SDRAM_D6: U1.T17 (GPLL0C_IN), U2.11 (DQ6)
SDRAM_D7: U1.U20 (PR86D), U2.13 (DQ7)
SDRAM_D8: U1.E19 (PR35D), U2.42 (DQ8)
SDRAM_D9: U1.D20 (VREF1_2), U2.44 (DQ9)
SDRAM_D10: U1.D19 (PR35B), U2.45 (DQ10)
SDRAM_D11: U1.C20 (PR35A), U2.47 (DQ11)
SDRAM_D12: U1.E18 (PR14C), U2.48 (DQ12)
SDRAM_D13: U1.F18 (PR14D), U2.50 (DQ13)
SDRAM_D14: U1.J18 (GR_PCLK2_0), U2.51 (DQ14)
SDRAM_D15: U1.J17 (PR20C), U2.53 (DQ15)
SDRAM_DQM0: U1.U19 (PR89C), U2.15 (DQML)
SDRAM_DQM1: U1.E20 (PR38A), U2.39 (DQMH)
SDRAM_nCAS: U1.T19 (PR89A), U2.17 (~CAS)
SDRAM_nCS: U1.P20 (PR86A), U2.19 (~CS)
SDRAM_nRAS: U1.R20 (PR86B), U2.18 (~RAS)
SDRAM_nWE: U1.T20 (PR86C), U2.16 (~WE)
SD_CLK: U1.T16 (PR77A); also elsewhere on the board
SD_CMD: U1.R17 (PR56D); also elsewhere on the board
SD_D0: U1.U16 (GPLL0T_IN); also elsewhere on the board
SD_D1: U1.R16 (PR56C); also elsewhere on the board
SD_D2: U1.U17 (PR92B); also elsewhere on the board
SD_D3: U1.U18 (PR92A); also elsewhere on the board
SHUTDOWN: U1.G16 (PR17C); also elsewhere on the board
SRV_PWM6: U1.D17 (PR11B); also elsewhere on the board
TOF_INT: U1.N17 (PR56A); also elsewhere on the board
TOF_XSHUT: U1.N16 (PR53A); also elsewhere on the board
USB_FPGA_D+: U1.E16 (PR11C)
USB_FPGA_D-: U1.F16 (PR11D)
