jharvey/FPGA_CAM-LCD/FCL.kicad_pcb

## KiCad design FCL.kicad_pcb (continued)

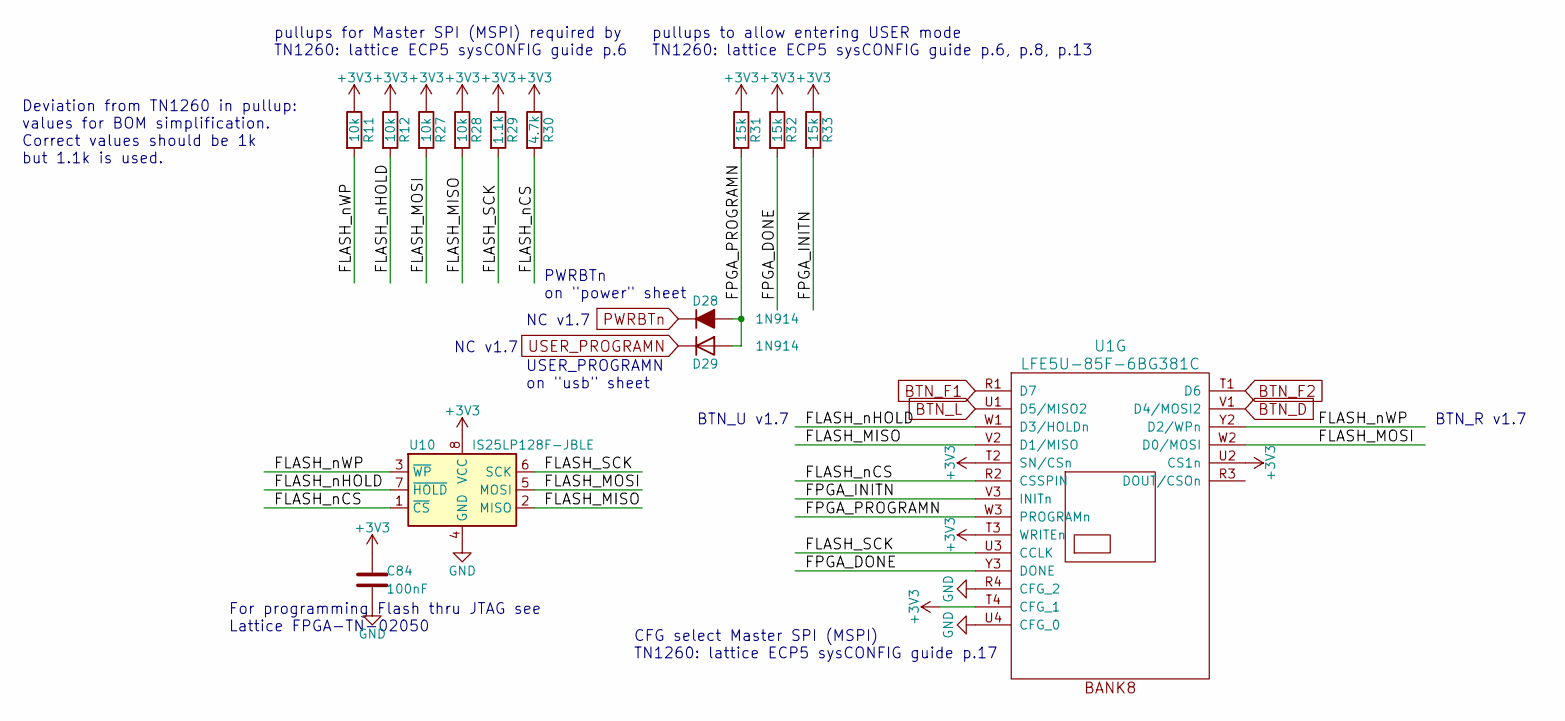
[picture p8: schematic flash.kicad_sch, FPGA CAM LCD]

Parts:
C84: 100nF; C_0402_1005Metric; LCSC C1525
D28: 1N914; D_SOD-323_HandSoldering; Digike_y 1N4148WXTPMSCT-ND
D29: 1N914; D_SOD-323_HandSoldering
R11: 10k; R_0603_1608Metric; MPN RC0603FR-0710KL; Mouser 603-RC0603FR-0710KL
R12, R27, R28: 10k; R_0603_1608Metric
R29: 1.1k; R_0603_1608Metric
R30: 4.7k; R_0603_1608Metric; MPN AC0603FR-104K7L
R31, R32, R33: 15k; R_0603_1608Metric
U1: LFE5U-85F-6BG381C; BGA-381_pitch0.8mm_dia0.4mm; MPN LFE5U-85F-6BG381C
U10: IS25LP128F-JBLE; SOA008-150-208mil; MPN IS25LP128F-JBLE; Mouser 454-W25Q128JVSIMTR

Connections:
+3V3: C84.1, R11.1, R12.1, R27.1, R28.1, R29.1, R30.1, R31.1, R32.1, R33.1, U1.T2 (SN/CSn), U1.T3 (WRITEn), U1.T4 (CFG_1), U1.U2 (CS1n), U10.8 (VCC); also elsewhere on the board
/flash/FLASH_MISO: R28.2, U1.V2 (D1/MISO), U10.2 (MISO)
/flash/FLASH_MOSI: R27.2, U1.W2 (D0/MOSI), U10.5 (MOSI)
/flash/FLASH_SCK: R29.2, U1.U3 (CCLK), U10.6 (SCK)
/flash/FLASH_nCS: R30.2, U1.R2 (CSSPIN), U10.1 (~CS)
/flash/FLASH_nHOLD: R12.2, U1.W1 (D3/HOLDn), U10.7 (~HOLD)
/flash/FLASH_nWP: R11.2, U1.Y2 (D2/WPn), U10.3 (~WP)
/flash/FPGA_DONE: R32.2, U1.Y3 (DONE)
/flash/FPGA_INITN: R33.2, U1.V3 (INITn)
/flash/FPGA_PROGRAMN: D28.2 (A), D29.2 (A), R31.2, U1.W3 (PROGRAMn)
BTN_D: U1.V1 (D4/MOSI2)
BTN_F1: U1.R1 (D7)
BTN_F2: U1.T1 (D6)
BTN_L: U1.U1 (D5/MISO2)
GND: C84.2, U1.R4 (CFG_2), U1.U4 (CFG_0), U10.4 (GND); also elsewhere on the board
PWRBTn: D28.1 (K); also elsewhere on the board
USER_PROGRAMN: D29.1 (K); also elsewhere on the board

Notes on the sheet:
CFG select Master SPI (MSPI) TN1260: lattice ECP5 sysCONFIG guide p.17
USER_PROGRAMN on "usb" sheet
NC v1.7
For programming Flash thru JTAG see Lattice FPGA-TN-02050
Deviation from TN1260 in pullup: values for BOM simplification. Correct values should be 1k but 1.1k is used.
BTN_R v1.7
pullups to allow entering USER mode TN1260: lattice ECP5 sysCONFIG guide p.6, p.8, p.13
PWRBTn on "power" sheet
BTN_U v1.7
pullups for Master SPI (MSPI) required by TN1260: lattice ECP5 sysCONFIG guide p.6

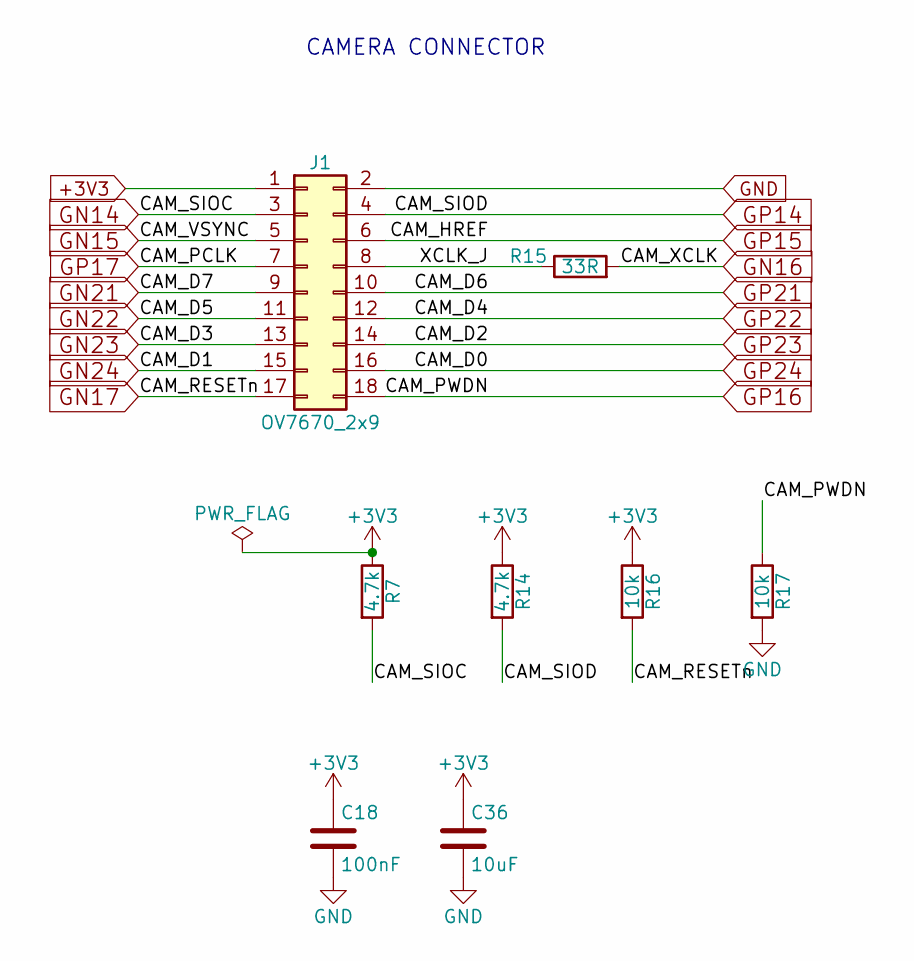
[picture p9: schematic camera.kicad_sch, FPGA CAM LCD - Camera]

Parts:
C18: 100nF; C_0402_1005Metric; LCSC C1525
C36: 10uF; C_0805_2012Metric; LCSC C15850
J1: OV7670_2x9; PinSocket_2x09_P2.54mm_Vertical; LCSC C71956
R7, R14: 4.7k; R_0402_1005Metric; LCSC C25900
R15: 33R; R_0402_1005Metric; LCSC C25105
R16, R17: 10k; R_0402_1005Metric; LCSC C25744

Connections:
+3V3: C18.1, C36.1, J1.1, R7.1, R14.1, R16.1; also elsewhere on the board
/camera/XCLK_J: J1.8, R15.1
CAM_XCLK: R15.2; also elsewhere on the board
GN14: J1.3, R7.2; also elsewhere on the board
GN15: J1.5; also elsewhere on the board
GN17: J1.17, R16.2; also elsewhere on the board
GN21: J1.9; also elsewhere on the board
GN22: J1.11; also elsewhere on the board
GN23: J1.13; also elsewhere on the board
GN24: J1.15; also elsewhere on the board
GND: C18.2, C36.2, J1.2, R17.2; also elsewhere on the board
GP14: J1.4, R14.2; also elsewhere on the board
GP15: J1.6; also elsewhere on the board
GP16: J1.18, R17.1; also elsewhere on the board
GP17: J1.7; also elsewhere on the board
GP21: J1.10; also elsewhere on the board
GP22: J1.12; also elsewhere on the board
GP23: J1.14; also elsewhere on the board
GP24: J1.16; also elsewhere on the board

Notes on the sheet:
CAMERA CONNECTOR

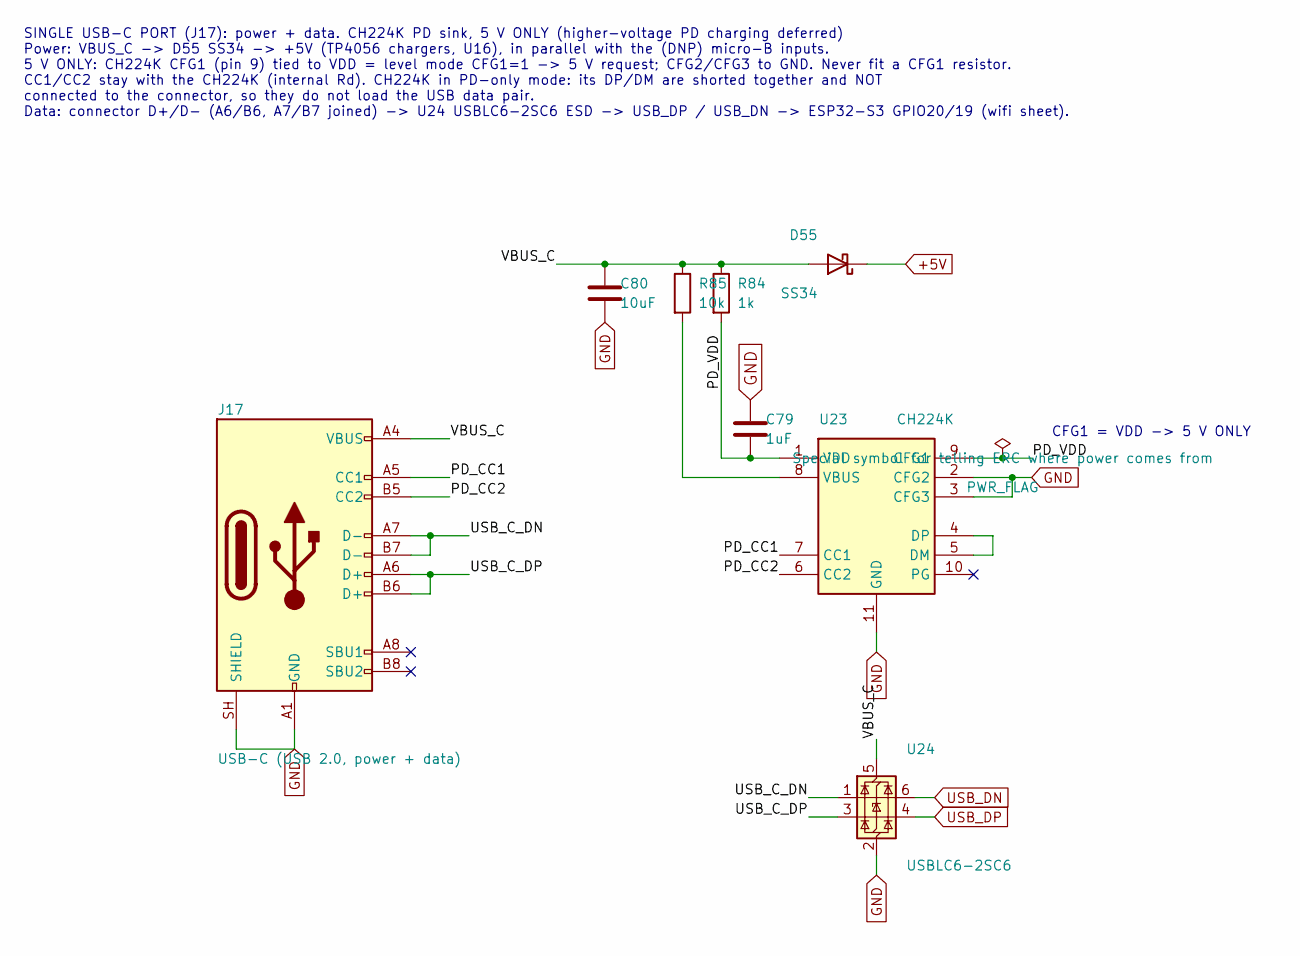
[picture p10: schematic usbc_pd.kicad_sch, FPGA CAM LCD - USB-C 5 V PD sink]

Parts:
C79: 1uF; C_0603_1608Metric; LCSC C15849
C80: 10uF; C_0805_2012Metric; LCSC C15850
D55: SS34; D_SMA; MPN SS34; LCSC C8678
J17: USB-C (USB 2.0, power + data); USB_C_Receptacle_HCTL_HC-TYPE-C-16P-01A; MPN HC-TYPE-C-16P-01A; LCSC C2894897
R84: 1k; R_0603_1608Metric; LCSC C21190
R85: 10k; R_0402_1005Metric; LCSC C25744
U23: CH224K; SSOP-10-1EP_3.9x4.9mm_P1mm_EP2.1x3.3mm; MPN CH224K; LCSC C970725
U24: USBLC6-2SC6; SOT-23-6; MPN USBLC6-2SC6; LCSC C7519

Connections:
+5V: D55.1 (K); also elsewhere on the board
/usbc_pd/PD_CC1: J17.A5 (CC1), U23.7 (CC1)
/usbc_pd/PD_CC2: J17.B5 (CC2), U23.6 (CC2)
/usbc_pd/PD_VDD: C79.2, R84.2, U23.1 (VDD), U23.9 (CFG1)
/usbc_pd/USB_C_DN: J17.A7 (D-), J17.B7 (D-), U24.1 (I/O1)
/usbc_pd/USB_C_DP: J17.A6 (D+), J17.B6 (D+), U24.3 (I/O2)
/usbc_pd/VBUS_C: C80.1, D55.2 (A), J17.A4 (VBUS), J17.A9 (VBUS), J17.B4 (VBUS), J17.B9 (VBUS), R84.1, R85.1, U24.5 (VBUS)
GND: C79.1, C80.2, J17.A1 (GND), J17.A12 (GND), J17.B1 (GND), J17.B12 (GND), J17.SH (SHIELD), U23.2 (CFG2), U23.3 (CFG3), U23.11 (GND), U24.2 (GND); also elsewhere on the board
unnamed: U23.4 (DP), U23.5 (DM)
unnamed: R85.2, U23.8 (VBUS)
USB_DN: U24.6 (I/O1); also elsewhere on the board
USB_DP: U24.4 (I/O2); also elsewhere on the board

Notes on the sheet:
CFG1 = VDD -> 5 V ONLY
SINGLE USB-C PORT (J17): power + data. CH224K PD sink, 5 V ONLY (higher-voltage PD charging deferred) Power: VBUS_C -> D55 SS34 -> +5V (TP4056 chargers, U16), in parallel with the (DNP) micro-B inputs. 5 V ONLY: CH224K CFG1 (pin 9) tied to VDD = level mode CFG1=1 -> 5 V request; CFG2/CFG3 to GND. N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

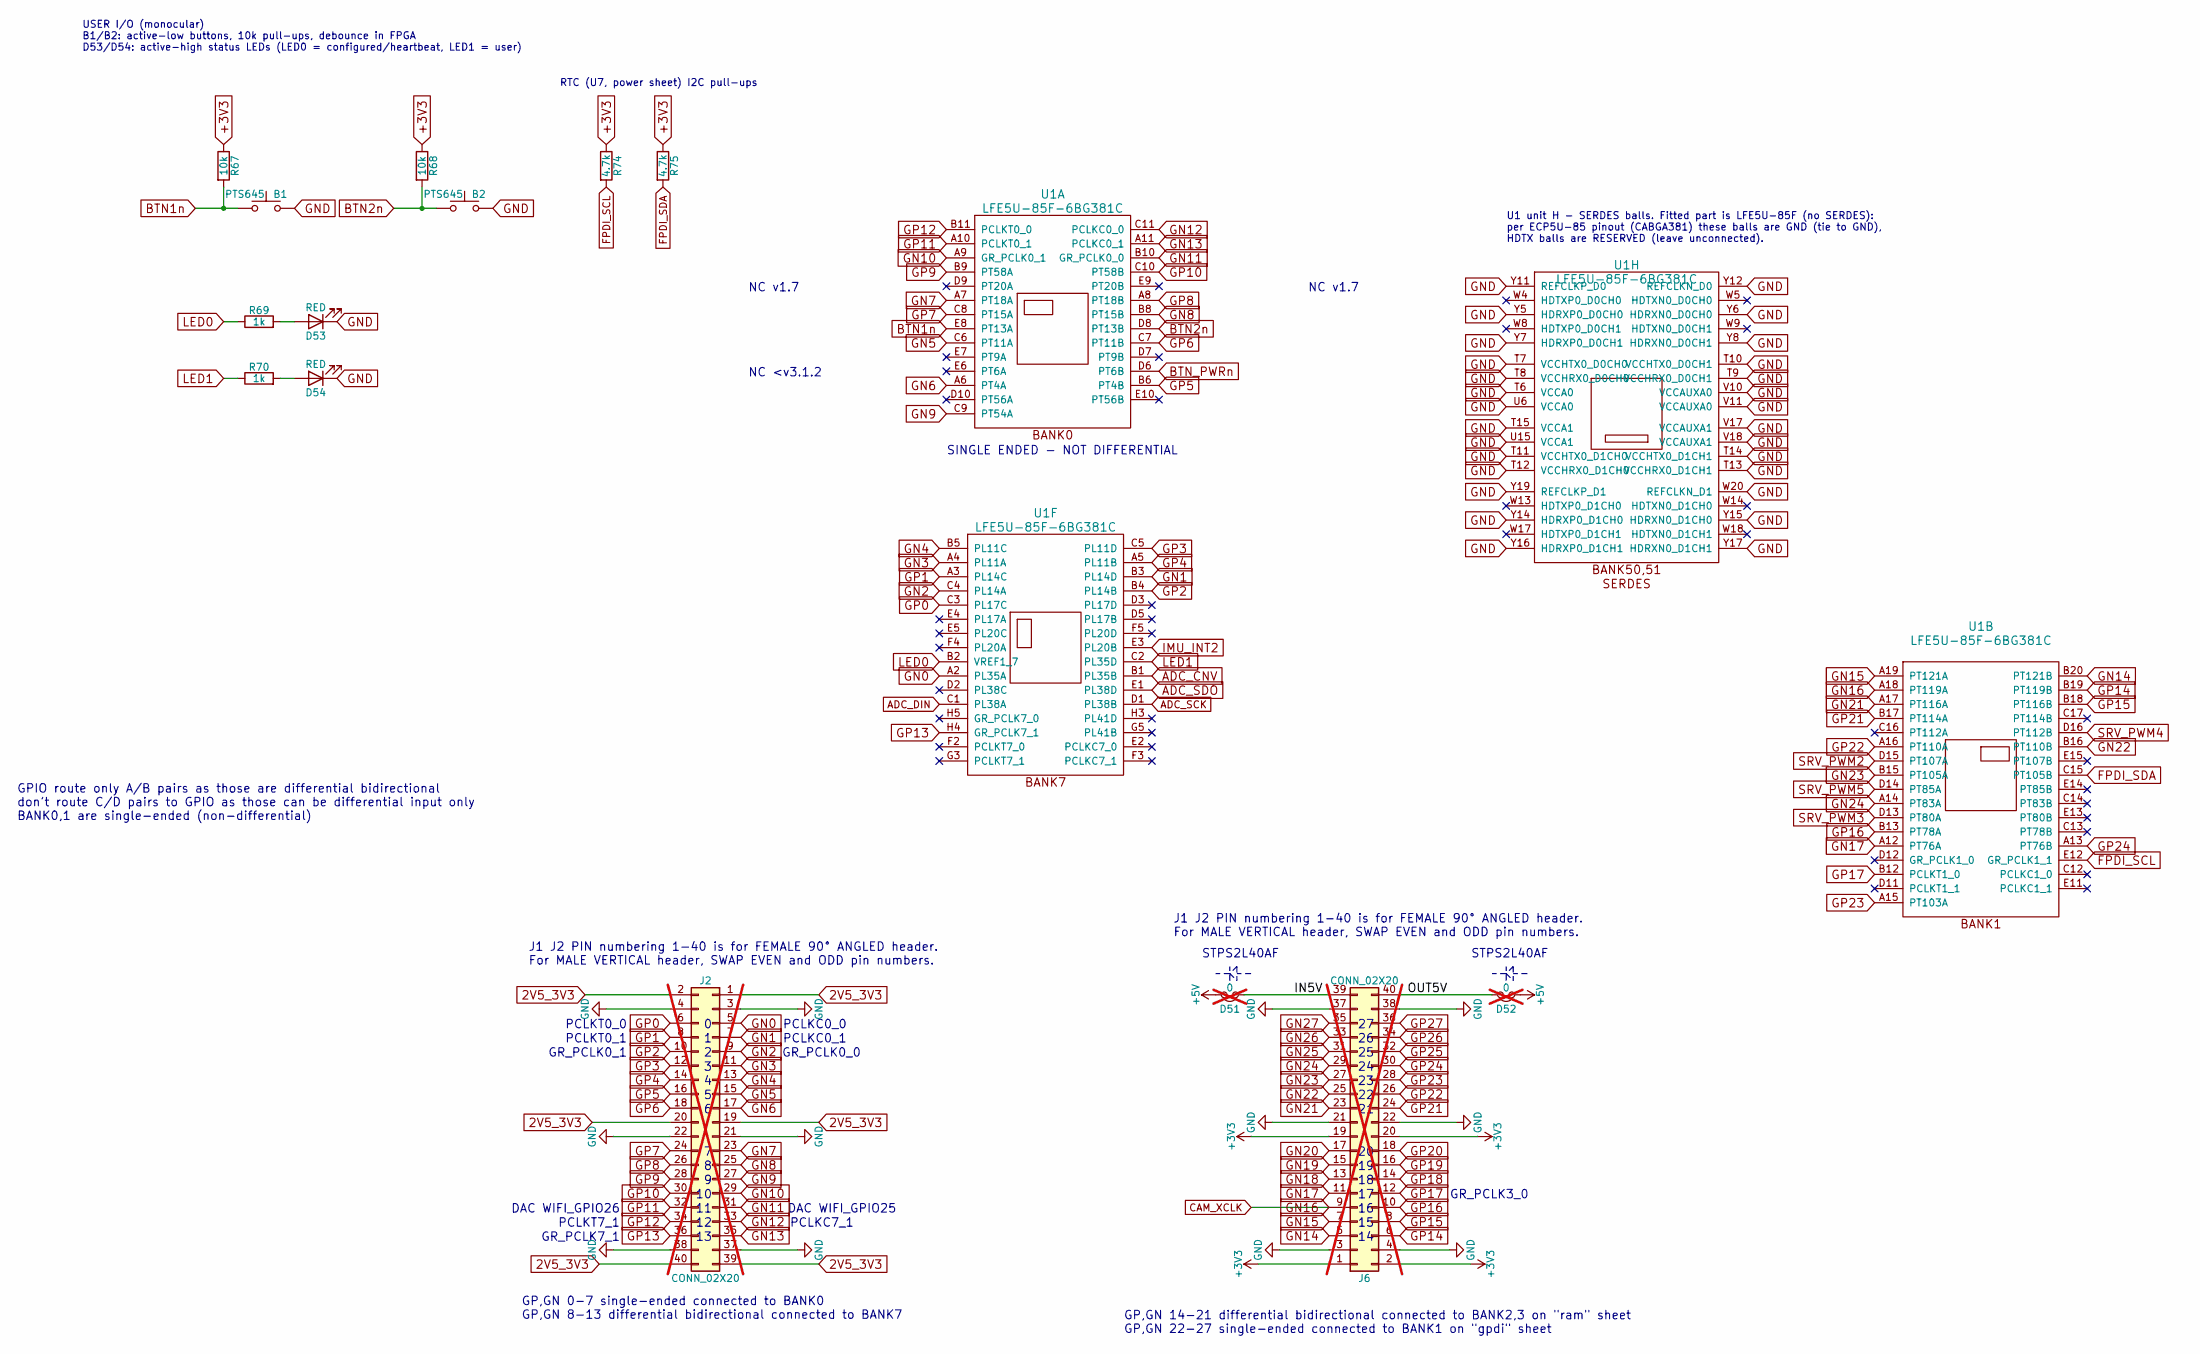
[picture p11: schematic fpga-io.kicad_sch, FPGA CAM LCD - GPIO / FPGA banks]

Parts:
B1, B2: PTS645; SW_SPST_PTS645Sx43SMTR92; MPN PTS645SL50SMTR92 LFS; Mouser 611-PTS645SL50SMTR92
D51, D52: 0; D_SMA_Jumper_NC; not fitted
D53, D54: RED; LED_0603_1608Metric; LCSC C2286
J2, J6: CONN_02X20; PinSocket_2x20_P2.54mm_Horizontal; not fitted
R67, R68: 10k; R_0402_1005Metric; LCSC C25744
R69, R70: 1k; R_0603_1608Metric; LCSC C21190
R74, R75: 4.7k; R_0402_1005Metric; LCSC C25900
U1: LFE5U-85F-6BG381C; BGA-381_pitch0.8mm_dia0.4mm; MPN LFE5U-85F-6BG381C

Connections:
+3V3: R67.1, R68.1, R74.1, R75.1; also elsewhere on the board
ADC_CNV: U1.B1 (PL35B); also elsewhere on the board
ADC_DIN: U1.C1 (PL38A); also elsewhere on the board
ADC_SCK: U1.D1 (PL38B); also elsewhere on the board
ADC_SDO: U1.E1 (PL38D); also elsewhere on the board
BTN1n: B1.2, R67.2, U1.E8 (PT13A)
BTN2n: B2.2, R68.2, U1.D8 (PT13B)
BTN_PWRn: U1.D6 (PT6B); also elsewhere on the board
CAM_XCLK: J6.9, U1.A18 (PT119A); also elsewhere on the board
FPDI_SCL: R74.2, U1.E12 (GR_PCLK1_1); also elsewhere on the board
FPDI_SDA: R75.2, U1.C15 (PT105B); also elsewhere on the board
GN0: J2.5, U1.A2 (PL35A); also elsewhere on the board
GN1: J2.7, U1.B3 (PL14D); also elsewhere on the board
GN2: J2.9, U1.C4 (PL14A); also elsewhere on the board
GN3: J2.11, U1.A4 (PL11A); also elsewhere on the board
GN4: J2.13, U1.B5 (PL11C); also elsewhere on the board
GN5: J2.15, U1.C6 (PT11A); also elsewhere on the board
GN6: J2.17, U1.A6 (PT4A); also elsewhere on the board
GN7: J2.23, U1.A7 (PT18A); also elsewhere on the board
GN8: J2.25, U1.B8 (PT15B); also elsewhere on the board
GN9: J2.27, U1.C9 (PT54A); also elsewhere on the board
GN10: J2.29, U1.A9 (GR_PCLK0_1); also elsewhere on the board
GN11: J2.31, U1.B10 (GR_PCLK0_0); also elsewhere on the board
GN12: J2.33, U1.C11 (PCLKC0_0); also elsewhere on the board
GN13: J2.35, U1.A11 (PCLKC0_1); also elsewhere on the board
GN14: J6.5, U1.B20 (PT121B); also elsewhere on the board
GN15: J6.7, U1.A19 (PT121A); also elsewhere on the board
GN17: J6.11, U1.A12 (PT76A); also elsewhere on the board
GN21: J6.23, U1.A17 (PT116A); also elsewhere on the board
GN22: J6.25, U1.B16 (PT110B); also elsewhere on the board
GN23: J6.27, U1.B15 (PT105A); also elsewhere on the board
GN24: J6.29, U1.A14 (PT83A); also elsewhere on the board
GND: B1.1, B2.1, D53.1 (K), D54.1 (K), U1.T6 (VCCA0), U1.T7 (VCCHTX0_D0CH0), U1.T8 (VCCHRX0_D0CH0), U1.T9 (VCCHRX0_D0CH1), U1.T10 (VCCHTX0_D0CH1), U1.T11 (VCCHTX0_D1CH0), U1.T12 (VCCHRX0_D1CH0), U1.T13 (VCCHRX0_D1CH1), U1.T14 (VCCHTX0_D1CH1), U1.T15 (VCCA1), U1.U6 (VCCA0), U1.U15 (VCCA1), U1.V10 (VCCAUXA0), U1.V11 (VCCAUXA0), U1.V17 (VCCAUXA1), U1.V18 (VCCAUXA1), U1.W20 (REFCLKN_D1), U1.Y5 (HDRXP0_D0CH0), U1.Y6 (HDRXN0_D0CH0), U1.Y7 (HDRXP0_D0CH1), U1.Y8 (HDRXN0_D0CH1), U1.Y11 (REFCLKP_D0), U1.Y12 (REFCLKN_D0), U1.Y14 (HDRXP0_D1CH0), U1.Y15 (HDRXN0_D1CH0), U1.Y16 (HDRXP0_D1CH1), U1.Y17 (HDRXN0_D1CH1), U1.Y19 (REFCLKP_D1); also elsewhere on the board
GP0: J2.6, U1.C3 (PL17C); also elsewhere on the board
GP1: J2.8, U1.A3 (PL14C); also elsewhere on the board
GP2: J2.10, U1.B4 (PL14B); also elsewhere on the board
GP3: J2.12, U1.C5 (PL11D); also elsewhere on the board
GP4: J2.14, U1.A5 (PL11B); also elsewhere on the board
GP5: J2.16, U1.B6 (PT4B); also elsewhere on the board
GP6: J2.18, U1.C7 (PT11B); also elsewhere on the board
GP7: J2.24, U1.C8 (PT15A); also elsewhere on the board
GP8: J2.26, U1.A8 (PT18B); also elsewhere on the board
GP9: J2.28, U1.B9 (PT58A); also elsewhere on the board
GP10: J2.30, U1.C10 (PT58B); also elsewhere on the board
GP11: J2.32, U1.A10 (PCLKT0_1); also elsewhere on the board
GP12: J2.34, U1.B11 (PCLKT0_0); also elsewhere on the board
GP13: J2.36, U1.H4 (GR_PCLK7_1); also elsewhere on the board
GP14: J6.6, U1.B19 (PT119B); also elsewhere on the board
GP15: J6.8, U1.B18 (PT116B); also elsewhere on the board
GP16: J6.10, U1.B13 (PT78A); also elsewhere on the board
GP17: J6.12, U1.B12 (PCLKT1_0); also elsewhere on the board
GP21: J6.24, U1.B17 (PT114A); also elsewhere on the board
GP22: J6.26, U1.A16 (PT110A); also elsewhere on the board
GP23: J6.28, U1.A15 (PT103A); also elsewhere on the board
GP24: J6.30, U1.A13 (PT76B); also elsewhere on the board
IMU_INT2: U1.E3 (PL20B); also elsewhere on the board
LED0: R69.1, U1.B2 (VREF1_7)
LED1: R70.1, U1.C2 (PL35D)
unnamed: D51.1, D52.2
unnamed: D51.2, J6.39
unnamed: D52.1, J6.40
unnamed: D53.2 (A), R69.2
unnamed: D54.2 (A), R70.2
unnamed: J2.1, J2.2, J2.19, J2.20, J2.39, J2.40
unnamed: J2.3, J2.4, J2.21, J2.22, J2.37, J2.38, J6.3, J6.4, J6.21, J6.22, J6.37, J6.38
unnamed: J6.1, J6.2, J6.19, J6.20
SRV_PWM2: U1.D15 (PT107A); also elsewhere on the board
SRV_PWM3: U1.D13 (PT80A); also elsewhere on the board
SRV_PWM4: U1.D16 (PT112B); also elsewhere on the board
SRV_PWM5: U1.D14 (PT85A); also elsewhere on the board

Notes on the sheet:
STPS2L40AF
J1 J2 PIN numbering 1-40 is for FEMALE 90° ANGLED header. For MALE VERTICAL header, SWAP EVEN and ODD pin numbers.
PCLKC0_1
NC v1.7
U1 unit H - SERDES balls. Fitted part is LFE5U-85F (no SERDES): per ECP5U-85 pinout (CABGA381) these balls are GND (tie to GND), HDTX balls are RESERVED (leave unconnected).
PCLKC0_0
GR_PCLK0_1
PCLKC7_1
DAC WIFI_GPIO26
PCLKT0_0
GR_PCLK3_0
GP,GN 0-7 single-ended connected to BANK0 GP,GN 8-13 differential bidirectional connected to BANK7
GPIO route only A/B pairs as those are differential bidirectional don't route C/D pairs to GPIO as those can be differential input only BANK0,1 are single-ended (non-differential)
GP,GN 14-21 differential bidirectional connected to BANK2,3 on "ram" sheet GP,GN 22-27 single-ended connected to BANK1 on "gpdi" sheet
GR_PCLK7_1
RTC (U7, power sheet) I2C pull-ups
DAC WIFI_GPIO25
PCLKT7_1
NC <v3.1.2
GR_PCLK0_0
PCLKT0_1
SINGLE ENDED - NOT DIFFERENTIAL
USER I/O (monocular) B1/B2: active-low buttons, 10k pull-ups, debounce in FPGA D53/D54: active-high status LEDs (LED0 = configured/heartbeat, LED1 = user)

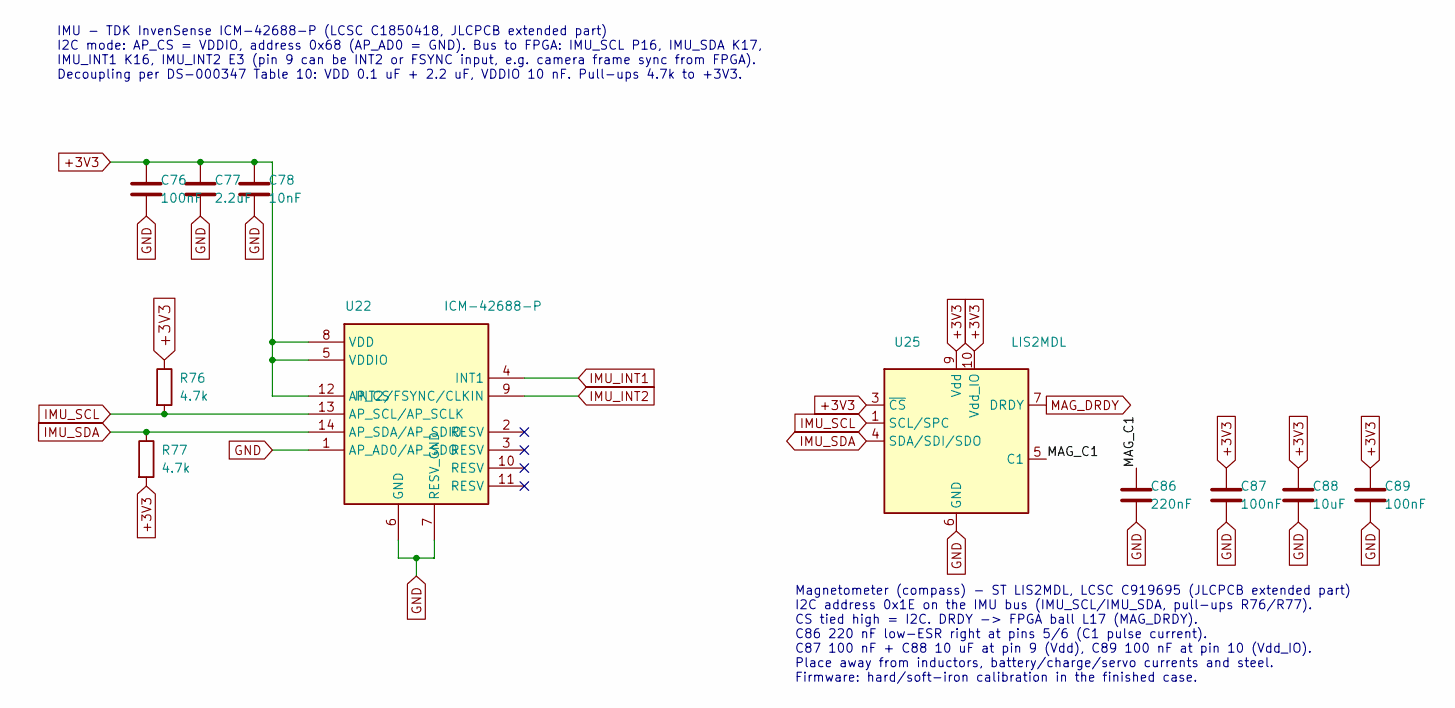
[picture p12: schematic imu.kicad_sch, FPGA CAM LCD - IMU]

Parts:
C76, C87, C89: 100nF; C_0402_1005Metric; LCSC C1525
C77: 2.2uF; C_0805_2012Metric; LCSC C87995
C78: 10nF; C_0402_1005Metric; LCSC C15195
C86: 220nF; C_0603_1608Metric; LCSC C326805
C88: 10uF; C_0805_2012Metric; LCSC C15850
R76, R77: 4.7k; R_0402_1005Metric; LCSC C25900
U22: ICM-42688-P; LGA-14_3x2.5mm_P0.5mm_LayoutBorder3x4y; MPN ICM-42688-P; LCSC C1850418
U25: LIS2MDL; LGA-12_2x2mm_P0.5mm; LCSC C919695

Connections:
+3V3: C76.1, C77.1, C78.1, C87.1, C88.1, C89.1, R76.1, R77.2, U22.5 (VDDIO), U22.8 (VDD), U22.12 (AP_CS), U25.3 (~CS), U25.9 (Vdd), U25.10 (Vdd_IO); also elsewhere on the board
/imu/MAG_C1: C86.1, U25.5 (C1)
GND: C76.2, C77.2, C78.2, C86.2, C87.2, C88.2, C89.2, U22.1 (AP_AD0/AP_SDO), U22.6 (GND), U22.7 (RESV_GND), U25.6 (GND), U25.8 (GND); also elsewhere on the board
IMU_INT1: U22.4 (INT1); also elsewhere on the board
IMU_INT2: U22.9 (INT2/FSYNC/CLKIN); also elsewhere on the board
IMU_SCL: R76.2, U22.13 (AP_SCL/AP_SCLK), U25.1 (SCL/SPC); also elsewhere on the board
IMU_SDA: R77.1, U22.14 (AP_SDA/AP_SDIO), U25.4 (SDA/SDI/SDO); also elsewhere on the board
MAG_DRDY: U25.7 (DRDY); also elsewhere on the board

Notes on the sheet:
IMU - TDK InvenSense ICM-42688-P (LCSC C1850418, JLCPCB extended part) I2C mode: AP_CS = VDDIO, address 0x68 (AP_AD0 = GND). Bus to FPGA: IMU_SCL P16, IMU_SDA K17, IMU_INT1 K16, IMU_INT2 E3 (pin 9 can be INT2 or FSYNC input, e.g. camera frame sync from FPGA). Decoupling per DS-000347 Table 10: VDD 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
Magnetometer (compass) - ST LIS2MDL, LCSC C919695 (JLCPCB extended part) I2C address 0x1E on the IMU bus (IMU_SCL/IMU_SDA, pull-ups R76/R77). CS tied high = I2C. DRDY -> FPGA ball L17 (MAG_DRDY). C86 220 nF low-ESR right at pins 5/6 (C1 pulse current). C87 100 nF + C88 10 uF at pin 9 (Vdd), C89 100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

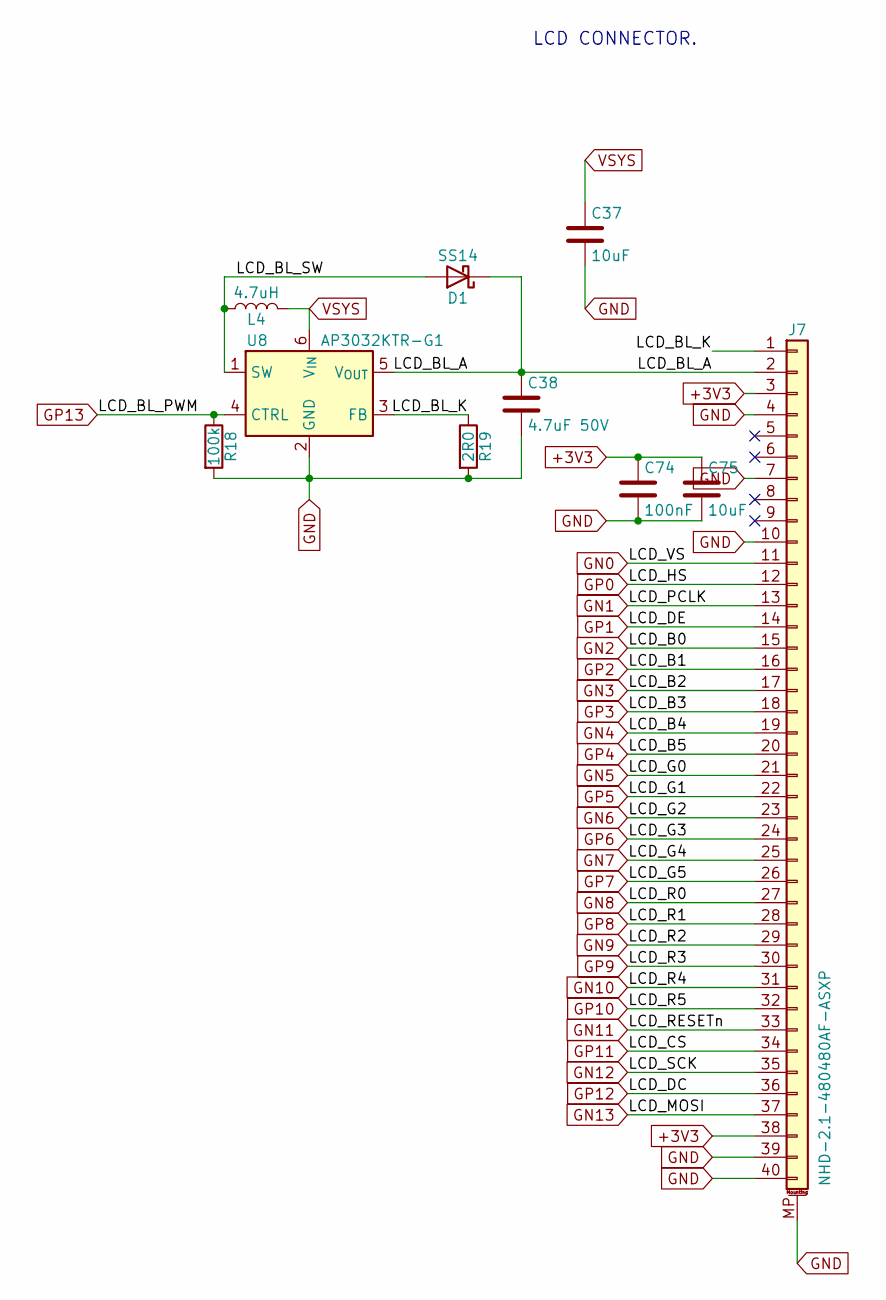
[picture p13: schematic display.kicad_sch, FPGA CAM LCD - Display]

Parts:
C37: 10uF; C_0805_2012Metric; MPN CL21A106KAYNNNE; LCSC C15850
C38: 4.7uF 50V; C_1206_3216Metric; MPN 1206B475K500NT; LCSC C29823
C74: 100nF; C_0402_1005Metric; LCSC C1525
C75: 10uF; C_0805_2012Metric; LCSC C15850
D1: SS14; D_SMA; MPN SS14; LCSC C2480
J7: NHD-2.1-480480AF-ASXP; Hirose_FH12-40S-0.5SH_1x40-1MP_P0.50mm_Horizontal; LCSC C202114
L4: 4.7uH; L_Sunlord_SWPA3015S; MPN SWPA3015S4R7MT; LCSC C19398
R18: 100k; R_0402_1005Metric; LCSC C25741
R19: 2R0; R_0603_1608Metric; MPN 0603WAF200KT5E; LCSC C22977
U8: AP3032KTR-G1; SOT-23-6; MPN AP3032KTR-G1; LCSC C264086

Connections:
+3V3: C74.1, C75.1, J7.3, J7.38; also elsewhere on the board
/display/LCD_BL_A: C38.1, D1.1 (K), J7.2, U8.5 (V_{OUT})
/display/LCD_BL_K: J7.1, R19.1, U8.3 (FB)
/display/LCD_BL_SW: D1.2 (A), L4.1, U8.1 (SW)
GN0: J7.11; also elsewhere on the board
GN1: J7.13; also elsewhere on the board
GN2: J7.15; also elsewhere on the board
GN3: J7.17; also elsewhere on the board
GN4: J7.19; also elsewhere on the board
GN5: J7.21; also elsewhere on the board
GN6: J7.23; also elsewhere on the board
GN7: J7.25; also elsewhere on the board
GN8: J7.27; also elsewhere on the board
GN9: J7.29; also elsewhere on the board
GN10: J7.31; also elsewhere on the board
GN11: J7.33; also elsewhere on the board
GN12: J7.35; also elsewhere on the board
GN13: J7.37; also elsewhere on the board
GND: C37.2, C38.2, C74.2, C75.2, J7.4, J7.7, J7.10, J7.39, J7.40, J7.MP (MountPin), R18.2, R19.2, U8.2 (GND); also elsewhere on the board
GP0: J7.12; also elsewhere on the board
GP1: J7.14; also elsewhere on the board
GP2: J7.16; also elsewhere on the board
GP3: J7.18; also elsewhere on the board
GP4: J7.20; also elsewhere on the board
GP5: J7.22; also elsewhere on the board
GP6: J7.24; also elsewhere on the board
GP7: J7.26; also elsewhere on the board
GP8: J7.28; also elsewhere on the board
GP9: J7.30; also elsewhere on the board
GP10: J7.32; also elsewhere on the board
GP11: J7.34; also elsewhere on the board
GP12: J7.36; also elsewhere on the board
GP13: R18.1, U8.4 (CTRL); also elsewhere on the board
VSYS: C37.1, L4.2, U8.6 (V_{IN}); also elsewhere on the board

Notes on the sheet:
LCD CONNECTOR.

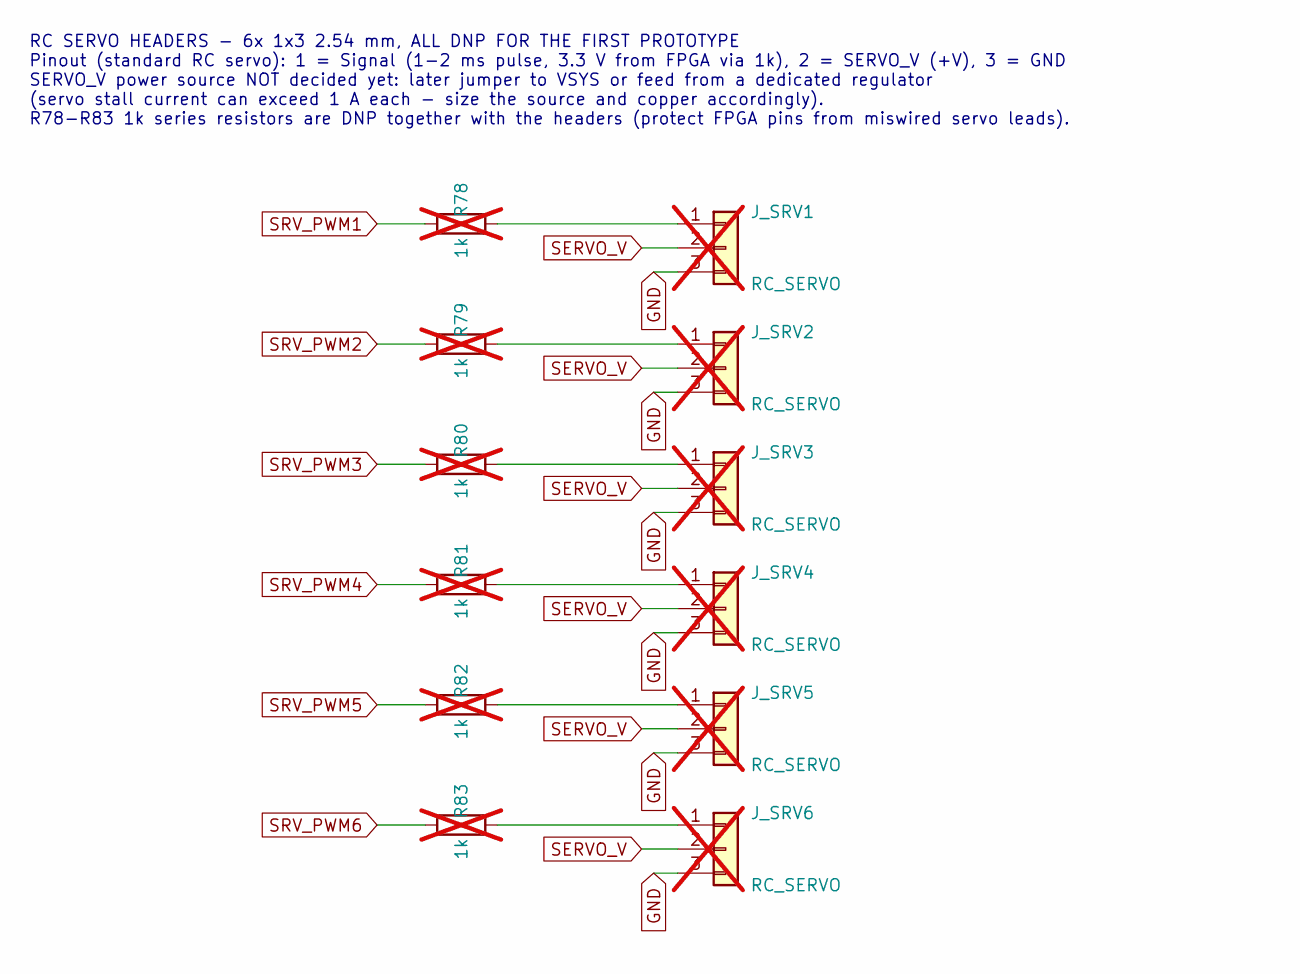
[picture p14: schematic servo.kicad_sch, FPGA CAM LCD - RC servo headers (DNP)]

Parts:
J_SRV1, J_SRV2, J_SRV3, J_SRV4, J_SRV5, J_SRV6: RC_SERVO; PinHeader_1x03_P2.54mm_Vertical; not fitted
R78, R79, R80, R81, R82, R83: 1k; R_0603_1608Metric; LCSC C21190; not fitted

Connections:
GND: J_SRV1.3, J_SRV2.3, J_SRV3.3, J_SRV4.3, J_SRV5.3, J_SRV6.3; also elsewhere on the board
unnamed: J_SRV1.1, R78.2
unnamed: J_SRV2.1, R79.2
unnamed: J_SRV3.1, R80.2
unnamed: J_SRV4.1, R81.2
unnamed: J_SRV5.1, R82.2
unnamed: J_SRV6.1, R83.2
SERVO_V: J_SRV1.2, J_SRV2.2, J_SRV3.2, J_SRV4.2, J_SRV5.2, J_SRV6.2
SRV_PWM1: R78.1; also elsewhere on the board
SRV_PWM2: R79.1; also elsewhere on the board
SRV_PWM3: R80.1; also elsewhere on the board
SRV_PWM4: R81.1; also elsewhere on the board
SRV_PWM5: R82.1; also elsewhere on the board
SRV_PWM6: R83.1; also elsewhere on the board

Notes on the sheet:
RC SERVO HEADERS - 6x 1x3 2.54 mm, ALL DNP FOR THE FIRST PROTOTYPE Pinout (standard RC servo): 1 = Signal (1-2 ms pulse, 3.3 V from FPGA via 1k), 2 = SERVO_V (+V), 3 = GND SERVO_V power source NOT decided yet: later jumper to VSYS or feed from a dedicated regulator (servo stall current can exceed 1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
