jharvey/FPGA_CAM-LCD/FCL.kicad_pcb

## KiCad design FCL.kicad_pcb (continued)

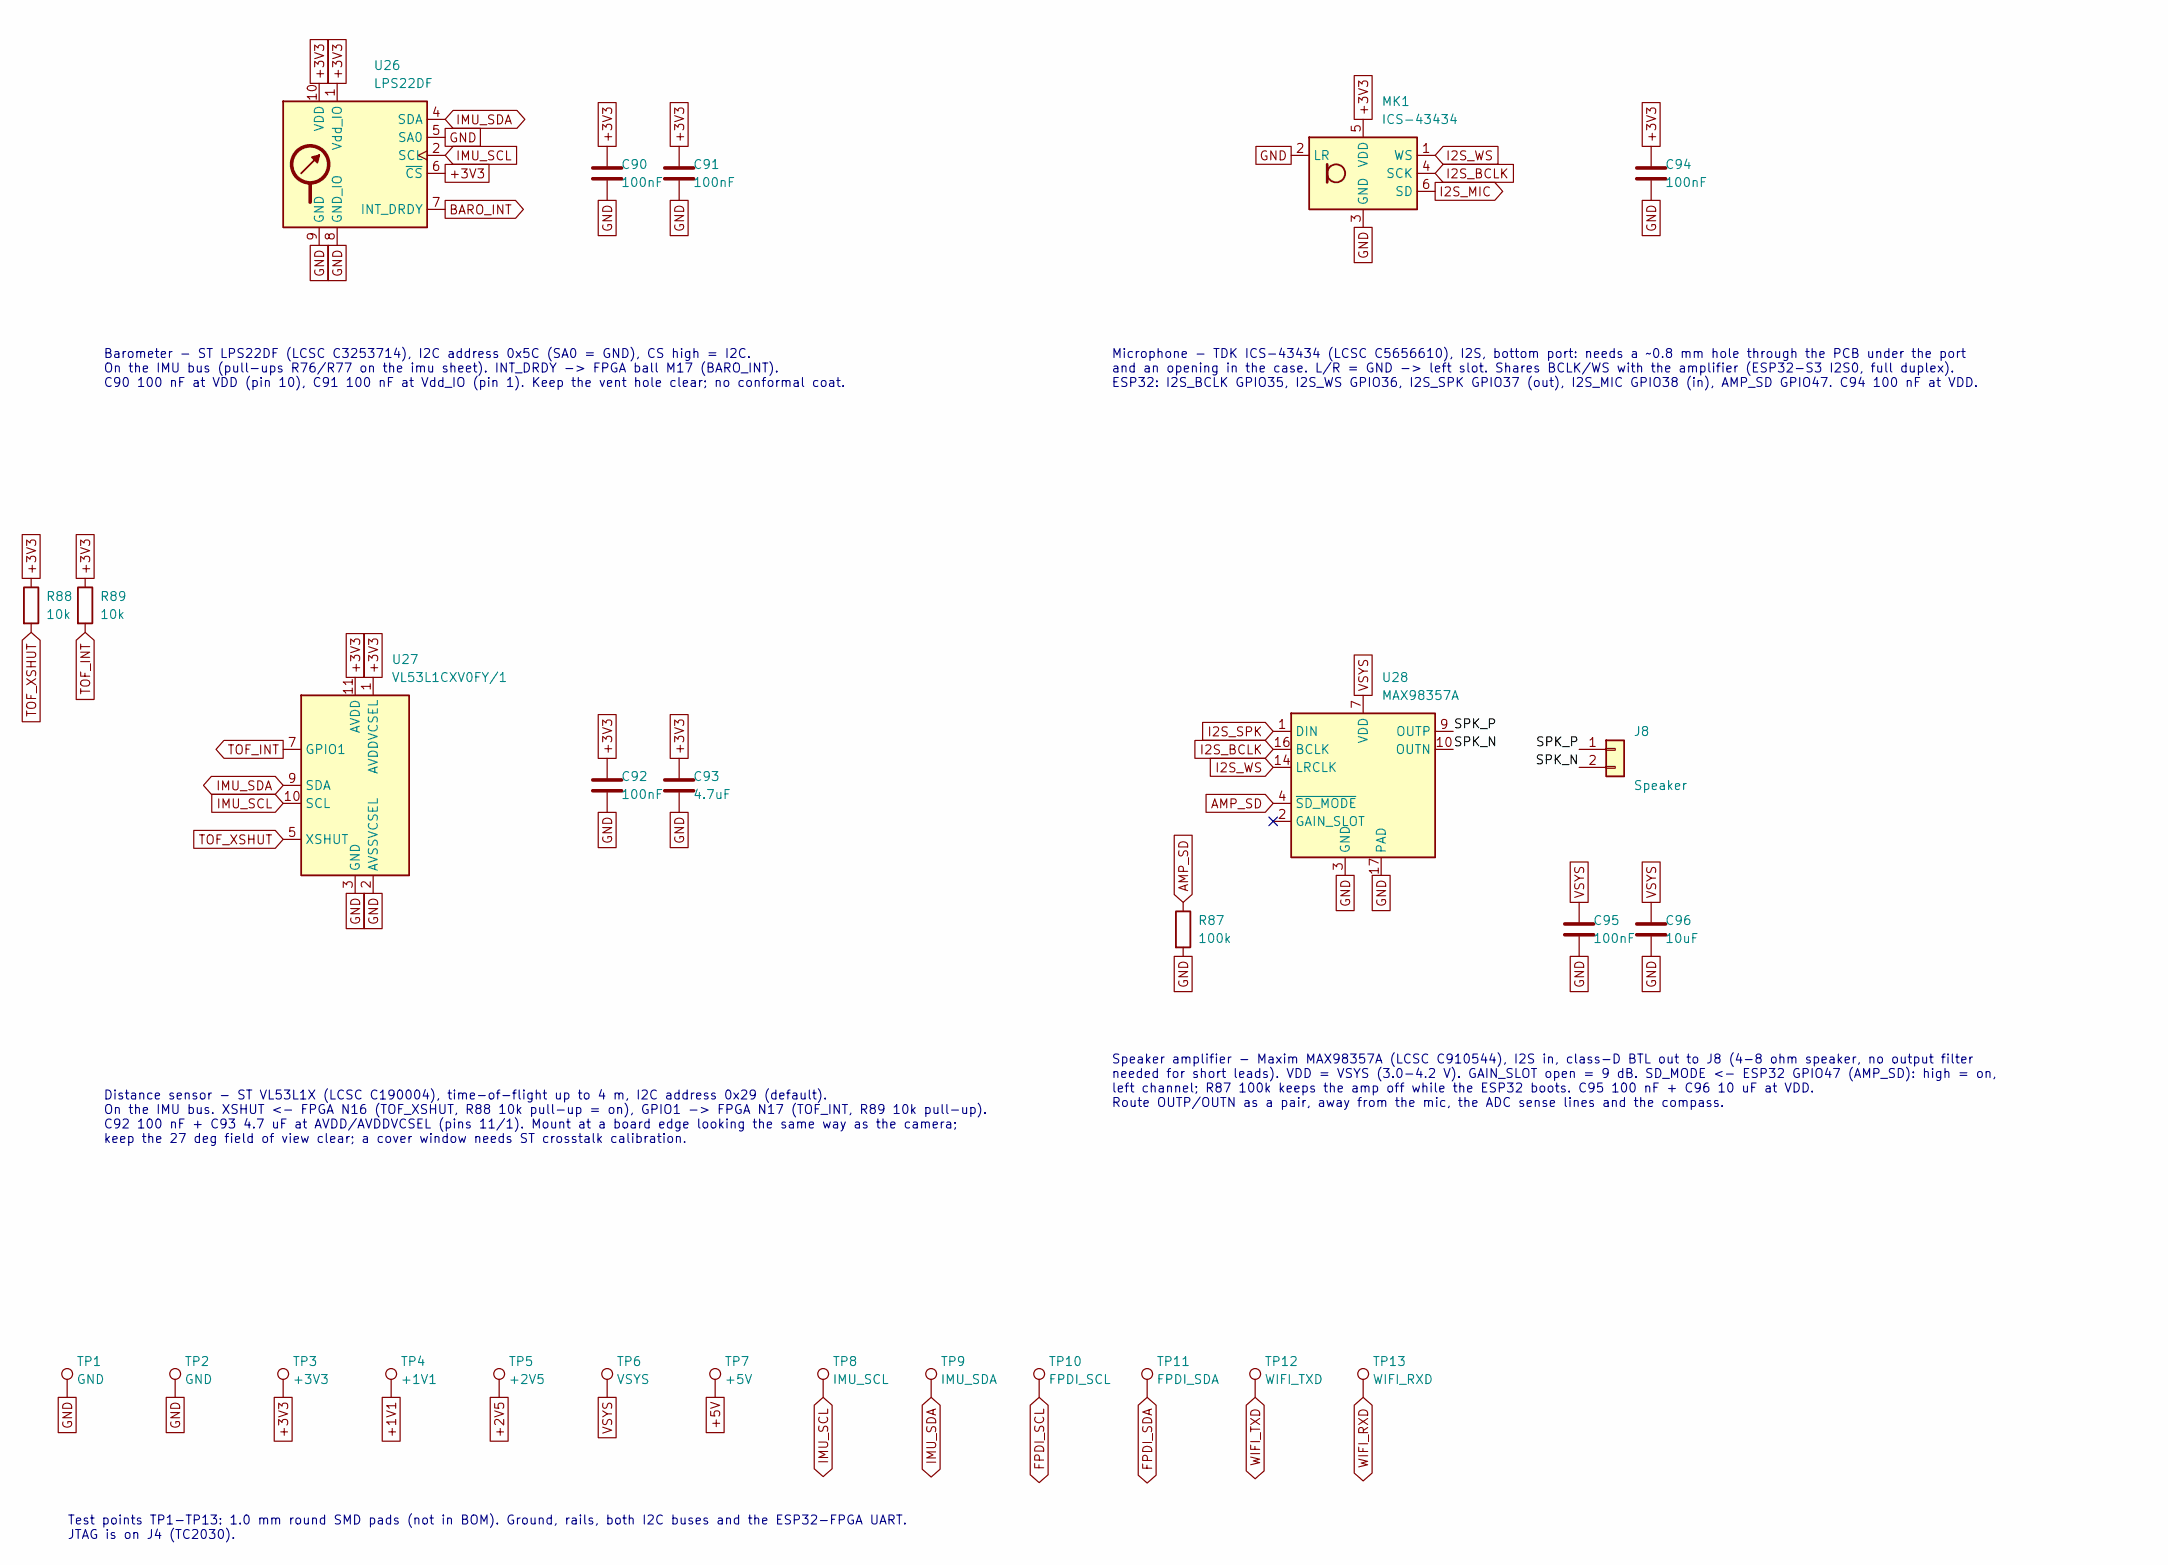
[picture p15: schematic peripherals.kicad_sch, FPGA CAM LCD - Peripherals]

Parts:
C90, C91, C92, C94, C95: 100nF; C_0402_1005Metric; LCSC C1525
C93: 4.7uF; C_0603_1608Metric; LCSC C19666
C96: 10uF; C_0805_2012Metric; LCSC C15850
J8: Speaker; JST_SH_BM02B-SRSS-TB_1x02-1MP_P1.00mm_Vertical; LCSC C160388
MK1: ICS-43434; InvenSense_ICS-43434-6_3.5x2.65mm; LCSC C5656610
R87: 100k; R_0402_1005Metric; LCSC C25741
R88, R89: 10k; R_0402_1005Metric; LCSC C25744
TP1, TP2: GND; TestPoint_Pad_D1.0mm
TP3: +3V3; TestPoint_Pad_D1.0mm
TP4: +1V1; TestPoint_Pad_D1.0mm
TP5: +2V5; TestPoint_Pad_D1.0mm
TP6: VSYS; TestPoint_Pad_D1.0mm
TP7: +5V; TestPoint_Pad_D1.0mm
TP8: IMU_SCL; TestPoint_Pad_D1.0mm
TP9: IMU_SDA; TestPoint_Pad_D1.0mm
TP10: FPDI_SCL; TestPoint_Pad_D1.0mm
TP11: FPDI_SDA; TestPoint_Pad_D1.0mm
TP12: WIFI_TXD; TestPoint_Pad_D1.0mm
TP13: WIFI_RXD; TestPoint_Pad_D1.0mm
U26: LPS22DF; ST_HLGA-10_2x2mm_P0.5mm_LayoutBorder3x2y; LCSC C3253714
U27: VL53L1CXV0FY/1; ST_VL53L1x; LCSC C190004
U28: MAX98357A; TQFN-16-1EP_3x3mm_P0.5mm_EP1.23x1.23mm; LCSC C910544

Connections:
+1V1: TP4.1; also elsewhere on the board
+2V5: TP5.1; also elsewhere on the board
+3V3: C90.1, C91.1, C92.1, C93.1, C94.1, MK1.5 (VDD), R88.1, R89.1, TP3.1, U26.1 (Vdd_IO), U26.6 (~CS), U26.10 (VDD), U27.1 (AVDDVCSEL), U27.11 (AVDD); also elsewhere on the board
+5V: TP7.1; also elsewhere on the board
/peripherals/SPK_N: J8.2, U28.10 (OUTN)
/peripherals/SPK_P: J8.1, U28.9 (OUTP)
AMP_SD: R87.1, U28.4 (~SD_MODE); also elsewhere on the board
BARO_INT: U26.7 (INT_DRDY); also elsewhere on the board
FPDI_SCL: TP10.1; also elsewhere on the board
FPDI_SDA: TP11.1; also elsewhere on the board
GND: C90.2, C91.2, C92.2, C93.2, C94.2, C95.2, C96.2, MK1.2 (LR), MK1.3 (GND), R87.2, TP1.1, TP2.1, U26.3 (GND), U26.5 (SA0), U26.8 (GND_IO), U26.9 (GND), U27.2 (AVSSVCSEL), U27.3 (GND), U27.4 (GND), U27.6 (GND), U27.12 (GND), U28.3 (GND), U28.11 (GND), U28.15 (GND), U28.17 (PAD); also elsewhere on the board
I2S_BCLK: MK1.4 (SCK), U28.16 (BCLK); also elsewhere on the board
I2S_MIC: MK1.6 (SD); also elsewhere on the board
I2S_SPK: U28.1 (DIN); also elsewhere on the board
I2S_WS: MK1.1 (WS), U28.14 (LRCLK); also elsewhere on the board
IMU_SCL: TP8.1, U26.2 (SCL), U27.10 (SCL); also elsewhere on the board
IMU_SDA: TP9.1, U26.4 (SDA), U27.9 (SDA); also elsewhere on the board
TOF_INT: R89.2, U27.7 (GPIO1); also elsewhere on the board
TOF_XSHUT: R88.2, U27.5 (XSHUT); also elsewhere on the board
VSYS: C95.1, C96.1, TP6.1, U28.7 (VDD), U28.8 (VDD); also elsewhere on the board
WIFI_RXD: TP13.1; also elsewhere on the board
WIFI_TXD: TP12.1; also elsewhere on the board

Notes on the sheet:
Barometer - ST LPS22DF (LCSC C3253714), I2C address 0x5C (SA0 = GND), CS high = I2C. On the IMU bus (pull-ups R76/R77 on the imu sheet). INT_DRDY -> FPGA ball M17 (BARO_INT). C90 100 nF at VDD (pin 10), C91 100 nF at Vdd_IO (pin 1). Keep the vent hole clear; no conformal coat.
Distance sensor - ST VL53L1X (LCSC C190004), time-of-flight up to 4 m, I2C address 0x29 (default). On the IMU bus. XSHUT <- FPGA N16 (TOF_XSHUT, R88 10k pull-up = on), GPIO1 -> FPGA N17 (TOF_INT, R89 10k pull-up). C92 100 nF + C93 4.7 uF at AVDD/AVDDVCSEL (pins 11/1). Mount at a board edge looking 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
Microphone - TDK ICS-43434 (LCSC C5656610), I2S, bottom port: needs a ~0.8 mm hole through the PCB under the port and an opening in the case. L/R = GND -> left slot. Shares BCLK/WS with the amplifier (ESP32-S3 I2S0, full duplex). ESP32: I2S_BCLK GPIO35, I2S_WS GPIO36, I2S_SPK GPIO37 (out), I2S_MIC 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
Speaker amplifier - Maxim MAX98357A (LCSC C910544), I2S in, class-D BTL out to J8 (4-8 ohm speaker, no output filter needed for short leads). VDD = VSYS (3.0-4.2 V). GAIN_SLOT open = 9 dB. SD_MODE <- ESP32 GPIO47 (AMP_SD): high = on, left channel; R87 100k keeps the amp off while the ESP32 boots. C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
Test points TP1-TP13: 1.0 mm round SMD pads (not in BOM). Ground, rails, both I2C buses and the ESP32-FPGA UART. JTAG is on J4 (TC2030).

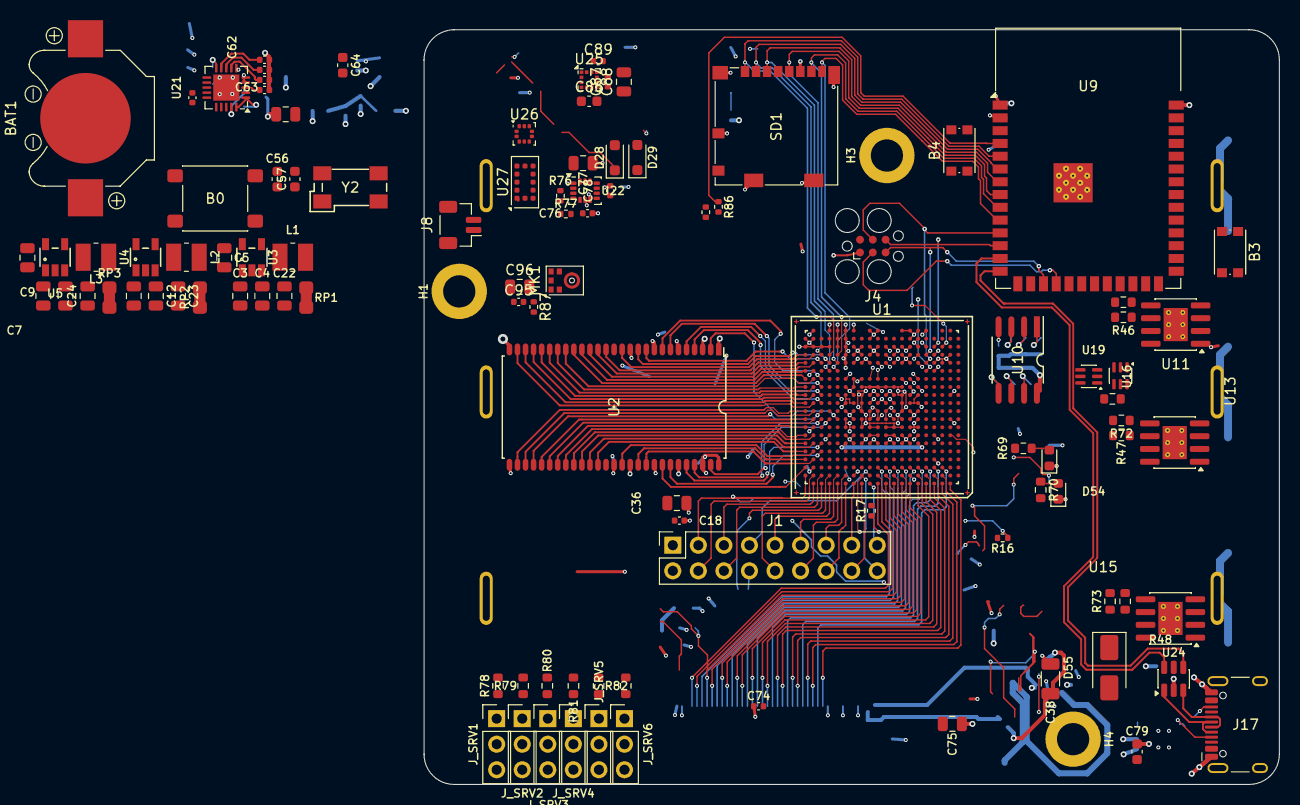
[picture p16: board FCL.kicad_pcb from above]

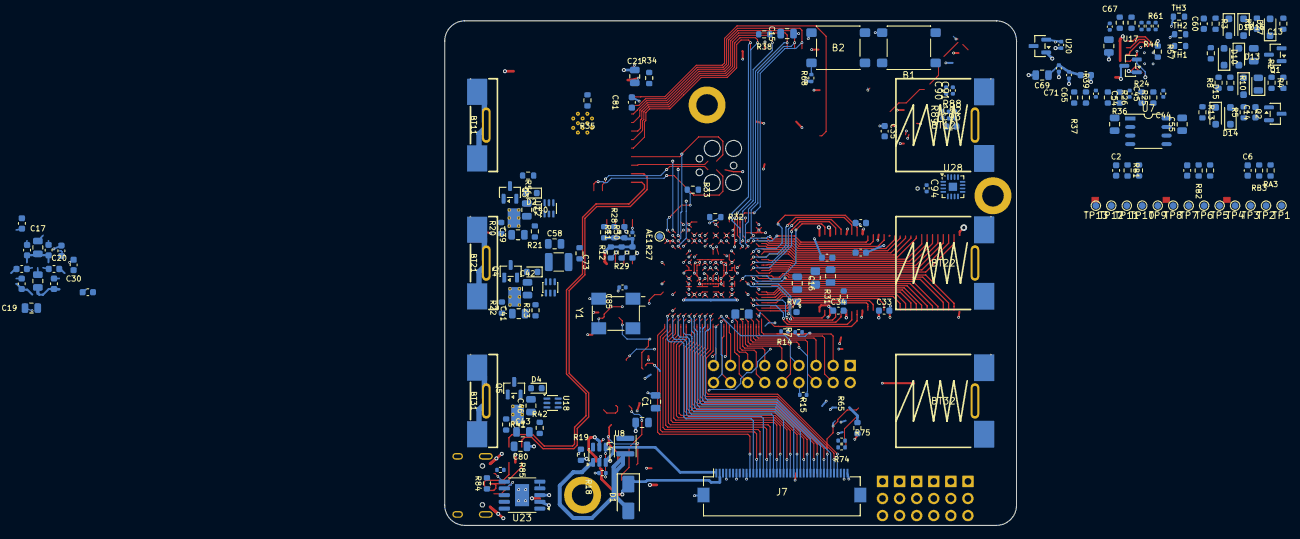
[picture p17: board FCL.kicad_pcb from below]

Board: 4 copper layers, 85.0 x 75.0 mm, 285 parts (179 on the bottom side), 239 nets.
