jharvey/FPGA_CAM-LCD/(commit log)

2026-10-29 Initial draft
    [analog.kicad_sch, analog.sch, blinkey.kicad_sch, blinkey.sch, flash.kicad_sch, gpdi.kicad_sch, gpdi.sch, gpio.kicad_sch]
2026-10-29 Rename ULX3S PCB to FPGA_CAM-LCD PCB
    Updated project name and removed outdated information.
2026-10-29 docs: README for monocular + AI collaboration guide
    Clarify project goal, kept sheets, and require commit messages
    with every change set. Note SD lives on wifi sheet.
    [1-click-bom.tsv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]
2026-10-29 initial draft start adding camera
    [Camera.kicad_sch, FCL.kicad_sch, power.kicad_sch]
2026-10-31 AI 1st attempt at add camera.
    [Camera.kicad_sch, FCL.kicad_sch, power.kicad_sch]
2026-10-31 returned gpio.kicad_sch
    [FCL.kicad_sch, usb.kicad_sch]
2026-11-01 Camera IO schematic layout cleanup.
    [Camera.kicad_sch, FCL.kicad_sch, usb.kicad_sch]
2026-11-01 renamed file and prepared for LCD integration step.
    [FCL.kicad_sch, LCD-Camera.kicad_sch]
2026-11-01 added LCD
    [LCD-Camera.kicad_sch]
2026-11-01 removed incorrect back-light driver.
    [LCD-Camera.kicad_sch]
2026-11-02 added camera and LCD connectors to schematic. Includes LCD back-light driver.
    [LCD-Camera.kicad_sch]
2026-11-03 add 18650 battery power Draft AI commit.
    [power.kicad_sch]
2026-11-03 Enhance roadmap with power input and battery management details
    Updated roadmap with additional details on power management and battery handling.
2026-11-04 added some notes to remember longer term.
    [power.kicad_sch]
2026-11-04 Cleaned up after AI drafted, more human readable now.
    [LCD-Camera.kicad_sch, power.kicad_sch]
2026-11-05 AI draft commit.
    [power.kicad_sch]
2026-11-07 power: replace ADS1115 with AD7689 8-ch 16-bit ADC + 2.5V reference
    - AD7689BCPZRL7 (C706705) on VADC/+3V3 (VIO), SPI on WIFI_GPIO19/21/22/26
    - REF3025 (C96625) 2.5V absolute reference on VREF_2V5, external-ref mode
    - IN0-2 cells, IN3 NTC (now excited from VREF_2V5), IN4 VSYS_SENSE
    (100k/68k); IN5-7/COM tied to GND
    - Cell dividers 47k/56k for 2.5V full scale; filter caps 100nF
    - Remove ADS1115 and I2C pull-ups
    [power.kicad_sch]
2026-11-07 made more human readable, added R57, R58, R59
    [power.kicad_sch]
2026-11-07 power: Phase 2 close-out – VBAT_OR bulk cap, wire cleanup, roadmap status
    - Add C73 100uF 10V X5R 1210 (CL32A107MPVNNNE, LCSC C23742) on VBAT_OR
    next to C58 for cell contact-bounce / hot-swap robustness
    - Trim 4 dangling wire overhangs past labels (PWREN x3, VBAT1);
    netlist otherwise unchanged
    - ROADMAP: record AD7689 8-ch ADC, internal 2.5 V absolute ref and VSYS
    rail sense as done; list open items (ADC REF loading by NTC pull-up,
    LM66100/TP4056 CE breakout, KiCad ERC pass, orphan ADC_* labels on
    ram sheet); move USB-C 5 V PD trigger to Phase 2b; mark Phase 1 done,
    Phase 3 in progress
    Schematic only, no PCB changes. No deletions on protected sheets.
    [power.kicad_sch]
2026-11-07 camera: connect CAM_D0..D5 to FPGA BANK1 (U1 unit 2)
    BANK1 unit was lost with the deleted gpdi sheet, leaving GP/GN22-24
    (CAM_D0..D5) with no FPGA pins. Place U1 unit 2 on LCD-Camera with
    ULX3S-compatible pins (B15/C15/B17/C17/C16/D16, matches ulx3s_v20.lpf)
    and NC flags on the 27 unused BANK1 pins. No other nets changed.
    Schematic only. Display side and power sheets untouched.
    [LCD-Camera.kicad_sch]
2026-11-07 display: add local VDD decoupling at Newhaven TFT FFC (J7)
    - Add C74 100nF 0402 (LCSC C1525) and C75 10uF 0805 (LCSC C15850)
    on +3V3/GND beside J7 pin 3 (LCD VDD); existing C18/C36 sit at the
    camera header J1, so the TFT had no local decoupling
    - Reviewed J7 pinout vs NHD-2.1-480480AF-ASXP datasheet: RGB666,
    sync, SPI, RESETX, IM[2:0]=001 (RGB + 8-bit SPI) all correct
    - Backlight boost U8 (AP3032) confirmed on VSYS; R19 2R0 -> 100mA
    No net renames; ERC unchanged (no new violations).
    [LCD-Camera.kicad_sch]
2026-11-07 schematic: mark RV2 and J2 as DNP
    - power: RV2 (+2V5 -> 2V5_3V3) set DNP; RV3 (+3V3 -> 2V5_3V3) stays
    fitted. Both 0R links were populated, shorting +2V5 to +3V3. The
    FPGA I/O banks driving the Newhaven TFT must stay at 3.3 V.
    - LCD-Camera: legacy ULX3S 2x20 header J2 set DNP (kept in schematic
    and layout). It shares every TFT RGB/sync/SPI net; final keep/drop
    decision deferred to layout (space vs. debug I/O value).
    ERC unchanged (233 before/after, no new violations).
    [LCD-Camera.kicad_sch, power.kicad_sch]
2026-11-07 schematic: split LCD-Camera into dedicated camera and display sheets
    - New display.kicad_sch: J7 NHD-2.1-480480AF-ASXP FFC, C74/C75 VDD
    decoupling, AP3032 backlight boost (U8, L4, D1, C37, C38, R18, R19)
    - New camera.kicad_sch: J1 OV7670 header, R7/R14-R17, C18/C36
    - LCD-Camera.kicad_sch renamed to fpga-io.kicad_sch; keeps U1 ECP5 bank
    units, legacy ULX3S headers J2 (DNP) / J6, D51/D52
    - Root sheet: rename block, add display (p5) and camera (p6) blocks;
    FCL.kicad_pro sheet list updated
    - Symbols/wires/labels moved verbatim (coordinates unchanged)
    - Docs: AI_GUIDE sheet list, ROADMAP Phase 3 sheet map
    Netlist verified identical (329 nets, 227 parts, same pin-to-net
    membership). Only sh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
    [FCL.kicad_sch, LCD-Camera.kicad_sch, camera.kicad_sch, display.kicad_sch, fpga-io.kicad_sch]
2026-11-07 docs: Phase 3 status, camera/display FPGA pin map, Phase 4 placement constraints
    - ROADMAP: Phase 3 marked schematic-done; list completed checks and the
    five open schematic decisions before layout (CAM_PCLK clock pin, J6 DNP,
    J5 VCCIO jumper DNP, monocular buttons/LEDs + orphan labels, +5V ERC)
    - ROADMAP: add "verify" list (AP3032 symbol/inductor, FFC contact side,
    LCD VDD at 3.3 V max, ESP32 shared SPI pins)
    - ROADMAP: add Phase 4 placement-constraints note (optical axis / PCB
    orientation, TFT FPC, camera-TFT alignment, bank-side placement,
    off-board 18650s via J8-J10, edge connectors, ESP32 antenna, mounting)
    - New doc/constraints/camera_display_pinmap.md: J7 + J1 pin -> net ->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
2026-11-07 schematic: CAM_PCLK to clock-capable pin, J6 and J5 DNP
    - camera: swap GP16/GP17 global labels on J1. CAM_PCLK now on
    L16 (GR_PCLK3_0); CAM_PWDN (with R17) moves to N16
    - fpga-io: legacy ULX3S 2x20 header J6 set DNP (kept for layout decision)
    - power: VCCIO select jumper J5 set DNP; banks 0/7 stay hard-set to 3.3 V
    by RV3 (a jumper on J5 1-2 would short +2V5 to +3V3)
    - docs: pin map and ROADMAP Phase 3 updated (2 items left before layout)
    Netlist: only GP16/GP17 membership changed. ERC unchanged (234).
    [camera.kicad_sch, fpga-io.kicad_sch, power.kicad_sch]
2026-11-07 schematic: monocular user I/O, prune orphan labels, +5V PWR_FLAG
    - fpga-io: add 2 buttons + 2 status LEDs (besides power button B0)
    - B1/B2 PTS645 (C285463), active-low on BTN1n (E8) / BTN2n (D8),
    10k pull-ups R67/R68 (C25744)
    - D53/D54 0603 red (C2286), active-high on LED0 (B2) / LED1 (C2)
    via 1k R69/R70 (C21190)
    - SW1/SW2 nets renamed BTN1n/BTN2n
    - fpga-io: remove orphan ULX3S labels SW3/4, LED2..7, AUDIO_* (20);
    no-connect flags on those U1 pins and on D9
    - fpga-io: D51/D52 5V header links DNP (follow J6)
    - power: #FLG02 PWR_FLAG on +5V at U16 VIN (fed only via D8/D9)
    - docs: ROADMAP Phase 3 closed; user I/O table in pin-map note
    ERC 234 -> 185; Phase 3 sheets show only i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
    [fpga-io.kicad_sch, power.kicad_sch]
2026-11-07 power: unload ADC reference, break out LM66100 ~CE pins
    - R43 NTC pull-up moved from AD7689 REF (VREF_2V5) to REF3025 OUT
    (VREF_SENSE). Internal 2.5 V conversion reference no longer carries
    DC load; cell/VSYS readings stay absolute. NTC ratio = IN3/IN4
    cancels both reference tolerances. No ADC config change.
    - U12/U14/U18 ~CE moved to local nets BAT1_CE..BAT3_CE, tied to VBAT_OR
    via 0R links R71-R73 (0603, C21189, fitted). Behaviour unchanged
    (ideal-diode OR); 0R pads are the rework point for future control.
    Note: ~CE is VIN-referenced (off > VIN+80 mV), so GPIO control will
    need a level shifter - left for the firmware/control phase.
    - ROADMAP: Phase 2 items closed with rationa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
    [power.kicad_sch]
2026-11-07 schematic: freeze for Phase 4 – fix floating GND balls, Y1 ground, RTC I2C
    Hygiene pass before mechanical work. Full ERC classified; three real
    defects inherited from the stripped ULX3S sheets fixed:
    - fpga-io: place U1 unit H (SERDES balls, lost with deleted serdes
    sheet). On LFE5U-85F these are GND per the CABGA381 pinout: 28 balls
    tied to GND, 8 HDTX (RESERVED) balls no-connect.
    - usb: Y1 FNETHE025 used a cached Crystal_GND24 symbol with pins 2/4
    stacked, tying the oscillator GND pad to +3V3. Replaced with
    Oscillator:ASE-xxxMHz (1 OE, 2 GND, 3 OUT, 4 VDD), same footprint.
    - fpga-io: RTC U7 I2C restored to ULX3S pins (FPDI_SDA -> B19,
    FPDI_SCL -> E12) with 4.7k pull-ups R74/R7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
    [fpga-io.kicad_sch, usb.kicad_sch]
2026-11-07 power: replace JST-PH cell connectors with PCB 18650 spring/button contacts
    - J8/J9/J10 (JST-PH placeholders) set DNP, kept until layout confirms
    - Add per-cell PCB contacts (MYOUNG, Keystone style):
    J11/J13/J15 MY-18650-04-J positive button (LCSC C19184125) -> CELL1..3_RAW
    J12/J14/J16 MY-18650-05-J negative spring (LCSC C19184124) -> GND
    - AO3401A reverse protection, TP4056 and LM66100 paths unchanged
    - Power-sheet note: plastic battery bay provides retention and cell
    length tolerance
    - Docs: ROADMAP decisions/Phase 2/Phase 4 (bay geometry, contact
    footprints), freeze note updated
    Footprints for J11-J16 still to be created in Phase 4 (LCSC lists
    both SMT and TH). Netlist: only CELL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
    [power.kicad_sch]
2026-11-07 power: finish 18650 contact swap - remove JST-PH, BT designators
    - Delete JST-PH placeholders J8/J9/J10 and their GND stubs; CELLx_RAW
    wires end at the AO3401A drain labels
    - Rename PCB cell contacts for clarity (BTn1 = +, BTn2 = -):
    BT11/BT21/BT31 MY-18650-04-J positive button (LCSC C19184125) -> CELL1..3_RAW
    BT12/BT22/BT32 MY-18650-05-J negative spring (LCSC C19184124) -> GND
    - Power-sheet note: contacts are for a plastic battery bay that provides
    mechanical retention and cell-length tolerance
    - ROADMAP / freeze note: per-cell contact table with LCSC numbers
    AO3401A, TP4056 and LM66100 paths unchanged. ERC unchanged (179).
    Contact footprints still to be created in Phase 4.
    Co-Aut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
    [power.kicad_sch]
2026-11-07 imu: add ICM-42688-P 6-axis IMU on dedicated I2C to FPGA
    - New sheet imu.kicad_sch (page 7): U22 TDK InvenSense ICM-42688-P
    (LCSC C1850418, LGA-14 2.5x3, JLCPCB extended)
    - Symbol in new project library symbols/fcl_local.kicad_sym (added to
    sym-lib-table); footprint Package_LGA:LGA-14_3x2.5mm_P0.5mm_LayoutBorder3x4y
    - VDD/VDDIO from +3V3; decoupling per DS-000347 Table 10:
    C76 100nF (C1525) + C77 2.2uF (C87995) on VDD, C78 10nF (C15195) on VDDIO
    - I2C mode (AP_CS = VDDIO), address 0x68 (AP_AD0 = GND),
    4.7k pull-ups R76/R77 (C25900); RESV pin 7 to GND, 2/3/10/11 NC
    - fpga-io: IMU_SCL -> E7, IMU_SDA -> D7, IMU_INT1 -> C1, IMU_INT2 -> D1
    (balls freed in Phase 3; INT2 doubles as FSYNC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
    [FCL.kicad_sch, fpga-io.kicad_sch, imu.kicad_sch]
2026-11-07 servo: add 6x RC servo headers (DNP) with SERVO_V net
    - New sheet servo.kicad_sch (page 8): J_SRV1-J_SRV6 1x3 2.54 mm headers,
    all DNP for the first prototype
    - Pinout: 1 Signal (1-2 ms pulse), 2 SERVO_V, 3 GND
    - Signals SRV_PWM1-6 from FPGA bank 6 (P1, P2, P3, P4, N2, J4) via 1k
    series resistors R78-R83 (0603, C21190, DNP with the headers)
    - usb: repurpose orphan ULX3S OLED_* labels on those balls as SRV_PWM1-6
    - SERVO_V brought out only; source (VSYS jumper vs dedicated regulator)
    left open, noted on sheet and in ROADMAP
    - Docs: ROADMAP Phase 3c, pin map, AI_GUIDE sheet list, freeze note
    ERC 179 -> 167 (12 orphan OLED items removed, no new items).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
    [FCL.kicad_sch, servo.kicad_sch, usb.kicad_sch]
2026-11-07 power: add 5 V-only USB-C PD charge port (CH224K)
    - New sheet usbc_pd.kicad_sch (page 9): power-only USB-C charge port
    (board had only micro-B US1/US2, which are unchanged)
    J17 GCT USB4125-GF-A 6P (C3151650)
    U23 WCH CH224K PD sink (C970725), symbol in symbols/fcl_local.kicad_sym
    - 5 V only: CFG1 (pin 9) tied to VDD (level mode = 5 V request),
    CFG2/CFG3 to GND, no CFG1 resistor (would select 9-20 V)
    - PD-only mode: DP shorted to DM on CH224K; CC1/CC2 direct (internal Rd);
    VDD via R84 1k + C79 1uF, VBUS sense R85 10k, VBUS bulk C80 10uF;
    #FLG03 on PD_VDD
    - VBUS_C -> D55 SS34 (C8678) -> +5V, parallel to D8/D9; TP4056 charging
    path unchanged
    - Docs: ROADMAP Phase 2b done (higher-vo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
    [FCL.kicad_sch, usbc_pd.kicad_sch]
2026-11-07 usb: single USB-C for power, SD mass storage and programming (ESP32-S3)
    Architecture decision: the classic ESP32-WROOM-32 has no native USB, so
    U9 becomes an ESP32-S3-WROOM-1-N8R2 (C2913204) and is the only USB
    device on one USB-C port. Rejected: hub + FT231X + USB card-reader IC
    (more parts, SD bus would need a mux between reader, ESP32 and FPGA).
    - usbc_pd: J17 now USB 2.0 USB-C HC-TYPE-C-16P-01A (C2894897); CC1/CC2
    stay on the CH224K (5 V only, PD-only mode, DP/DM shorted on chip);
    D+/D- -> U24 USBLC6-2SC6 (C7519) -> USB_DP/USB_DN; VBUS -> D55 -> +5V
    unchanged (TP4056 path untouched, no higher-voltage path)
    - wifi: ESP32-S3 replaces ESP32 (USB on GPIO19/20; SD 4-bit on the same
    G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
    [FCL.kicad_sch, fpga-io.kicad_sch, power.kicad_sch, usb.kicad_sch, usbc_pd.kicad_sch, wifi.kicad_sch]
2026-11-07 schematic: fix KiCad 10 load warning in generated sheets
    - imu, servo, usbc_pd: drop sheet-level (embedded_fonts no) (root-only in
    KiCad 10; the editor auto-removed it and showed the "automatically
    fixed" load warning); files re-saved in KiCad's own format
    - symbols/fcl_local.kicad_sym: re-saved in KiCad 10 format (adds default
    pin/field attributes to ICM-42688-P and CH224K)
    - fpga-io: new file UUID (it shared power.kicad_sch's UUID since the
    initial draft)
    - root: unique page numbers (servo 10, usbc_pd 12; were 8/9 like ram/wifi)
    Netlist identical, ERC unchanged (167). kicad-cli sch upgrade now leaves
    every sub-sheet unchanged.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
    [FCL.kicad_sch, fpga-io.kicad_sch, imu.kicad_sch, servo.kicad_sch, usbc_pd.kicad_sch]
2026-11-07 docs: lock Phase 4 mechanical decisions (axis, 85x75 outline, zones)
    - Optical axis perpendicular to the PCB through the board centre
    (42.5, 37.5): OV7670 flat on the front, 3x18650 bay + round TFT on the
    back; lens and TFT coaxial (per Pic_LCD_ISO / Pic_Cam_ISO)
    - Outline 85 x 75 mm, R3, 1.6 mm, 4 layers; M3 holes at the corners;
    fresh PCB (ULX3S layout not reused); fit check for cells and depth
    - Zones: cells at y 18/37.5/57, springs left (x~6), buttons right
    (x~79); power stage right, FPGA/SDRAM left, IMU on the axis under the
    camera, ESP32-S3 top-right with antenna at the top edge, J7 bottom-centre
    on the back
    - Edges: bottom = USB-C, microSD, J7, servo block; top = buttons,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
2026-11-07 pcb: 85x75 mm outline and mechanical placement of major parts (Phase 4)
    - Fresh FCL.kicad_pcb (ULX3S placement/routing/nets removed; 4-layer
    stack-up and rules kept): 85.0 x 75.0 mm, R3 corners, origin at top-left
    - Placed (not routed), linked to schematic symbols by path:
    U22 IMU on the optical axis (42.5, 37.5); J1 camera socket under the
    axis; U1 ECP5 (17, 28) rot -90; U9 ESP32-S3 top-right, antenna at edge;
    J7 FFC back/bottom-centre; J17 USB-C and SD1 microSD on the bottom edge;
    B0-B2 top edge; J4 JTAG (DNP); TH1 between cell rows; 18650 springs
    BT12/22/32 at x 5.5 and buttons BT11/21/31 at x 79.5 (rows y 18/37.5/57);
    M3 holes H1/H3/H4
    - Reference drawings: optical axis, ca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
    [FCL.kicad_pcb, FCL.kicad_sch, fpga-io.kicad_sch, power.kicad_sch, usb.kicad_sch, wifi.kicad_sch]
2026-11-07 pcb: refine battery bay, NTC and IMU placement (Phase 4.4)
    - 18650 contact rows widened to 20.5 mm pitch (y 17 / 37.5 / 58,
    symmetric about the optical axis) for 1.6 mm bay ribs; springs
    BT12/22/32 at x 5.5, buttons BT11/21/31 at x 79.5, all facing the
    cells; usable cell length ~65.0-67.5 mm (protected cells don't fit)
    - Battery-bay rule areas on B (no footprints): BAY_END_WALL_L/R behind
    the contacts, BAY_RIB_1/2 between cells, CASE_BOSS_TR at the antenna
    corner (replaces H2); bay outline, rib lines and notes on B.Fab /
    Dwgs.User (2.5 mm cradle -> B-side parts under cells <= 1.5 mm)
    - TH1 NTC moved under the middle cell (36, 37.5) for a 2 mm thermal pad
    - IMU U22 kept at the boa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
    [FCL.kicad_pcb]
2026-11-07 schematic: renumber duplicate power symbols on camera sheet
    #PWR01-#PWR04 existed on both the root and camera sheets (inherited
    from the old LCD-Camera sheet), which blocked Update PCB from Schematic.
    Camera-sheet copies renamed to #PWR0175-#PWR0178. Netlist unchanged.
    [FCL.kicad_pcb, camera.kicad_sch]
2026-11-07 pcb: import netlist and rough-place all parts by function (Phase 4.5)
    - Update PCB from Schematic done (246 footprints, none outside the outline)
    - Exclude from board (no room on 85x75 / obsolete): FT231X U6, micro-B
    US1/US2 and their DNP parts (D8, D9, D20, D21, D23-D26, R9, R40,
    R49, R50, R52-R54, R63, R64), D51/D52, J5, J3 (pins would enter the
    battery bay); J4 kept as the JTAG fallback
    - RP1-RP3 NC solder jumpers -> fcl_local:R_0805_Jumper_NC_NetTie
    (copper bridge declared as net tie pads 1-2)
    - Rough functional placement into the locked zones: flash/clock and
    regulators above U1, SDRAM below U1, RTC/logic around the IMU,
    chargers + ideal diodes on the right, ADC on the back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
    [FCL.kicad_pcb, fpga-io.kicad_sch, power.kicad_sch, usb.kicad_sch, wifi.kicad_sch]
2026-11-08 JH placed the USB, SD, and push buttons.
    [FCL.kicad_pcb]
2026-11-08 pcb: reset placement, keep only fixed and edge parts on the board (Phase 4.6)
    - Move all footprints except the fixed/edge set off the board into a
    staging field below the outline (grouped by sheet, front, 0 deg,
    servo headers last); nets and schematic links kept, no re-import
    - Kept at their 4.5 X/Y/rotation: SD1, J17 (USB-C), B0/B1/B2, J7
    (display FFC), J1 (camera), BT11-BT32 (18650 contacts, pitch
    20.5 mm), H1/H3/H4; all locked except B0-B2 (rotation allowed)
    - J17 nudged 0.15 mm up to clear the corner radius (edge clearance)
    - CASE_BOSS_TR trimmed to y 3.5-8.3 so BT11's tab no longer intrudes
    - ROADMAP 4.6: kept parts and re-placement order
    DRC: no keep-out, edge, courtyard or sh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
    [FCL.kicad_pcb]
2026-11-08 pcb: place the digital core by ratsnest length (Phase 4.7)
    - U2 SDRAM (17, 12.5) 0 deg, top-left above the FPGA
    - U1 ECP5 (22, 34) 180 deg, left strip, 11 mm from the IMU spot
    - U10 config flash (29, 20) 180 deg, between SDRAM and FPGA
    - Y1 25 MHz oscillator (25, 48) next to the FPGA clock input
    - J4 JTAG fallback (37, 23) 90 deg; U9 ESP32-S3 (66, 12.75), antenna
    flush with the top edge
    - Positions/rotations chosen by minimum ratsnest (MST) length with
    >= 1 mm routing channels; SDRAM above U1 beat below by ~12 %
    - SD1, J17, B0-B2 and all other fixed parts untouched
    - ROADMAP 4.7: positions and remaining long nets (SD bus 73-90 mm,
    ESP32<->FPGA 30-59 mm)
    DRC: no courtyard, keep-out, ed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
    [FCL.kicad_pcb]
2026-11-08 pcb: place analog, power-management and battery NTCs on the far side (Phase 4.8)
    - Far side = right half of the front + the back, opposite the digital
    strip; parts placed by minimum ratsnest with IMU (>= 15 mm from
    switchers/chargers), under-cell height (<= 1.5 mm on B) and bay
    rule-area constraints
    - Reverse FETs Q3-Q5 on B next to each + button; TP4056 U11/U13/U15
    on F right strip, >= 3 mm apart for heat; LM66100 power path, C73
    - USB-C input: U24 + D55 on F at J17, CH224K U23 on B under J17
    - TLV62569 U3-U5 + L1-L3 on B under cell 1 with their caps, feedback
    and RP1-RP3
    - AD7689 U21, REF3025 U17, LDO U20 on B under cell 3 with dividers,
    filters and NTC pull-ups
    - Backlight boo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
    [FCL.kicad_pcb]
2026-11-08 pcb: place decoupling and local bulk caps at their power pins (Phase 4.9)
    - Each cap placed against the pin it serves (both sides, 4 rotations,
    nearest unserved pin of its net + short GND), no IC or locked part
    moved
    - U1: 22 nF + 2.2 uF per rail (+1V1, +2V5, VCCIO 2V5_3V3, +3V3) on
    the back inside the ball field, RV2/RV3 beside them
    - U2: C33 back, C34/C35/C16/C52 front around the TSOP
    - Re-targeted to the real pins: TP4056 VCC/BAT caps, J7 +3V3 caps
    C74/C75, CH224K VDD cap C79
    - ESP32 C21, camera C18/C36, SD supply R38/C15
    - schematic: add C84 (U10 flash) and C85 (Y1 oscillator), 100 nF
    0402 LCSC C1525 - neither had a local cap; PCB footprints added
    with schematic links
    - ROADM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
    [FCL.kicad_pcb, flash.kicad_sch, usb.kicad_sch]
2026-11-08 pcb: place all remaining parts and the servo headers (Phase 4.10)
    - TH1-TH3 moved to the middle of each cell on B (x 47.6, cell axes),
    for a thermal pad to the can mid-length
    - Status LEDs D53/D54 + R69/R70 on the front top edge
    - RTC: BAT1 CR1225 holder front top-centre, U7 + Y2 under the camera
    module (low parts), caps and I2C pull-ups beside
    - Flash/config, camera, ESP32 strapping, SD_CD and button pull-ups at
    their ICs; AE1 at U1
    - ESP32 BOOT/RESET B3/B4 on the front left, outside the camera module
    - Servo headers J_SRV1-6 (DNP) as one ganged 3x6 block at 2.54 mm
    pitch bottom-left (only spot with both sides free), R78-R83 beside
    - ROADMAP 4.10; status: placement complete
    DRC: no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
    [FCL.kicad_pcb]
2026-11-08 pcb: JLCPCB rules, planes, BGA fan-out and decoupling (routing step 1)
    - Net classes PWR_HIGH 1.0 / PWR_CELL 0.8 / PWR_SW 0.6 / USB 0.2+0.15
    pair / ANALOG 0.2 / PWR_RAIL 0.4 / FAST 0.15 / Default 0.15 mm, with
    net patterns; default clearance 0.15 mm
    - FCL.kicad_dru: 0.10/0.10 mm only inside rule area U1_BGA and on the
    pads of 0.5 mm-pitch parts; mask 0.05 mm expansion / 0.1 mm web
    (U22 mask margin 0), hole-to-hole 0.5 mm
    - Stackup JLC04161H-7628, HASL lead-free
    - Zones: GND on L2 (solid); L3 +3V3 main plane, +1V1 island under the
    core balls, VSYS band over the power-path block. +2V5 / VCCIO stay
    tracks (an island would isolate +3V3 balls)
    - U1 dogbone fan-out with 0.4/0.2 vias (p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
    [FCL.kicad_pcb]
2026-11-08 pcb: widen existing power stubs to their net-class width
    - 38 tracks on power nets raised to the class width (capped at the
    landing pad, stepped down only where clearance required):
    VBAT1-3 -> 0.6-0.8 mm, +5V/VBAT_OR/VSYS -> 0.6-1.0 mm, VBUS_C 0.54,
    +3V3/SD3V3 -> 0.4 mm; BGA escape stubs stay 0.2 mm
    - FCL.kicad_pro had been overwritten by the open KiCad session (net
    classes, patterns and pre-defined sizes lost); restored to the
    committed version (no change vs HEAD)
    - ROADMAP 4.11: widths + "edit rules with KiCad closed" note
    DRC: no new violations (91 via_dangling = U1 signal fan-out, silk and
    servo-gang items as before). Parity 5 SD1 pins.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
    [FCL.kicad_pcb]
2026-11-08 pcb: routing step 2 - high-speed nets (partial)
    - Scripted grid maze router (no autorouter): USB J17->U24->ESP32,
    25 MHz clock, part of the SDRAM and camera/LCD buses routed with
    net-class widths, BGA 0.1 mm escape, rip-up/re-route; In2 used for a
    few bus segments, +3V3 plane still one island
    - FCL.kicad_dru: add explicit mm units - KiCad 10 silently ignored the
    unitless rules, so the BGA / fine-pitch exceptions were not applied
    - B4 (ESP32 RESET) moved to (7, 44.5) to open the corridor left of U1
    - C34/C35/C16 moved to the back under U2 and reconnected (they walled
    in U2's left pin row)
    - DRC-pruned: no clearance, hole or short violations
    - Still open: 59 nets (most of the SDRAM b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
    [FCL.kicad_pcb]
2026-11-08 pcb: routing step 3 - power paths and plane stubs
    - Power nets routed at net-class width (PWR_HIGH 1.0 / PWR_CELL 0.8 /
    PWR_SW 0.6 / PWR_RAIL 0.4 mm) with 0.6/0.3 vias: VBUS_C, +5V, cell
    paths, VBAT_OR, VSYS, regulator SW/outputs, LCD backlight, RTC
    - Every plane-net pad not yet on its plane (GND, +3V3, +1V1, VSYS)
    got a short stub + via
    - DRC-pruned; GND/+3V3/+1V1/VSYS planes each still one island
    - Unconnected 447 -> 282; still open: +2V5/VCCIO and some GND/+3V3
    balls under U1 (no via site), VBUS_C x4, +5V x2 (ROADMAP 4.13)
    [FCL.kicad_pcb]
2026-11-08 pcb: routing step 4 - analog and sensing (partial)
    - RTC crystal, regulator feedback, ADC reference/supply, part of the
    sense dividers / NTC lines and I2C routed at ANALOG class
    (0.2 mm / 0.2 mm), DRC-pruned, planes intact
    - Still open: long sense/NTC runs, VREF_SENSE, VADC x3, FB1/FB2,
    IMU and RTC I2C (ROADMAP 4.14)
    [FCL.kicad_pcb]
2026-11-08 pcb: routing step 5 - low-speed nets and FPGA test vias (partial)
    - Second pass over all remaining nets with rip-up: buttons, LEDs,
    flash/config, JTAG, strapping, power-on logic, servo PWM, CC lines
    and retries; DRC-pruned, planes intact
    - Unconnected items 492 (pre-routing) -> 197; 134 nets still open,
    dominated by the SDRAM / SD / camera buses and the long sense lines
    - 4 untented test vias on unused FPGA balls (no room for the other 54)
    - ROADMAP 4.15: assessment - placement (U1 orientation, SDRAM above)
    saturates the left half; recommended fix described
    [FCL.kicad_pcb]
2026-11-08 pcb: silkscreen pass - refdes sizes and placement (step 6)
    - Refdes 0.8 mm (1.0 mm on large parts), 0.15 mm stroke, placed next
    to each part clear of pads, exposed vias, other refdes and the edge;
    values hidden
    - 207 refdes on silk (95 F, 112 B); 45 dense-area parts keep the
    refdes on Fab only (listed in ROADMAP 4.16)
    - Silk DRC: overlap 199 -> 81, over-copper 143 -> 12, edge 7 -> 2
    [FCL.kicad_pcb]
2026-11-08 pcb: rip up signal interconnects on U2, U10, J1, J7, SD1, U24, J_SRV1-6
    - Removed all routed copper (784 tracks, 152 vias) of the 105 signal
    nets that touch U2, U10, J1, J7, SD1, U24 and J_SRV1-6: SDRAM bus,
    config flash SPI, camera/LCD GP/GN + XCLK, SD bus + SD_CD, USB D+/D-
    both sides of U24, servo header signals
    - Kept: U1 dogbone fan-out, decoupling stubs/vias, power routing
    (incl. SERVO_V), analog and the other low-speed routes
    - Dangling route copper cleaned; DRC: only the 91 U1 signal dogbone
    vias are dangling (awaiting routes), no clearance/short items.
    Unconnected 197 -> 251
    [FCL.kicad_pcb]
2026-11-08 removed a bunch of failed traces, starting to re-route.
    [FCL.kicad_pcb]
2026-11-08 flipped USB traces.
    [FCL.kicad_pcb, flash.kicad_sch, usb.kicad_sch, usbc_pd.kicad_sch]
2026-11-08 pcb: remove floating GND stitching vias (zones left unfilled)
    - Removed the GND vias that only hung off a short stub (decoupling /
    IC ground returns and step-3 plane stubs) plus their stubs, so they
    are no longer obstacles while re-routing; to be re-added once the
    pours are back
    - Kept: U1 GND dogbones (restored after a first pass caught them),
    thermal vias inside exposed pads (U21, U23, Y1, J7), all +3V3 /
    +1V1 / VSYS vias
    - Copper zones left unfilled
    - Checked the U24 USB swap from ccde8c36: both pass-through pairs
    swapped (1/6 = USB_C_DN/USB_DN, 3/4 = USB_C_DP/USB_DP), schematic
    parity clean, ERC unchanged (153)
    [FCL.kicad_pcb]
2026-11-08 pcb: restore GND vias that carry a stub segment
    - Put back the 197 GND vias and 245 stub segments removed in f2b3b432
    (decoupling / IC ground returns and plane stubs) - copper identical
    to ccde8c36 again
    - Checked for vias with no segment attached: none outside pads; the
    only ones are 19 thermal vias inside exposed pads (U21, U23, Y1,
    J7), left in place
    - Zones still unfilled
    [FCL.kicad_pcb]
2026-11-08 pcb: stage the ULX3S FPGA/SDRAM core off-board, match reference stackup
    - U1, U2, C16/C17/C19/C20/C25-C34, D28/D29, R31-R33 moved above-left
    of the outline in the ULX3S orientation (U1 0 deg, U2 90 deg,
    +26.6 mm); refdes and nets already identical to the reference
    - Copied from the reference (7a6d82ec): SDRAM routing, BGA fan-out /
    escapes, decoupling connections, +1V1 / +2V5 / 2V5_3V3 islands;
    only on nets that exist here and land on matching pads
    - Stackup now matches the reference: In1 = +3V3 + power islands,
    In2 = GND (all inner tracks and zones swapped), zones unfilled
    - Removed our old U1/U2 dogbones, decoupling stubs, 1V1 island;
    U1_BGA moved; ULX3S_CORE rule area + 5-mil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
    [FCL.kicad_pcb]
2026-11-08 pcb: stage the ULX3S 1V1 and 3V3 regulator blocks beside the core
    - U3/L1/C2-C5/C22/RA1/RB1/RP1 and U5/L3/C6-C9/C24/RA3/RB3/RP3 moved
    to their reference positions next to the staged FPGA/SDRAM core
    - Reference copper copied (68 B.Cu tracks), +5V mapped to VSYS (the
    only net difference); our old copper on these parts removed
    - RP1/RP3 keep the net-tie footprint (3 mask-bridge items to tidy)
    - ULX3S_CORE rule area extended; zones unfilled
    [FCL.kicad_pcb]
2026-11-08 pcb: step 1 - place the ULX3S core on the board (90 deg CW, left strip)
    - Core block (U1, U2, decoupling, config parts, copied SDRAM routing,
    fan-out, power islands, rule areas) rotated 90 deg CW as one unit:
    U1 at board (28, 11.2), U2 below at (28, 37.8); SDRAM faces U2,
    camera/LCD bank faces J1, ESP32/SD banks face up
    - 1V1 (U3) and 3V3 (U5) regulator blocks placed on B by search clear
    of bay ribs/springs and >= 15 mm from the IMU: (41, 15) and (45, 61)
    - B0-B2 untouched; R32/R33/C30 (button clash) and C16/D28/D29 (ribs)
    parked instead
    - Displaced parts parked off-board for step 2 (list in ROADMAP 4.18)
    - Our copper in the new areas and conflicting copied stubs removed;
    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
    [FCL.kicad_pcb]
2026-11-08 pcb: step 1 redone - core rotated 180 deg from reference (owner mock-up)
    - U1 at (45.5, 17) rot 180, U2 at (18.9, 17) rot -90, 26.6 mm left:
    reference geometry turned 180 deg, copied SDRAM routing intact
    - Camera/LCD bank faces J1 (directly below), ESP32/SD banks face the
    ESP32; backwards routes 37 -> 23
    - Raised to y 17 so the BGA clears bay rib 1 and the IMU stays on the
    optical axis; B0-B2 untouched
    - 1V1 block (U3) at (59, 43), 3V3 block (U5) at (45, 61) on B
    - ULX3S_CORE rule area split into three tight areas
    - Displaced parts parked off-board for step 2 (ROADMAP 4.19)
    - DRC: no clearance/short/hole/edge/keep-out items; zones unfilled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
    [FCL.kicad_pcb]
2026-11-08 pcb: step 1 final - lower the core between the bay ribs, full SDRAM copy
    - U1 (45.5, 37.5) rot 180, U2 (18.9, 37.5) rot -90: moved down about
    one FPGA width to free the ESP32's left pins and the board top; BGA
    sits between bay ribs 1 and 2, camera bank right above J1
    - IMU group parked (to go above U1, owner OK); regulators on B: 1V1
    (U3) at (26, 20), 3V3 (U5) at (45, 61)
    - SDRAM routing re-copied in full from the reference with the exact
    180 deg transform: all SDRAM nets connected
    - Orphaned copied copper removed, ULX3S_CORE rule areas re-split
    - DRC: no clearance/short/hole/edge/keep-out items; zones unfilled
    [FCL.kicad_pcb]
2026-11-08 pcb: owner moved the servo headers to the top (placement WIP)
    [FCL.kicad_pcb]
2026-11-08 remap camera and LCD FPGA I/O for straight, non-crossing routing
    - LCD (27 signals): outer rows of U1's bottom-right corner in J7 pin
    order - removes the mirrored crossover (J7 is on the back)
    - Camera (16 signals): U1's bottom-left outer rows in J1 column order;
    camera PCLK on the dedicated clock input PCLKT1_0 (B12)
    - Same 3.3 V banks; servo balls unchanged (servos placed last)
    - Schematic: global labels moved on the U1 pins (fpga-io, ram);
    netlist verified, ERC unchanged (153)
    - PCB: U1 pad nets updated in place (61 pads), stale stubs/vias on
    remapped balls removed; schematic parity clean (no re-import needed)
    - FPGA: fpga/CameraToTFTSobel_FCL.ice, fpga/main_FCL.lpf and the pin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
    [FCL.kicad_pcb, fpga-io.kicad_sch, ram.kicad_sch]
2026-11-08 pcb: owner placement - SD1/C15/R86 to the top, servos to the bottom-left, J4, H3, B2 moved
    [FCL.kicad_pcb]
2026-11-08 remap camera onto U1's outer ball rows; keep J1 through-hole
    - Decision: J1 stays through-hole (socketed, tall, often unplugged
    module); the LCD ribbon passes J1 on B, two traces per pin gap
    - Camera: all 16 signals on U1's outer two rows (A/B) in J1 column
    order so every camera trace routes on F without vias; PCLK stays on
    PCLKT1_0 (B12) with one via; FPDI_SDA moved B19 -> C15
    - Schematic + PCB pad nets updated, netlist verified, ERC 153, parity
    clean; fpga/ .ice, .lpf and IO_REMAP.md regenerated
    - ROADMAP 4.22 (includes open DRC items from the owner's WIP moves)
    [FCL.kicad_pcb, fpga-io.kicad_sch]
2026-11-08 remap ESP32/FPGA/SD/ADC pins to face each other; step 1 clean-up for owner placement
    - ESP32-S3 pads: SD on the left column (pads 4-10) facing SD1, JTAG on
    11/12/17/18 facing J4, FPGA UART + spare links on bottom pads 19-23
    facing U1, ADC SPI on 24/25/28/29; strapping pins, GPIO37-42 and UART0 NC
    - moved nets renamed to their new GPIO numbers (WIFI_GPIO40->13, 41->14,
    1->21, 9->47, 21->48, 8->35, 6->36)
    - U1 right-edge balls re-ordered to match (links L1/L2/K1/K2/J1, SD
    N4..G3, ADC F4/F3/E4/E3); FPGA design unaffected (no lpf change)
    - SD1 4 mm left out of the antenna keep-out, R86 follows, C15 to the back
    under SD1, B2 off the BT12 spring, C35 below B2, stale SERVO_V via removed
    -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
    [FCL.kicad_pcb, fpga-io.kicad_sch, power.kicad_sch, usb.kicad_sch, wifi.kicad_sch]
2026-11-08 J4 (JTAG fallback) to SMT 2x3 2.54 mm socket
    Same pitch and pin numbering as the through-hole socket, centred on the
    old position, rotated 180 deg; DNP kept. Frees the back side under J4.
    ERC 153, parity only the known SD1 pins, no new DRC items.
    [FCL.kicad_pcb, usb.kicad_sch]
2026-11-08 J4 (JTAG backup) to Tag-Connect TC2030 pad footprint
    TC2030-IDC-FP (legged, self-retaining) at the old J4 centre; no part to
    fit, ESP32-S3 remains the JTAG programmer. Pin numbering unchanged, so a
    TC2030-IDC cable maps 1:1 to a 2x3 2.54 mm IDC plug. ERC 153, parity only
    the known SD1 pins, no new DRC items.
    [FCL.kicad_pcb, usb.kicad_sch]
2026-11-08 route highways before step 2: USB pair, camera ribbon, SD1 to ESP32
    - USB_DP/USB_DN: side-by-side F.Cu pair, no vias, ESP32 pads 13/14 to U24
    (~51 mm); C58 GND via moved; strip right of U1 kept for osc/flash
    - camera: 14 signals fanned out on F.Cu in J1 column order without
    crossings; PCLK one dogbone via + B.Cu to J1.7; XCLK stub+via for R15;
    pull-ups R14/R16/R17 connected
    - SD1 to ESP32: vias above SD1 pads, B.Cu under the connector, F ribbon
    into pads 4-9; card detect via R86 to pad 10. ESP32 SD pads and FPGA SD
    balls re-ordered to match; JTAG TDO/TMS swapped to pads 11/12
    - J4 (Tag-Connect) moved to (44.5, 21.5); C15 to B under SD1; R86 to F
    - not routed yet: SD branch to U1, J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
    [FCL.kicad_pcb, fpga-io.kicad_sch, usb.kicad_sch, wifi.kicad_sch]
2026-11-08 slide J1 left, park U5 block, redo camera ribbon; keep owner's B0-B2/H1 moves
    - J1 moved 5.08 mm left (not rotated: the flat camera module would rotate
    the image); frees a B.Cu lane right of J1 for the LCD ribbon
    - U5 3V3 regulator block (U5, L3, C6-C9, C24, RA3, RB3, RP3 + copper +
    rule area) parked exactly +120 mm in x, to come back after camera/LCD
    - R78-R83, C18, C36, R14, R17 parked for step 2; stale vias removed
    - camera ribbon regenerated: F.Cu, J1 column order, no crossings; XCLK own
    lane + R15 on B below J1; PCLK dogbone + B.Cu into J1.7
    - owner's B0, B1, B2, H1 moves kept (B0 pad near edge arc flagged)
    [FCL.kicad_pcb]
2026-11-08 park R19 and TH3 until the LCD ribbon is routed
    [FCL.kicad_pcb]
2026-11-08 J1 to -7.62 mm with re-planned camera ribbon; SD1 to ESP32 on F without vias
    - J1 2.54 mm further left (B.Cu lane x 46-54 for the LCD ribbon), C85 parked
    - camera ribbon from the level planner: 11 levels at 0.3 mm, no crossings
    - SD bus: no signal vias, hugs SD1's right edge ~1.5 mm into the antenna
    band (board copy of the U9 keep-out trimmed to x 43.6); ESP32 SD pads
    re-ordered CD, D2, D3, CMD, CLK, D0, D1 on pads 4-10
    - ERC 153, parity only the known SD1 pins, no clearance/short errors
    [FCL.kicad_pcb, wifi.kicad_sch]
2026-11-08 route J4 (Tag-Connect JTAG) by hand to the ESP32 and U1
    TDO/TMS on F through J4's right gap into ESP32 pads 11/12 with one via
    each to B lanes into U1; TCK on B (U1 branch + under the USB pair to pad
    17); TDI on F with a via into U1 and B under USB to pad 18; J4 3V3/GND to
    plane vias. Removed a stale JTAG_TMS stub on In2. All JTAG nets connected,
    no new DRC items.
    [FCL.kicad_pcb]
2026-11-08 LCD prep: park the front parts between J1 and J7, remove floating segments
    D16, D17, D27, Q2, R3, R5, R6, R8, C38, C60, D11 parked for step 2; stale
    GND/VSYS/LCD_BL_A/SERVO_V stubs around J1/J7 removed. Next: RESET/PWDN to
    B, park C19, hand-route the LCD ribbon (see ROADMAP 4.28).
    [FCL.kicad_pcb]
2026-11-08 hand-route the LCD ribbon to J7; camera RESET/PWDN to the back layer
    - LCD rows A/B: F.Cu shifted past J1, staircase fan above J7, staggered
    vias at the 0.5 mm FPC pitch; row C: dogbone vias, B.Cu straight to J7
    - camera RESET (GN17) / PWDN (GP16) swapped to A12 / B13, one via each,
    B.Cu into J1.17 / J1.18; FPGA .ice/.lpf/IO_REMAP updated
    - C19 parked for step 2; stale VSYS/LCD_BL_A vias and stubs removed
    - all 27 LCD nets + RESET/PWDN connected, no new DRC items, ERC 153
    [FCL.kicad_pcb, fpga-io.kicad_sch]
2026-11-08 remove 129 floating track segments board-wide
    Dangling segments (one end touching nothing) removed iteratively, plus
    sub-0.15 mm slivers. Vias kept: plane vias look dangling only because the
    zones are unfilled; flash escape vias wait for the flash chip. All routed
    buses (USB, camera, LCD, SD, JTAG) re-verified connected.
    [FCL.kicad_pcb]
2026-11-08 step 2, batch 1: place U1 support parts
    Config flash U10 on B under the USB pair beside its escape vias; 25 MHz
    oscillator Y1 on B below it; flash pull-ups, DONE/INITN pull-ups, U1
    decoupling (C19, C30, C48, C51, C52, RV3); camera pull-ups R7/R14/R17 and
    J1 decoupling C18/C36; ESP32 EN RC (R35, C81) beside U9. Corridors for
    the SD->U1 and ESP32->U1 links kept free. No new DRC items.
    [FCL.kicad_pcb]
2026-11-08 step 2, batch 2: regulators, backlight boost, IMU, RTC, coin cell, NTCs
    U4 next to L2 under the ESP32; U8 backlight boost with R18/R19/C38 by
    L4/D1 near J7; U5 3V3 buck block re-placed part by part on B below J1
    (old copied copper dropped, re-routed in step 3); IMU U22 + decoupling
    and pull-ups top-left on F; RTC U7 + 32k crystal + caps top-left; CR1225
    holder BAT1 left of J1; NTCs TH1-TH3 roughly under the cell centres;
    ADC divider parts near U21. No new DRC items.
    [FCL.kicad_pcb]
2026-11-08 step 2, batch 3: soft-power, LEDs, button pull-ups, bulk caps, servo resistors
    Soft-power/wake parts (D16, D17, D27, D28, D29, R3, R5, R6, R8, R13, R66,
    C14, C60, D12, D14, D15, Q2) near the power button and their nets; user
    LEDs D53/D54 + R69/R70 and D11 on F; button pull-ups R67/R68; C1, C16;
    433 MHz pad AE1; servo series resistors R78-R83 by the servo headers.
    Only B3/B4 (ESP32 BOOT/RESET, 6x6 tact) left off-board. No new DRC items.
    [FCL.kicad_pcb]
2026-11-08 smaller ESP32 buttons, J7 toward J1, LCD re-routed, last parts placed
    - B3/B4 to C&K KMR2 SMD tact switches (schematic + board; LCSC TBD)
    - J7 5.0 mm left (centre 2.7 mm from J1's), servo headers 2.05 mm left,
    TFT outline with J7, camera keep-out drawing with J1
    - LCD ribbon regenerated for the new J7; B levels lowered past R15
    - U5 buck group and TH3 re-placed clear of the ribbon; all parts on board
    - no new DRC items, ERC 153, parity only the known SD1 pins
    [FCL.kicad_pcb, wifi.kicad_sch]
2026-11-08 centre J7 under J1 after the owner's H3 move; keep the BAT1 rotation
    - owner: BAT1 rotated -35 deg for easier cell access, H3 moved to (46, 12.5)
    - servo headers 2.9 mm further left into the freed corner; J7 2.62 mm
    further left - J7 and J1 centres now both at x 34.88; TFT outline follows
    - LCD ribbon regenerated; U5 buck group re-placed clear of it (C6, RP3 on F)
    - BAT1 nudged 0.9 mm (rotation kept) to clear a BT32 pin and U2's pad
    - no new DRC items; all routed buses connected
    [FCL.kicad_pcb]
2026-11-08 step 3: remap and hand-route the ADC SPI (FPGA side)
    - ADC SPI on U1 outer balls E1/D1/C1/B1 (SDO/SCK/DIN/CNV) facing U21;
    IMU_INT1/2 moved to F3/E3
    - dogbone vias, B.Cu lanes beside and under Y1 into U21's SPI pins
    - VSYS jumper between (54.5,51.6) and (62.6,48.4) moved to In1 (power
    layer before GND); via moved off U21's SDO column; R8 parked
    - no new DRC items; ERC 153
    [FCL.kicad_pcb, fpga-io.kicad_sch]
2026-11-08 ADC (U21) wired to the FPGA only; nets renamed ADC_*
    Owner decision: FPGA is the main controller, the ESP32 gets ADC data over
    the serial link. ESP32 SPI pins disconnected, WIFI_GPIO47/48/35/36 renamed
    ADC_CNV/DIN/SCK/SDO, redundant local labels removed. FPGA-side route
    unchanged and connected. ERC 152.
    [FCL.kicad_pcb, fpga-io.kicad_sch, power.kicad_sch, wifi.kicad_sch]
2026-11-08 remove the GND track lattice under U1; one dogbone stub per GND pad
    337 F/B GND lattice segments removed (owner request); each GND ball and
    decap GND pad keeps one stub to its own via into the In2 GND plane; 18
    new GND vias added. U1 G11/P11/P12/P13 and C19.2 still need a GND via
    (listed in ROADMAP 4.34). No new DRC items; routed buses intact.
    [FCL.kicad_pcb]
2026-11-08 schematic: FPGA SD pins moved to U1 top-left balls (M17,U18,U17,U16,T16,R17,R16)
    Matches the board (parity clean). SD stays shared with the ESP32; the
    FPGA branch is not routed yet. Dead old-ULX3S ADC nets on those balls
    removed. ERC 146.
    [fpga-io.kicad_sch, ram.kicad_sch, usb.kicad_sch]
2026-11-08 clear the SD corridor between SD1 and U1's top-left corner
    C51 moved out from under U1's top-left (B); TH1 and TH2 shifted just
    outside the corridor (still near their cell centres). No routing yet.
    [FCL.kicad_pcb]
2026-11-08 DRU: BGA_U1_fanout prefers 0.1 mm tracks (opt) so the router fits between U1 balls
    Net classes default to 0.15 mm; the BGA rule only set a minimum, so the
    interactive router kept using 0.15 mm, which cannot pass a 0.4 mm ball gap.
2026-11-08 Route the SD FPGA branch: U1 top-left balls to the SD fan via the back-layer corridor
    - six SD lines (CLK, CMD, D0-D3) shared with the FPGA; card detect stays ESP32-only (M17 no-connect)
    - FPGA SD balls remapped so the lanes never cross: D2 U17, D3 U18, CMD R17, CLK T16, D0 U16, D1 R16
    - 0.1 mm escapes inside the BGA, 0.15 mm lanes north of TH1 to vias on the SD fan
    - TH1 moved 0.6 mm down to clear the lane band; includes the owner's top-left GND rework
    [FCL.kicad_pcb, ram.kicad_sch]
2026-11-08 Stitch plane pads: stub + via for every GND / 3V3 / 1V1 / 2V5 / VSYS pad without a plane path
    - ~180 vias placed at the nearest legal spot, DRC-checked and retried until no new violations
    - U1 centre balls with no free diamond linked to a neighbouring same-net ball that has a via
    - remaining off-island power pads listed in ROADMAP 4.36 for the power hookup
    [FCL.kicad_pcb]
2026-11-08 Route ESP32-FPGA links and 60+ misc signal connections (maze router, DRC-checked)
    - ESP32 TXD/RXD/GPIO0/13/14/21 to U1 L1/L2/F1/K1/K2/J1
    - small signal nets (LEDs, servo pins, CC, RTC osc, FPGA config, sense lines) where the router gave clean results
    - router now honours the larger of both nets' clearances and pad-local clearances
    [FCL.kicad_pcb]
2026-11-08 Route more local signal nets (ADC sense lines, VADC/VREF, wake, backlight anode, buttons) - DRC-checked
    [FCL.kicad_pcb]
2026-11-08 Route the config flash (U10) and re-route the ESP32-FPGA links around it
    - U10 rotated to 270 deg so its pins face the ULX3S escape vias; R28 (MISO pull-up) moved beside U10
    - nCS / MISO hand-routed from the existing escapes; other flash nets and pull-ups via the maze router
    - three ESP32 links (TXD, RXD, GPIO13) use short In1 runs to pass the flash
    - router fixes: own-copper shortcut no longer ignores U1 balls; optional In1 layer
    [FCL.kicad_pcb]
2026-11-08 Route 25-ish more signals (servo PWM1, power button, CLK_25MHz, 433 MHz antenna, FPDI_SCL, GP16/GN17, ADC sense) - DRC-checked
    [FCL.kicad_pcb]
2026-11-09 Clean-up before hand routing: remove dangling tracks/vias and dead stubs, ungroup, fix 3D model paths
    DRC: no new violations; unconnected 152 -> 141 (dead islands removed).
    J17 uses the GCT USB4105 model (same land pattern as HCTL HC-TYPE-C-16P-01A).
    [FCL.kicad_pcb]
2026-11-09 Move 9 open FPGA nets to the closest free balls with a via spot
    IMU_SCL E7->P16, IMU_SDA D7->K17, IMU_INT1 F3->K16 (left edge, toward the IMU);
    SRV_PWM6/4/2/5/3 -> D17/D16/D15/D14/D13 (bottom-left, toward the servo resistors);
    WIFI_EN J5->N3. All 3.3 V banks; not used by the FPGA design (no .lpf change).
    U1 pins match the schematic netlist (379/379); ERC unchanged; DRC no new violations.
    [FCL.kicad_pcb, fpga-io.kicad_sch, ram.kicad_sch, usb.kicad_sch]
2026-11-09 SD1: Molex 104031-0811 STEP model from molex.com, aligned to the pads
    Rotated 180 deg, offset (44.895, -1.55, 0.737) mm so the 8 contact tails sit centred on pads 1-8
    and the shell tabs on the GM pads. Set on the board and in the fcl_local footprint.
    [FCL.kicad_pcb]
2026-11-09 Y2: real 8.7x3.5x2.5 mm crystal model (ABS25) instead of a 1206 stand-in; keep SD1 X tweak
    Y2 (IQD LFXTAL016178, 8.7x3.7 mm, 5.5 mm lead pitch) uses the project ABS25 model, rotated 90 deg and
    shifted 2.8 mm to the pad centre, on the board and in the abs07 footprint.
    SD1 model X offset 44.395 (owner's adjustment) copied into the fcl_local footprint.
    [FCL.kicad_pcb]
2026-11-09 Libraries: copy board 3D-model settings into project footprints
    - 18650 holders (-04-J spring, -05-J pad): owner's offset (0, 0.525, 8.5) mm
    - L_1008_1210, BGA-381, SOA008, TSOT-25, SOT96-1: working KiCad 10 model paths (were broken KISYS3DMOD links);
    these five files are re-saved in the current format (pads, graphics and attributes verified unchanged)
    Every project-library footprint on the board now has the same 3D model settings as its library copy.
2026-11-09 misc cleanup
    [FCL.kicad_pcb]
2026-11-10 Unroute FPGA legs of 20 low-priority nets for one-chip-at-a-time rerouting
    ADC, IMU_SDA, buttons, LED1, SRV_PWM1, ESP32 link, SHUTDOWN, USER_PROGRAMN and
    FPDI I2C lose only the copper serving U1. SDRAM, LCD, camera, SD card and power stay.
    [FCL.kicad_pcb]
2026-11-11 Tear up all SD-card copper (SD_CD/CLK/CMD/D0-D3) for a manual re-lay; keep R8 move
    150 tracks and 12 vias removed; SD1, U9 and U1 pads untouched.
    [FCL.kicad_pcb]
2026-11-11 Reroute SD card: SD1->ESP32 on F.Cu, FPGA legs tap at SD1 pads and run south on B.Cu
    FPGA legs shortened from ~40 mm to 27-35 mm; no ESP32 pin changes needed.
    DRC clean for SD nets; all SD nets connected.
    [FCL.kicad_pcb]
2026-11-11 Tear up servo connector, PWREN, WIFIEN, LED1_A, FLASH_nCS and FPGA_DONE copper
    160 tracks and vias removed for a manual re-lay; GND and SERVO_V untouched.
    [FCL.kicad_pcb]
2026-11-11 J4/JTAG: swap ESP32 JTAG pins and re-lay; TCK straight into ESP32 pad 11
    ESP32-S3: TCK -> pad 11 (GPIO18), TDO -> pad 12 (GPIO8), TMS -> pad 17 (GPIO9),
    TDI pad 18 (GPIO10). Schematic labels and PCB pad nets swapped together.
    TCK 48 -> 35 mm. DRC clean for JTAG. Also carries the owner's C15 move and
    SD touch-ups saved from pcbnew.
    [FCL.kicad_pcb, wifi.kicad_sch]
2026-11-11 User edits in pcbnew: ADC (U21/U17) area rework, JTAG/USB touch-ups
    [FCL.kicad_pcb]
2026-11-11 Park servo, battery charger, ADC, flash and power traces off-board for re-placement
    Power-rail traces up 100 mm (parts and planes stay; U1 BGA fanout kept),
    servos left/down 100, TP4056/LM66100 power path right 100 (holders stay),
    ADC + TH down 100, SPI flash left 100. Group copper moved with each group
    up to the FPGA ball. Removed the floating copper the move left on the board.
    [FCL.kicad_pcb]
2026-11-11 User edits in pcbnew: battery charger and flash re-placed on board, servo resistors lined up, SD touch-ups
    [FCL.kicad_pcb]
2026-11-11 Park U3-U5 buck regulators (right 100) and U7 RTC (left 100) off-board with their copper
    P1V1/P2V5 traces parked up earlier rejoin the bucks.
    [FCL.kicad_pcb]
2026-11-11 Add scripts/open_kicad.ps1: open KiCad home, schematic (left) and PCB (right) for review
2026-11-12 User edits in pcbnew: RTC area routing (OSCI_32k, RTCVDD), WAKEUPn copper removed
    [FCL.kicad_pcb]
2026-11-12 Add LIS2MDL magnetometer U25 on the IMU I2C bus, DRDY to FPGA L17
    Schematic: U25 + C86 220 nF (C1 pin), C87 100 nF + C88 10 uF (Vdd), C89 100 nF
    (Vdd_IO) on imu sheet; CS high for I2C (addr 0x1E); MAG_DRDY label on U1 L17 in
    ram sheet (was no-connect). IMU note updated to the current FPGA balls.
    PCB: footprints added and linked, nets set, grouped near the top-left; unrouted.
    [FCL.kicad_pcb, imu.kicad_sch, ram.kicad_sch]
2026-11-12 Add peripherals sheet: LPS22DF barometer, VL53L1X ToF, ICS-43434 mic, MAX98357A amp + speaker J8, TP1-TP13
    New peripherals.kicad_sch (page 13). Barometer and ToF share the IMU I2C bus
    (0x5C / 0x29); BARO_INT, TOF_XSHUT, TOF_INT go to FPGA M17, N16, N17. Mic and
    amp share I2S on ESP32 GPIO35/36 with data on 37 (spk) / 38 (mic); AMP_SD on
    GPIO47 with a 100k pull-down. Footprints are parked as grouped rows left of the
    board's top-left corner, not routed. ERC adds only the U28 EP/GND warning; DRC
    shows nothing on the new parts and parity is clean.
    Docs: ESP32_PINS JTAG rows corrected to the routed map, audio pins added;
    IO_REMAP records L17/M17/N16/N17; ROADMAP Phase 3e.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
    [FCL.kicad_pcb, FCL.kicad_sch, peripherals.kicad_sch, ram.kicad_sch, wifi.kicad_sch]
2026-11-14 Pack the off-board parts into one compact two-sided cluster left of the board
    All parked parts (ADC block, U3-U5 bucks, power latch, RTC, button, coin cell,
    test points) now sit in a 39 x 30 mm cluster 1.5 mm left of the board edge
    (was spread up to 230 mm away). No traces run to the board.
    - ADC: U21 core moved rigidly with its routing; dividers, thermistor network,
    LDO and VADC caps packed around the pins they serve.
    - Bucks: three identical tight cells (Cin | IC | L, Cout row under, FB divider on
    the back under the IC). Their old partial copper was dropped.
    - Power latch on the back under BAT1, RTC on the back under B0, test points on
    the back under the buck output caps.
    - 26 floati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
    [FCL.kicad_pcb]
2026-11-14 User edits in pcbnew (checkpoint before moving FPGA decoupling caps)
    [FCL.kicad_pcb]
2026-11-14 Move U1's back-side decoupling caps +100 mm right with their traces; open editors linked to the project
    - C17 C19 C20 C25-C32 C48 C52 (10x 22nF, 3x 2.2uF, back side under U1) moved
    +100 mm in X with the 47 traces and 3 drop vias that ran from their pads.
    U1's ball/fanout vias stay in place, so the BGA escape is untouched; those
    vias now show as dangling on the back until the caps return.
    - scripts/open_kicad.ps1: start KiCad on FCL.kicad_pro and open the schematic
    and PCB from the project manager (Ctrl+E / Ctrl+P), so both editors run inside
    the project and cross-probing works. Reuses a KiCad only if it has FCL open.
    [FCL.kicad_pcb]
